Waterfox/razbot/Documentation/Pictures/2014-11-12 20.54.26.jpg

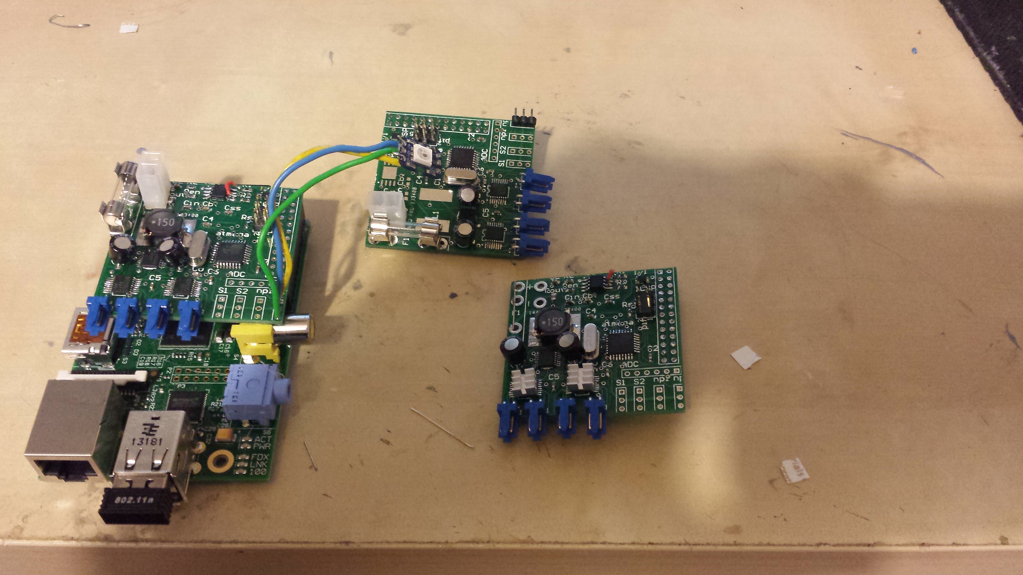
Documentation/Pictures/2014-11-12 20.54.26.jpg
