Waterfox/razbot/Documentation/Pictures/IMG_1995.JPG

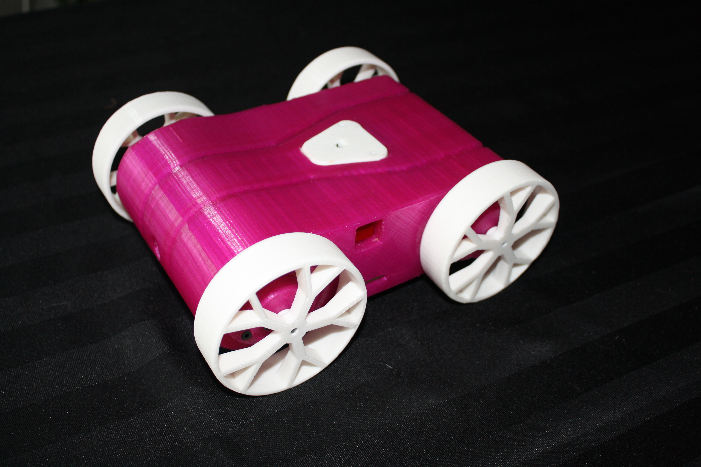
Documentation/Pictures/IMG_1995.JPG
