Waterfox/razbot/Documentation/Pictures/IMG_1996.JPG

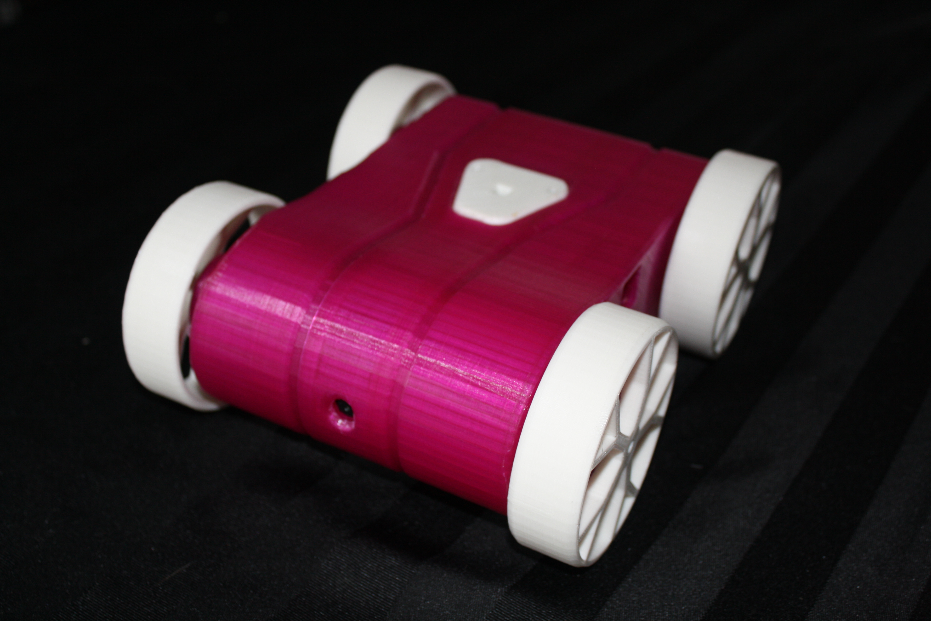
Documentation/Pictures/IMG_1996.JPG
