Waterfox/razbot/Documentation/Pictures/IMG_1997.JPG

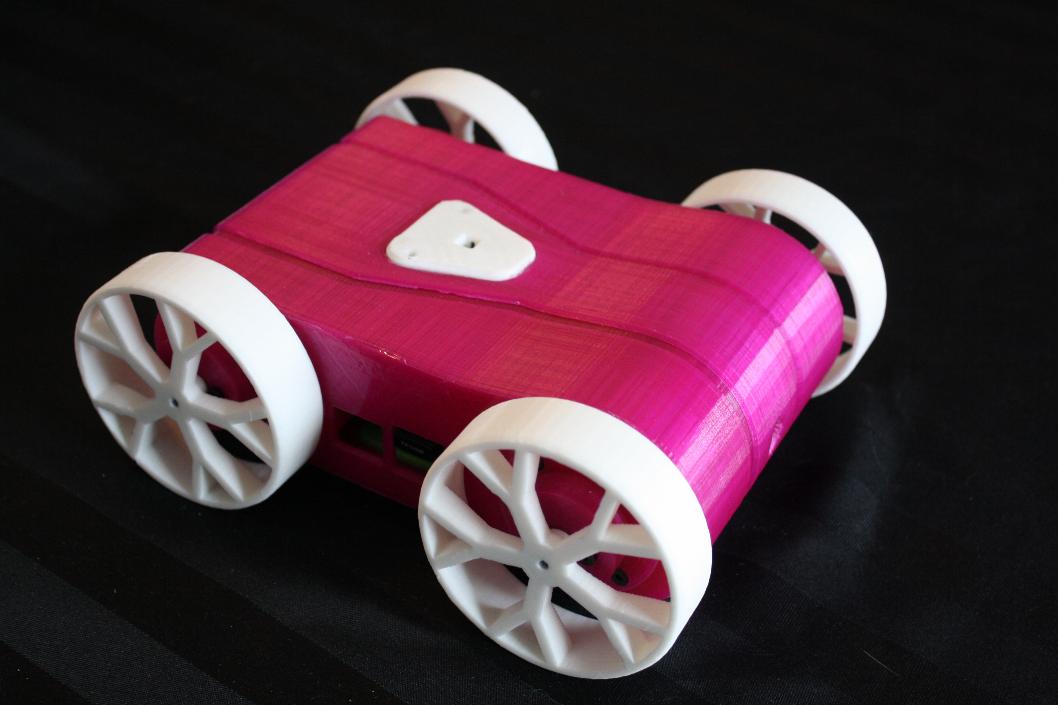
Documentation/Pictures/IMG_1997.JPG
