Waterfox/razbot/Documentation/Pictures/IMG_1998.JPG

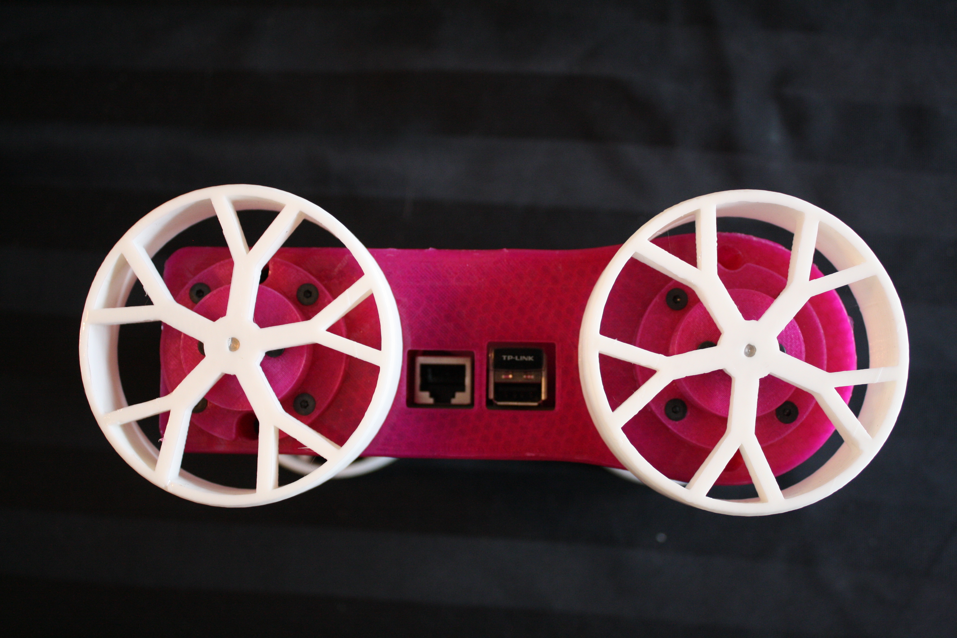
Documentation/Pictures/IMG_1998.JPG
