Waterfox/razbot/Documentation/Pictures/IMG_1999.JPG

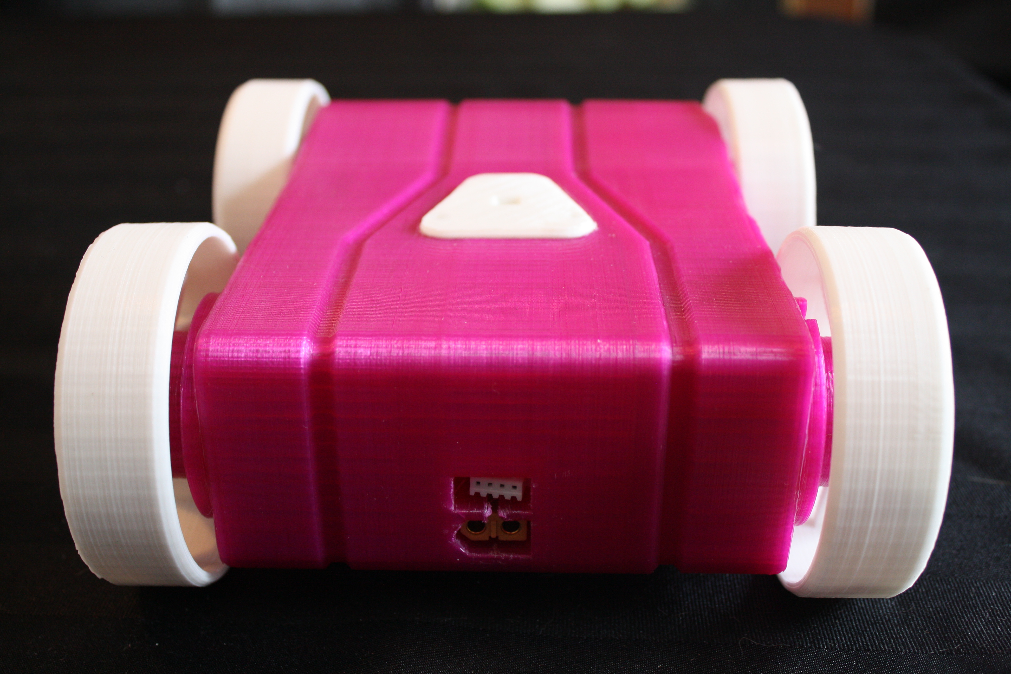
Documentation/Pictures/IMG_1999.JPG
