Waterfox/razbot/Documentation/Pictures/IMG_2000.JPG

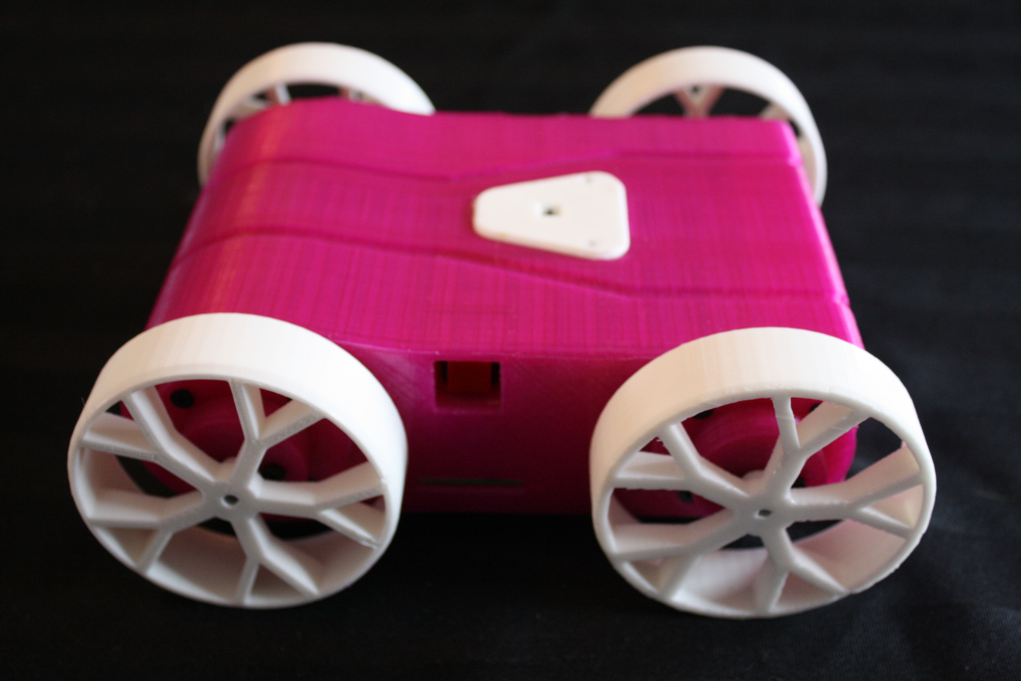
Documentation/Pictures/IMG_2000.JPG
