Waterfox/razbot/Documentation/Pictures/IMG_2001.JPG

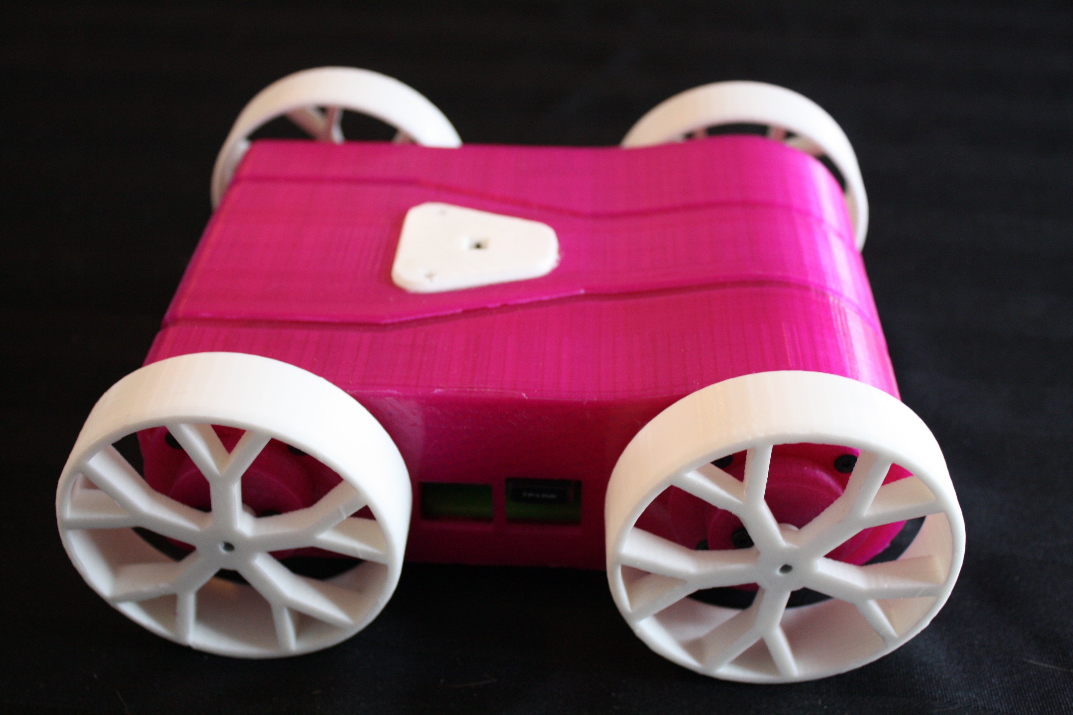
Documentation/Pictures/IMG_2001.JPG
