Waterfox/razbot/Documentation/Pictures/IMG_2002.JPG

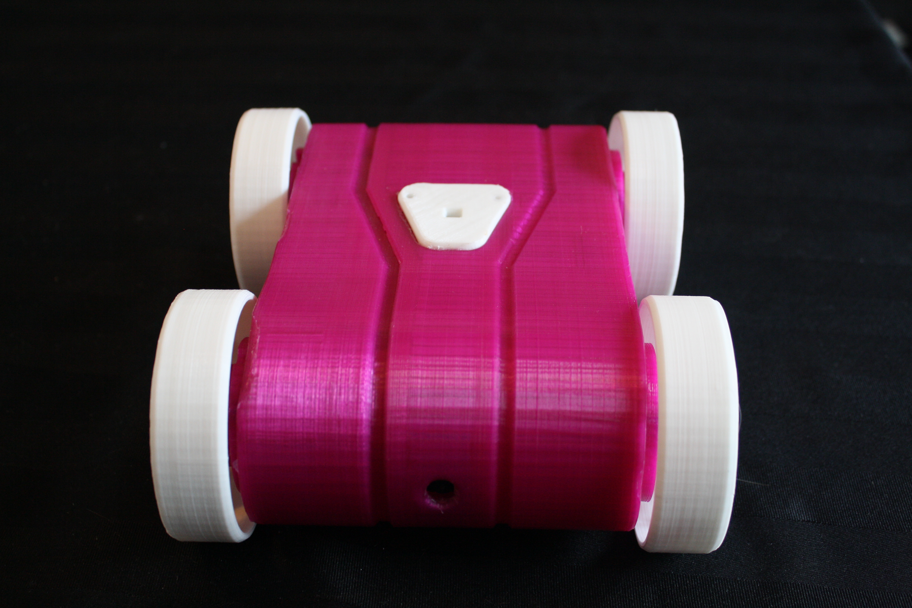
Documentation/Pictures/IMG_2002.JPG
