Waterfox/razbot/Documentation/Pictures/IMG_2003.JPG

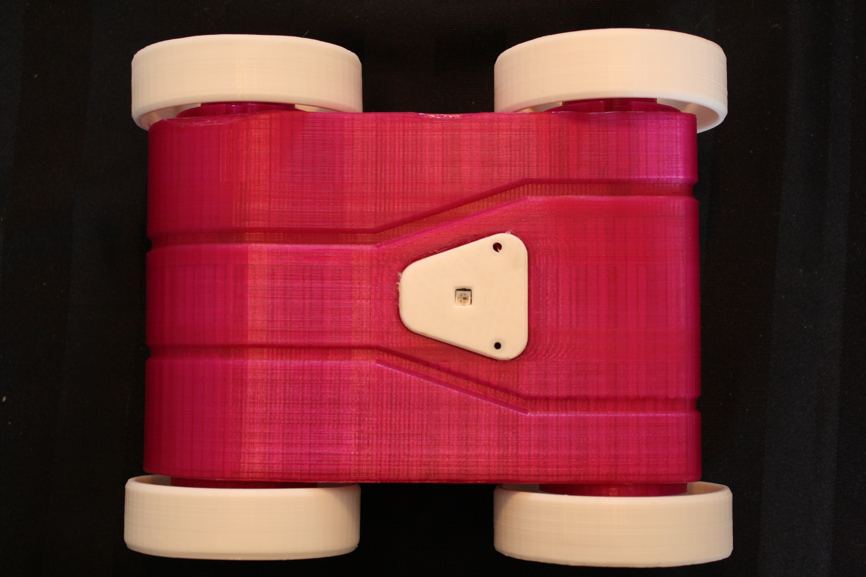
Documentation/Pictures/IMG_2003.JPG
