Waterfox/razbot/Documentation/Pictures/IMG_2514.JPG

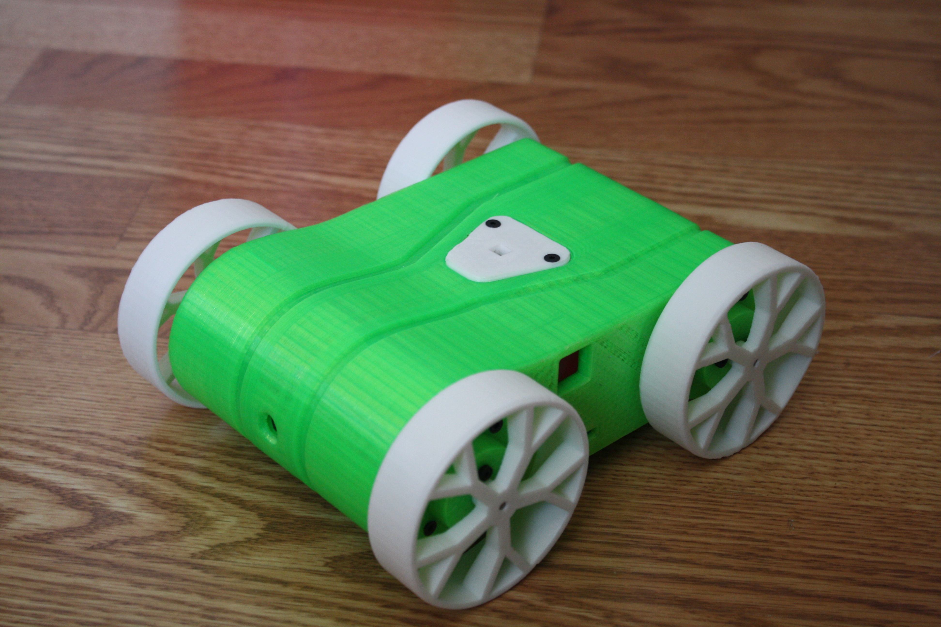
Documentation/Pictures/IMG_2514.JPG
