Waterfox/razbot/Documentation/Pictures/IMG_2515.JPG

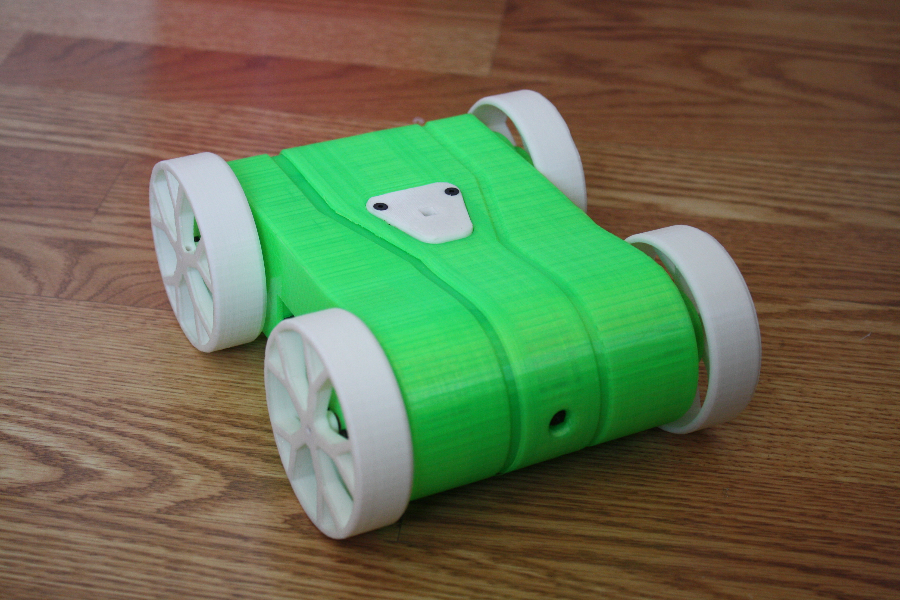
Documentation/Pictures/IMG_2515.JPG
