Waterfox/razbot/Documentation/Pictures/IMG_2516.JPG

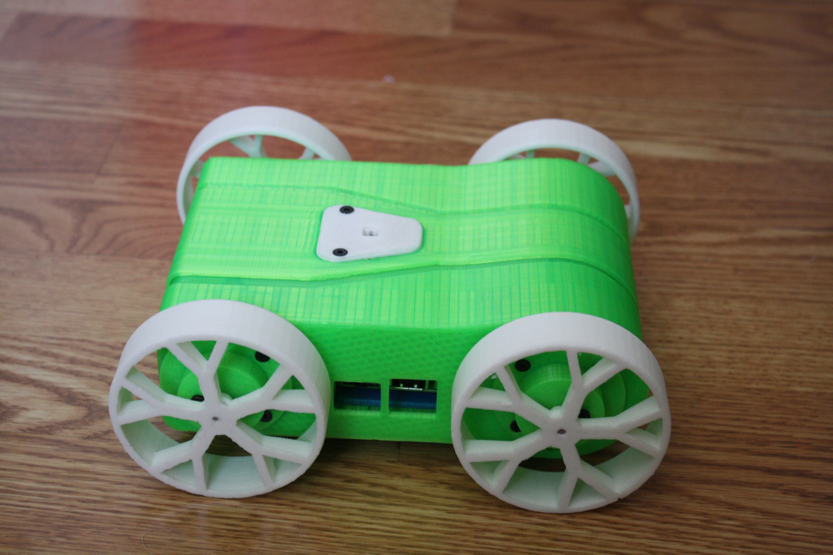
Documentation/Pictures/IMG_2516.JPG
