Waterfox/razbot/Documentation/Pictures/IMG_2517.JPG

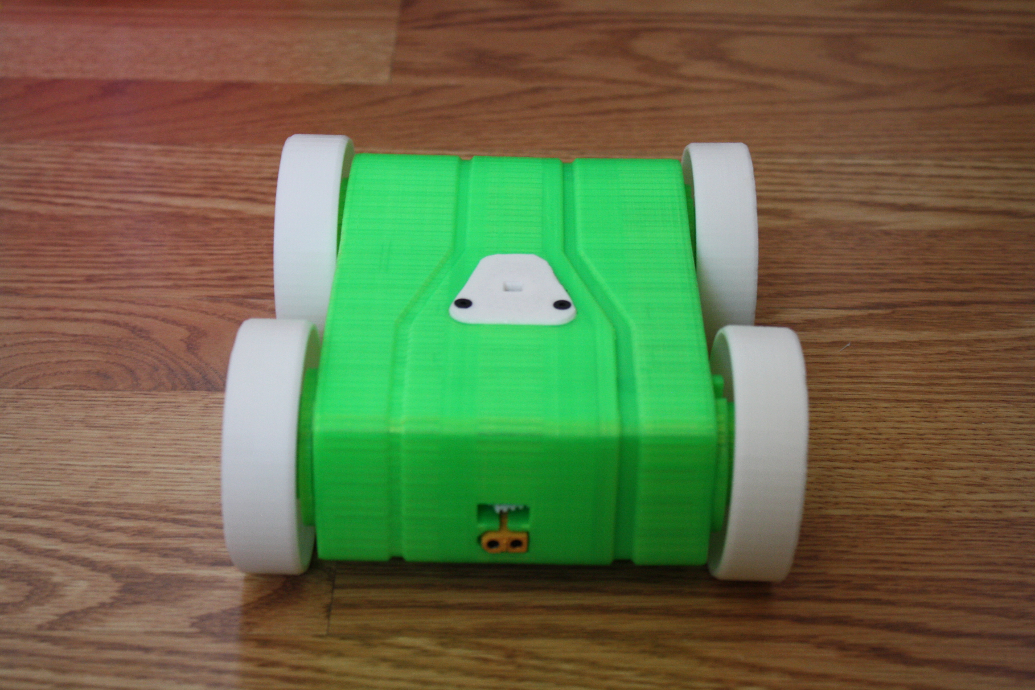
Documentation/Pictures/IMG_2517.JPG
