Waterfox/razbot/Documentation/Pictures/IMG_2874.JPG

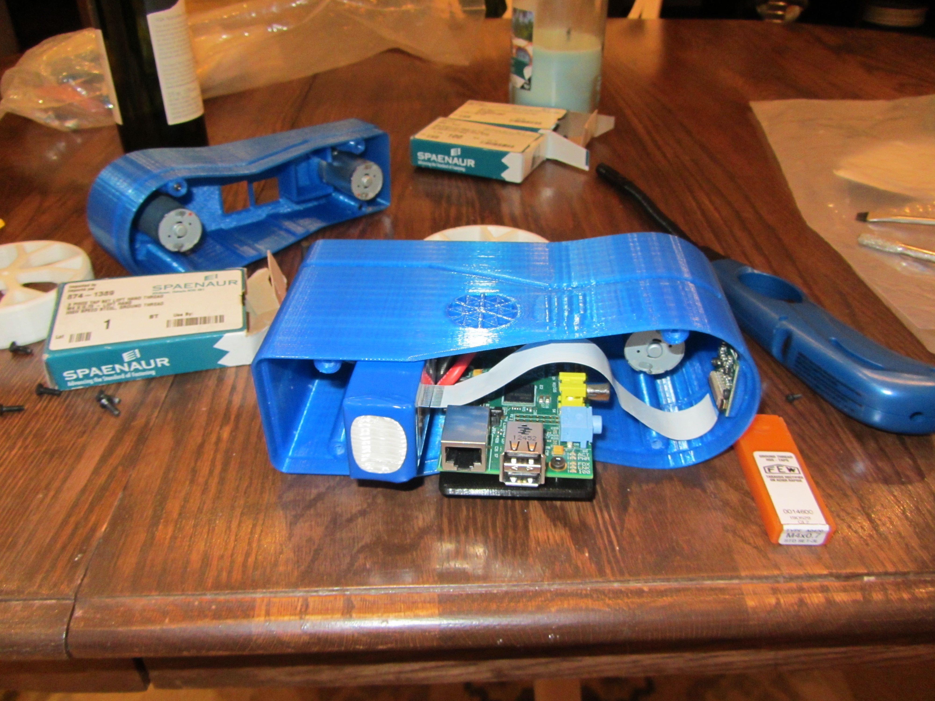
Documentation/Pictures/IMG_2874.JPG
