Waterfox/razbot/Documentation/Pictures/IMG_2875.JPG

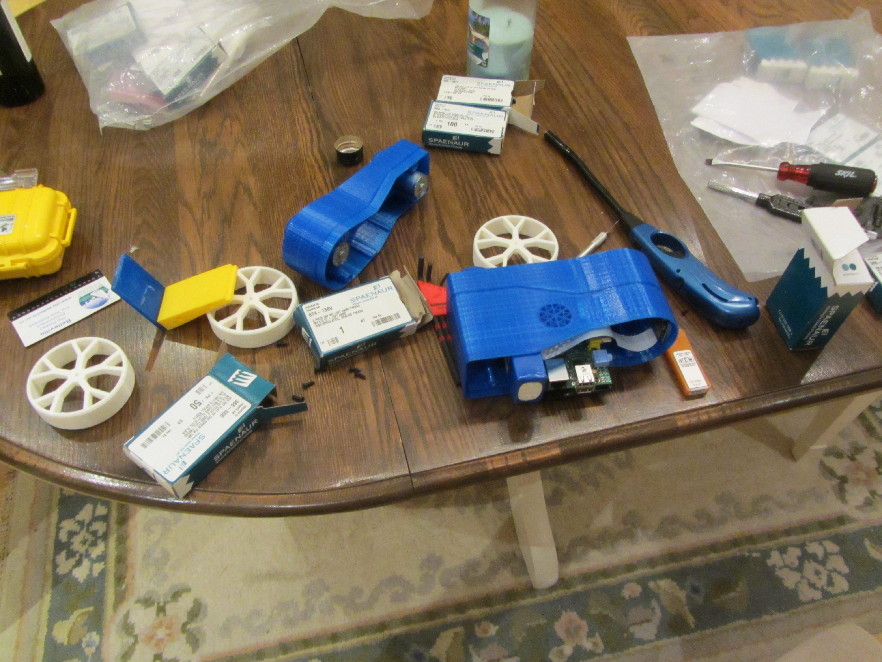
Documentation/Pictures/IMG_2875.JPG
