Waterfox/razbot/Documentation/Pictures/IMG_2878.JPG

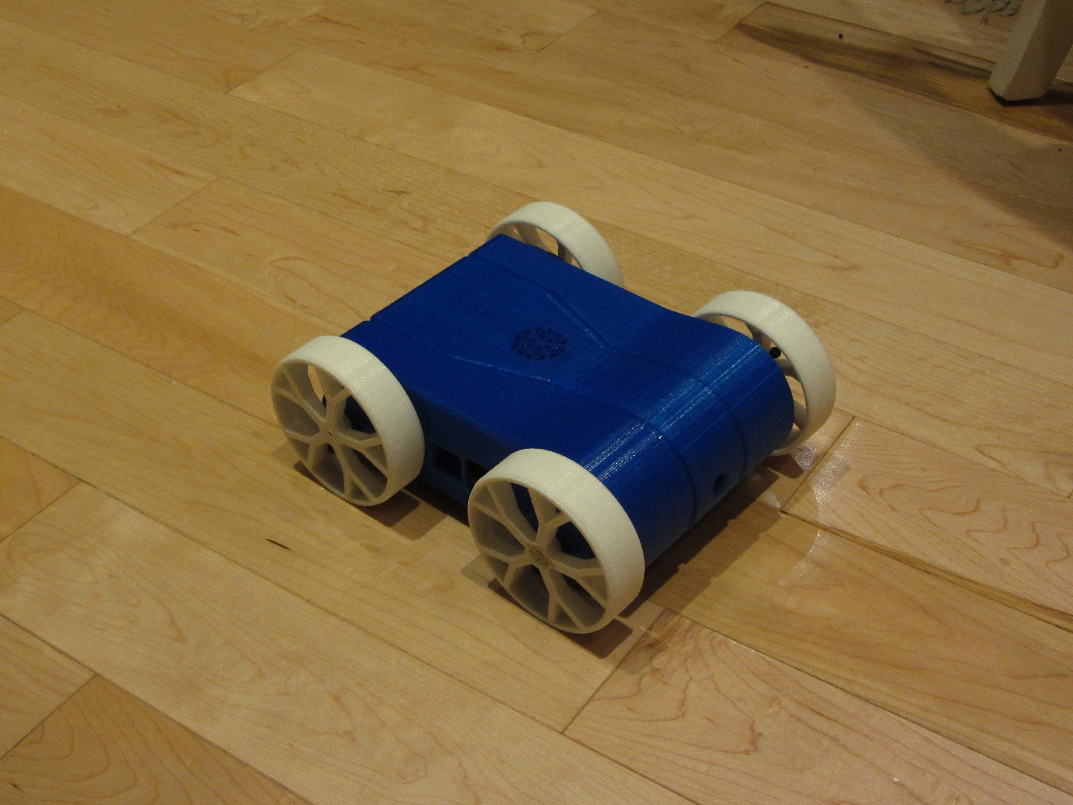
Documentation/Pictures/IMG_2878.JPG
