Waterfox/razbot/Documentation/Pictures/IMG_2879.JPG

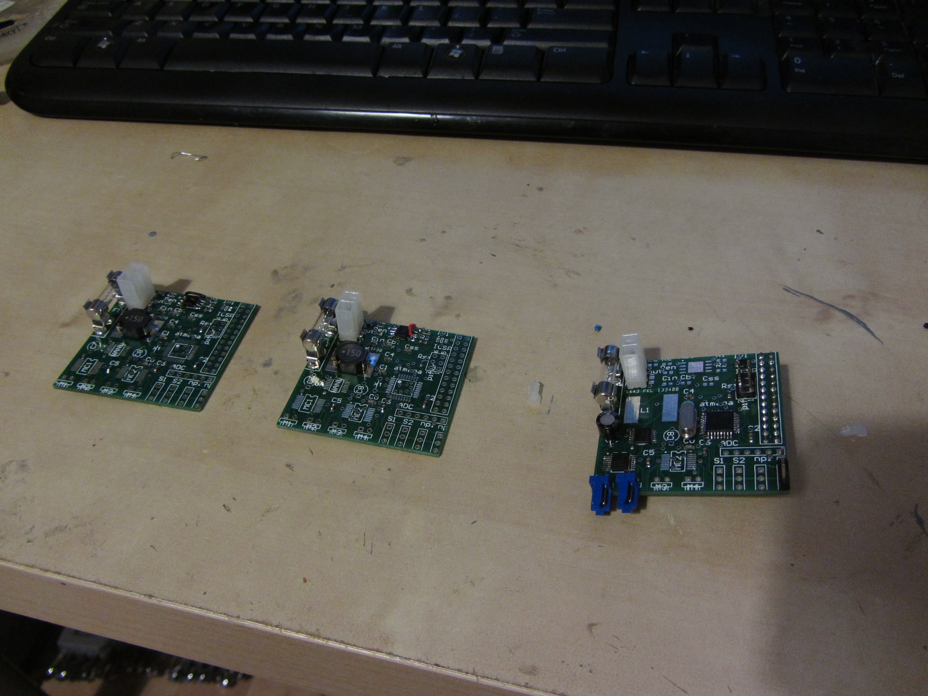
Documentation/Pictures/IMG_2879.JPG
