Waterfox/razbot/Documentation/Pictures/IMG_3035.JPG

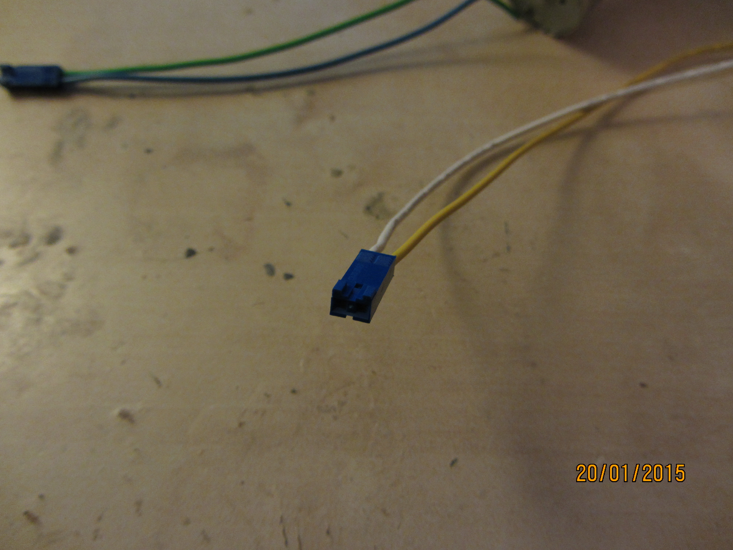
Documentation/Pictures/IMG_3035.JPG
