Waterfox/razbot/Documentation/Pictures/IMG_3036.JPG

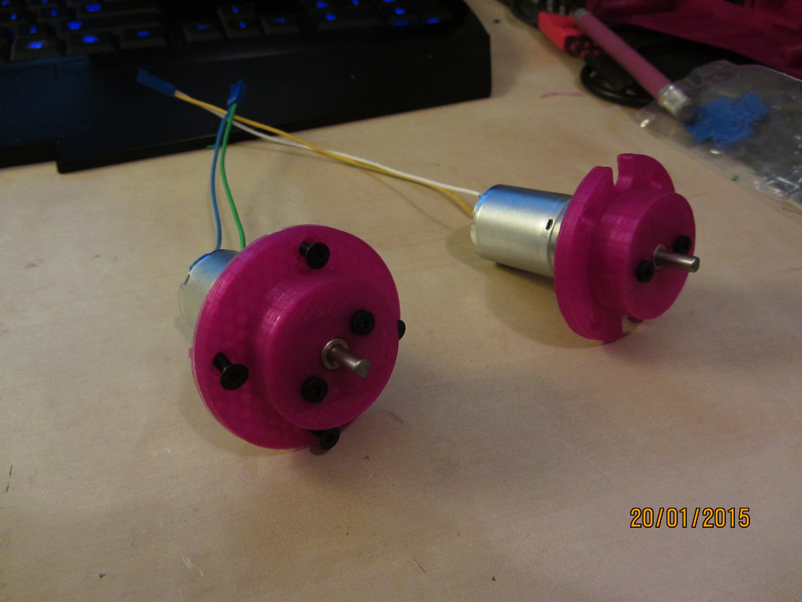
Documentation/Pictures/IMG_3036.JPG
