Waterfox/razbot/Documentation/Pictures/IMG_3037.JPG

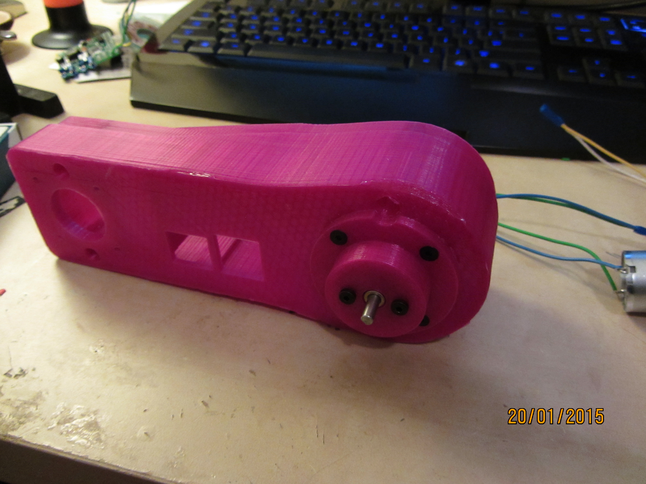
Documentation/Pictures/IMG_3037.JPG
