Waterfox/razbot/Documentation/Pictures/IMG_3039.JPG

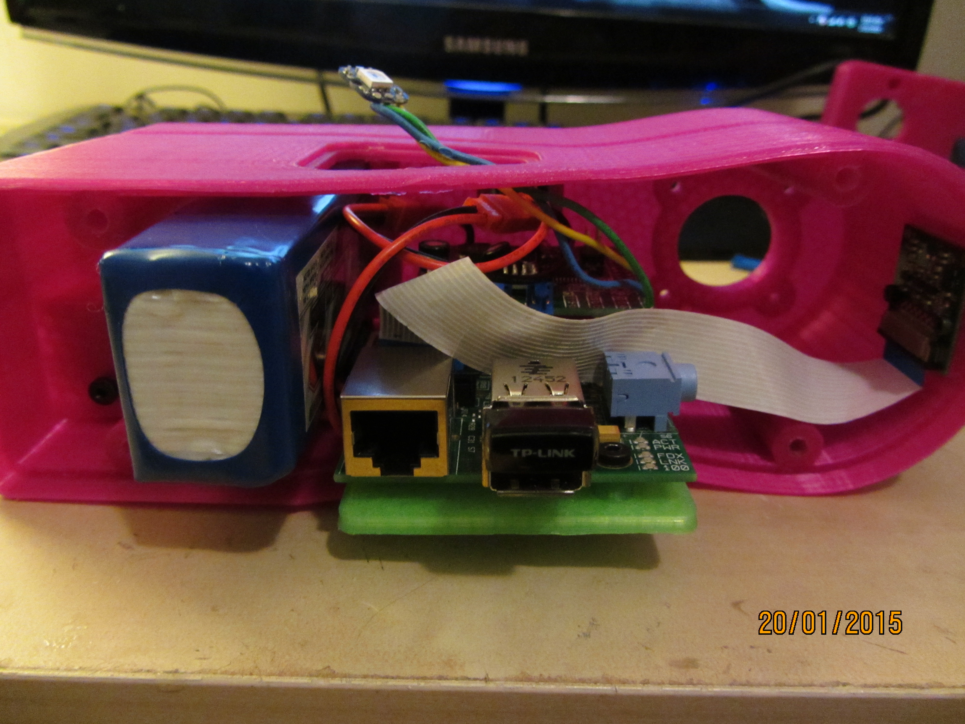
Documentation/Pictures/IMG_3039.JPG
