Waterfox/razbot/Documentation/Pictures/razbot3.jpg

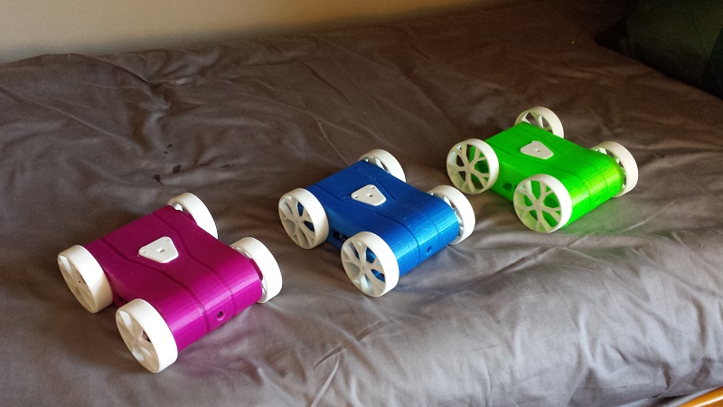
Documentation/Pictures/razbot3.jpg
