Waterfox/razbot/razbot_CAD/raspberry_pi_camera/RasPi_Camera.SLDASM

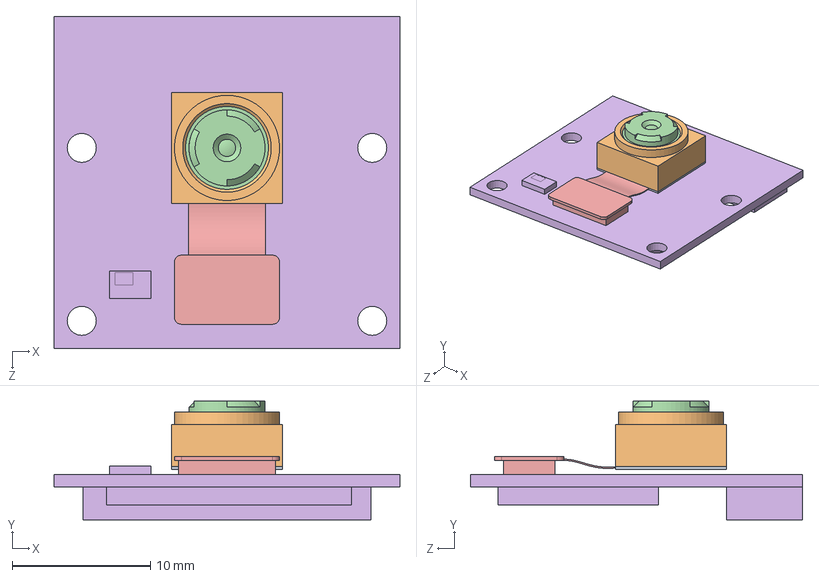
[picture p25: CAD file, 2015-07-30]
razbot_CAD/raspberry_pi_camera/RasPi_Camera.SLDASM
25.0 x 8.60 x 24.0 mm
OVA5647
OVA5647_Housing
OVA5647_IR-Glas
OVA5647_Lens
OVA5647_Pigtail
RasPi_Camera_Board
