Waterfox/razbot/razbot_CAD/Side_Assem_Right.SLDASM

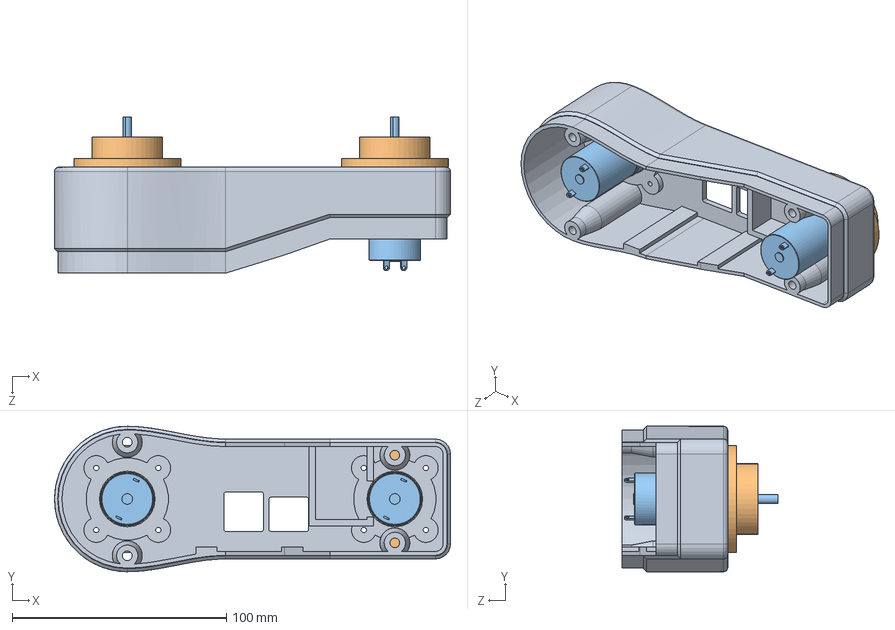
[picture p26: CAD file, 2015-07-30]
razbot_CAD/Side_Assem_Right.SLDASM
185.0 x 68.0 x 73.0 mm
Side_Right
motor_holder_r0.4 x 2
Motor_25x55_gear x 2
