Waterfox/razbot/razbot_CAD/Side_Assem_Left.SLDASM

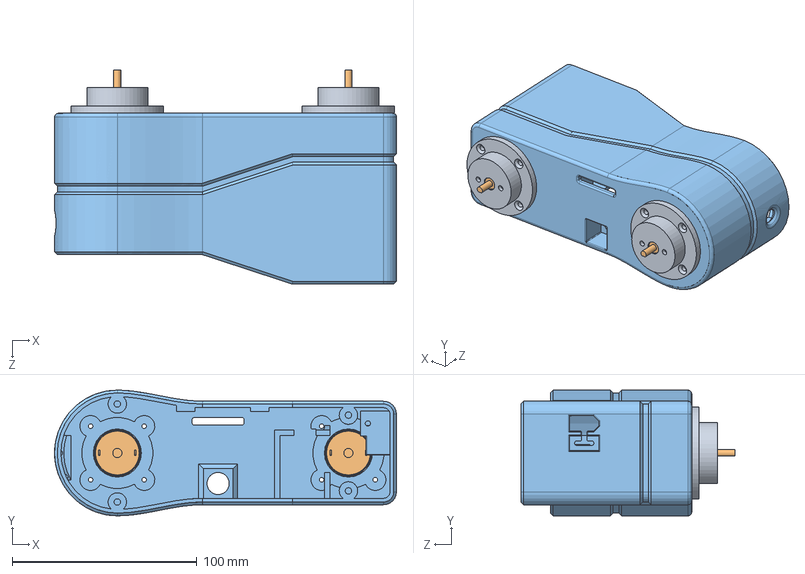
[picture p27: CAD file, 2015-07-30]
razbot_CAD/Side_Assem_Left.SLDASM
185.0 x 68.0 x 116.0 mm
motor_holder_r0.4 x 2
Motor_25x55_gear x 2
Side_Left
