Waterfox/razbot/razbot_CAD/razbot_simple.SLDASM

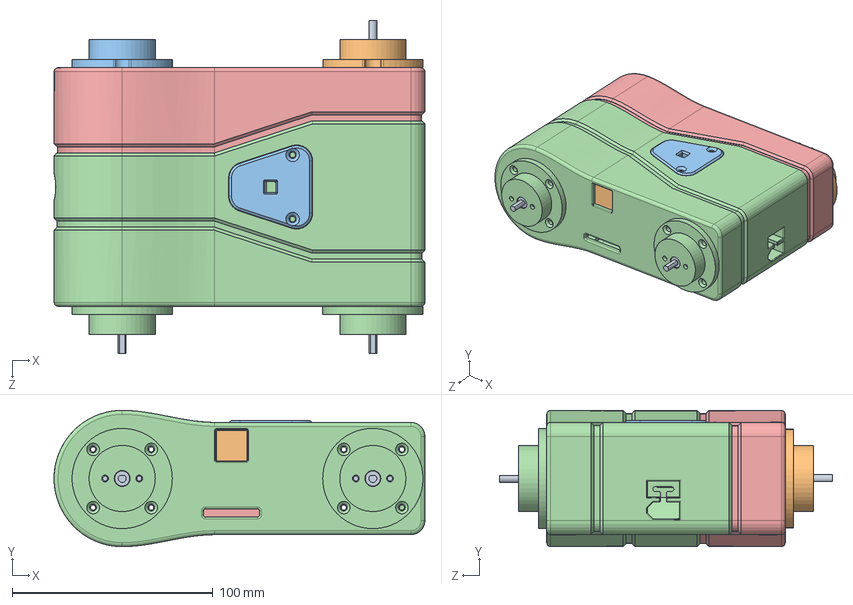
[picture p29: CAD file, 2015-03-07]
razbot_CAD/razbot_simple.SLDASM
185.0 x 68.0 x 166.0 mm
25x55_gear_motor x 3
motor_holder_r0.5
motor_holder_r0.4 x 2
OVA5647
OVA5647_Housing
OVA5647_IR-Glas
OVA5647_Lens
OVA5647_Pigtail
switch_pwr
Top_Plate2
Side_Left_2
Side_Right_2
