Waterfox/razbot/razbot_CAD/Motor_Assem.SLDASM

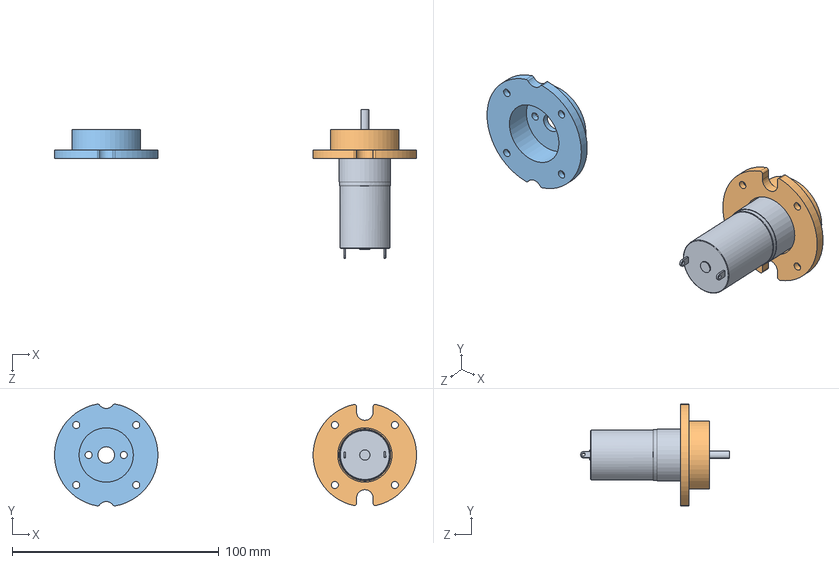
[picture p30: CAD file, 2015-03-07]
razbot_CAD/Motor_Assem.SLDASM
175.0 x 49.3 x 71.9 mm
25x55_gear_motor
motor_holder_r0.5
