Waterfox/razbot/razbot_CAD/raspberry_pi/raspberry_pi__USB_x2.SLDASM

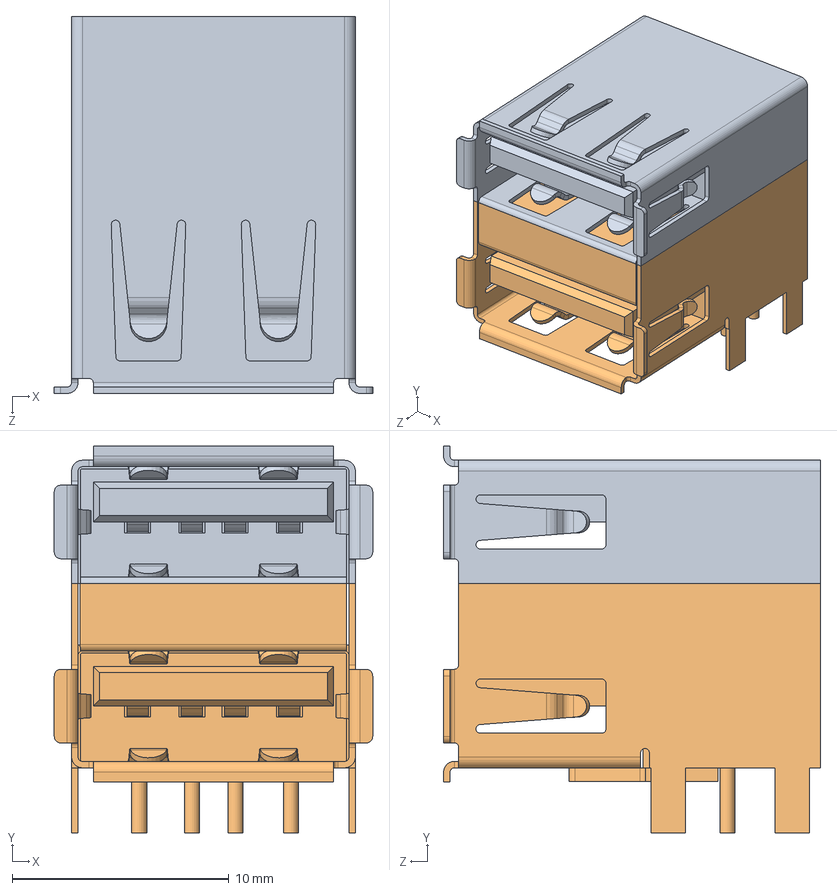
[picture p31: CAD file, 2015-07-30]
razbot_CAD/raspberry_pi/raspberry_pi__USB_x2.SLDASM
14.7 x 17.9 x 17.4 mm
raspberry_pi__USB_x2_part1
raspberry_pi__USB_x2_part2
