Waterfox/razbot/razbot_CAD/raspberry_pi/raspberry_pi__15_pin_FFC_Connector.SLDASM

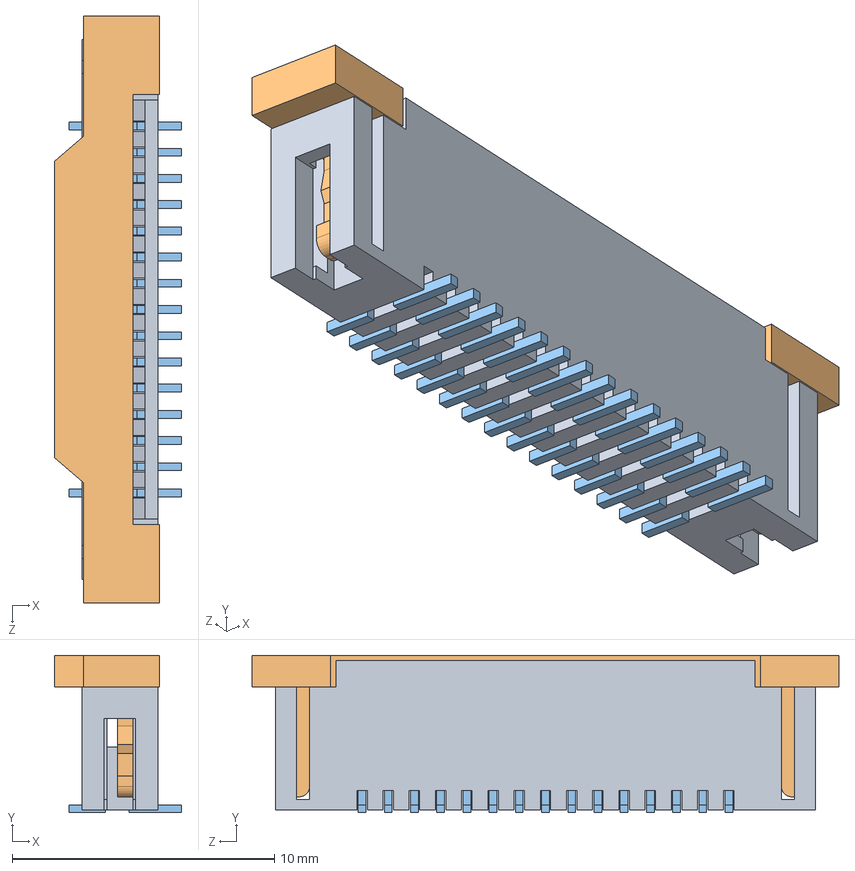
[picture p35: CAD file, 2015-07-30]
razbot_CAD/raspberry_pi/raspberry_pi__15_pin_FFC_Connector.SLDASM
4.85 x 6.00 x 22.4 mm
raspberry_pi__15_pin_FFC_Connector_body
raspberry_pi__15_pin_FFC_Connector_locker
raspberry_pi__15_pin_FFC_Connector_pins x 15
