Waterfox/razbot/razbot_CAD/raspberry_pi/raspberry_pi__micro_USB.SLDASM

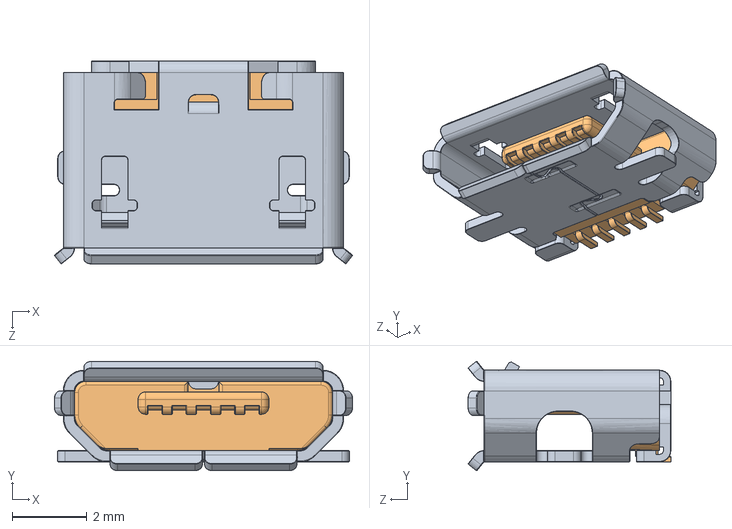
[picture p36: CAD file, 2015-07-30]
razbot_CAD/raspberry_pi/raspberry_pi__micro_USB.SLDASM
7.97 x 2.92 x 5.43 mm
raspberry_pi__micro_USB_cover
raspberry_pi__micro_USB_contacts
