Waterfox/razbot/razbot_CAD/gazeboSTL/wheel_3.STL

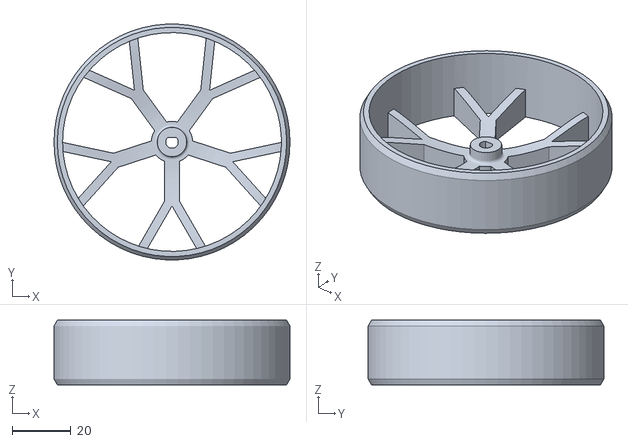
[picture p37: CAD file, 2015-03-07]
razbot_CAD/gazeboSTL/wheel_3.STL
80.0 x 79.9 x 22.0
