Waterfox/razbot/razbot_CAD/Motor_25x55_gear.SLDPRT

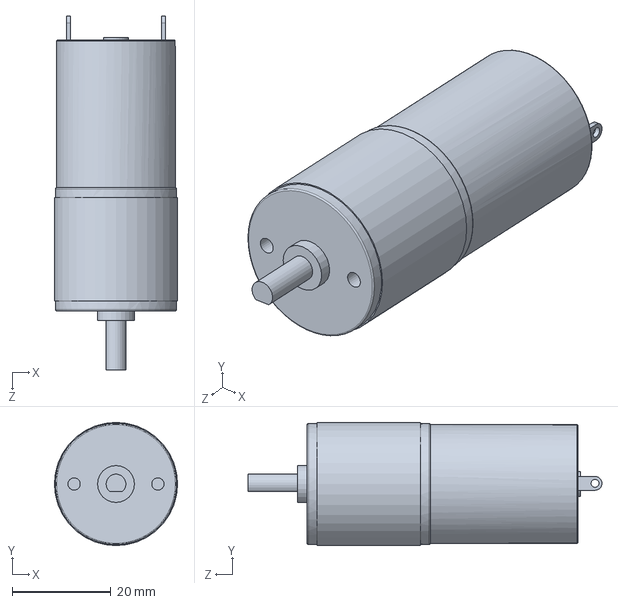
[picture p38: CAD file, 2015-07-30]
razbot_CAD/Motor_25x55_gear.SLDPRT
25.0 x 25.0 x 71.9 mm
