Waterfox/razbot/razbot_CAD/raspberry_pi/raspberry_pi__15_pin_FFC_Connector_locker.SLDPRT

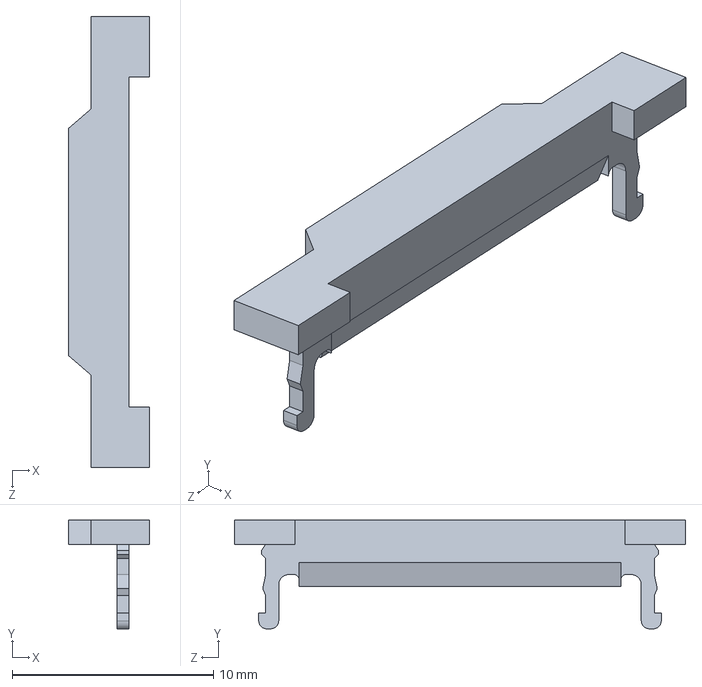
[picture p39: CAD file, 2015-07-30]
razbot_CAD/raspberry_pi/raspberry_pi__15_pin_FFC_Connector_locker.SLDPRT
4.00 x 5.40 x 22.4 mm
