Waterfox/razbot/razbot_CAD/raspberry_pi_acc/USBwifi.SLDPRT

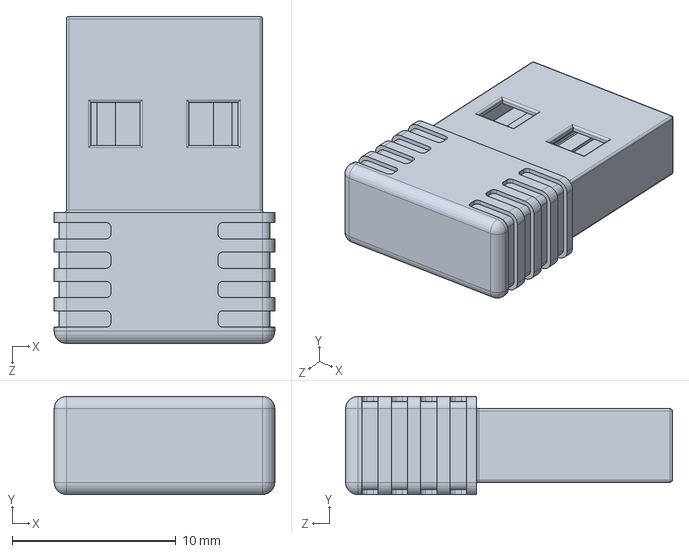
[picture p40: CAD file, 2015-07-30]
razbot_CAD/raspberry_pi_acc/USBwifi.SLDPRT
13.5 x 6.00 x 20.0 mm
