Waterfox/razbot/razbot_CAD/raspberry_pi_camera/OVA5647_IR-Glas.SLDPRT

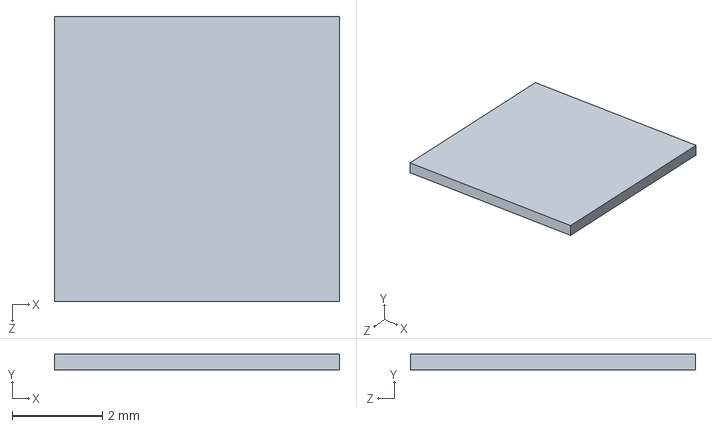
[picture p41: CAD file, 2015-07-30]
razbot_CAD/raspberry_pi_camera/OVA5647_IR-Glas.SLDPRT
6.30 x 0.35 x 6.30 mm
