Waterfox/razbot/razbot_CAD/razbot_STL/PiTrayB+.STL

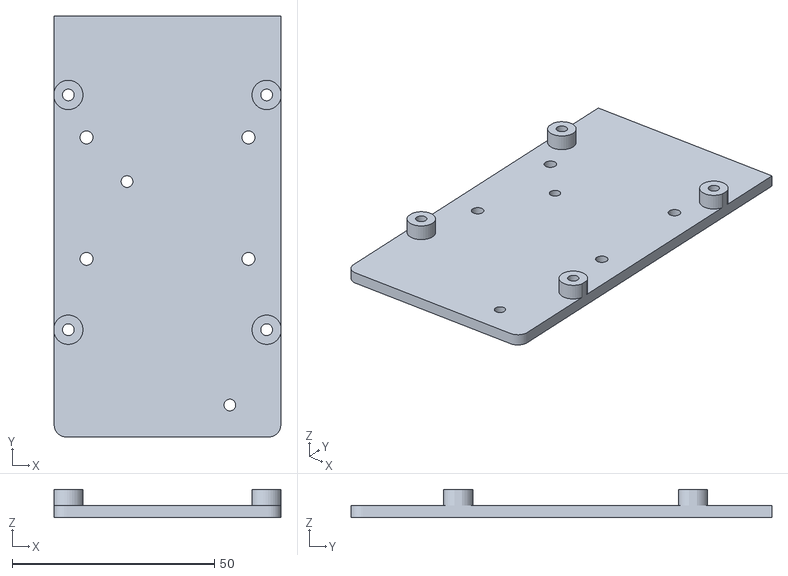
[picture p42: CAD file, 2015-03-08]
razbot_CAD/razbot_STL/PiTrayB+.STL
56.0 x 104.0 x 7.00
