Waterfox/razbot/razbot_Software_RPi/Razbot_URDF/razbotURDF/meshes/wheel_1_link.STL

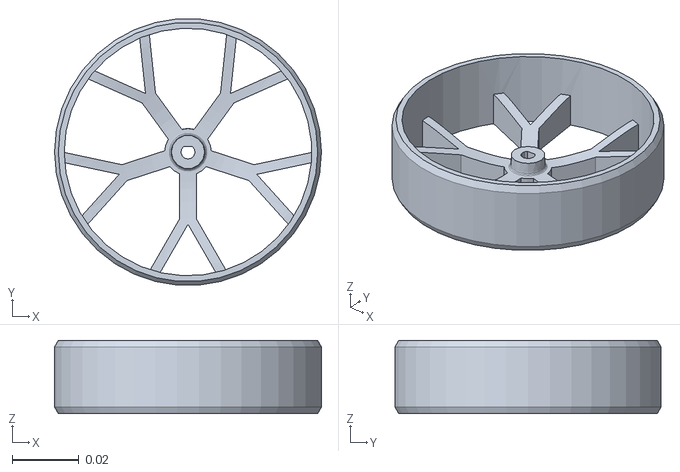
[picture p43: CAD file, 2015-07-30]
razbot_Software_RPi/Razbot_URDF/razbotURDF/meshes/wheel_1_link.STL
0.08 x 0.0797 x 0.022
