Waterfox/razbot/razbot_CAD/raspberry_pi/raspberry_pi__HDMI_socket_small_pin.SLDPRT

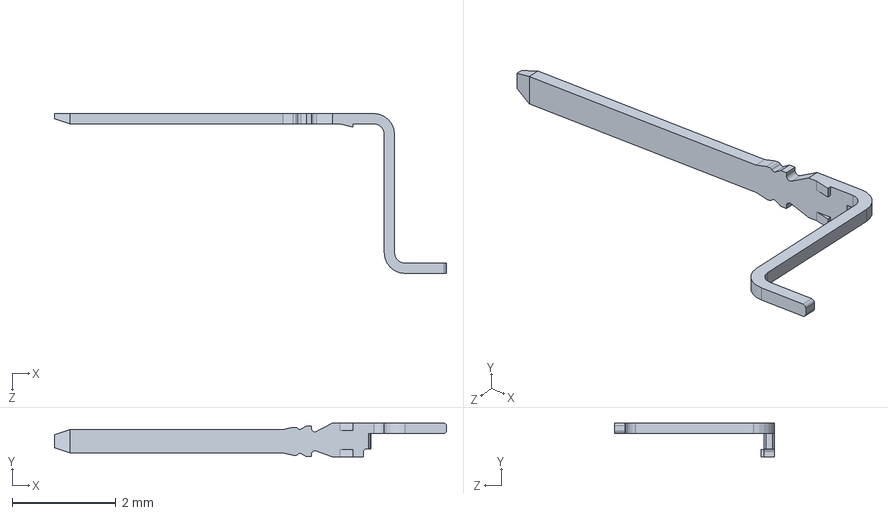
[picture p44: CAD file, 2015-07-30]
razbot_CAD/raspberry_pi/raspberry_pi__HDMI_socket_small_pin.SLDPRT
7.55 x 0.65 x 3.08 mm
