Waterfox/razbot/razbot_CAD/raspberry_pi_camera/RasPi_Camera_Board.SLDPRT

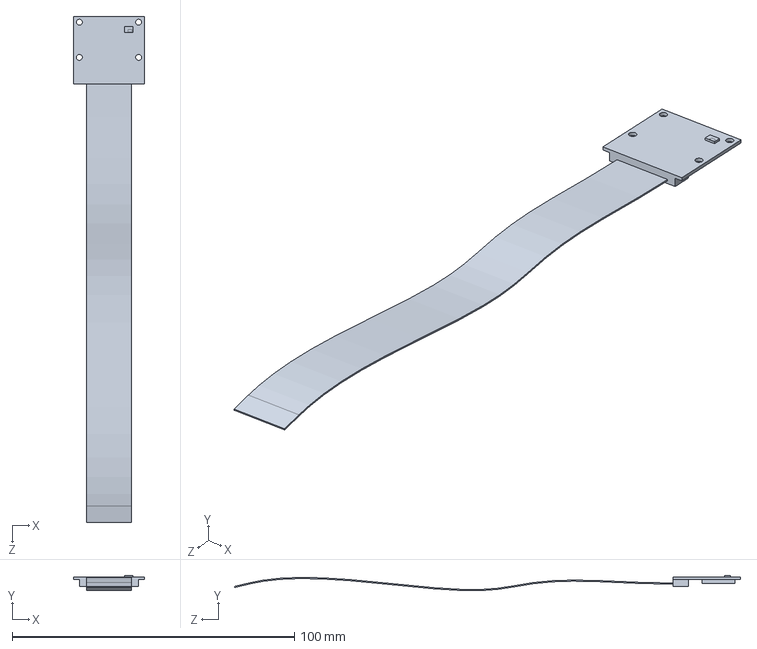
[picture p45: CAD file, 2015-07-30]
razbot_CAD/raspberry_pi_camera/RasPi_Camera_Board.SLDPRT
25.0 x 5.39 x 179.3 mm
