Waterfox/razbot/razbot_CAD/razbot_STL/L_motor_holder.STL

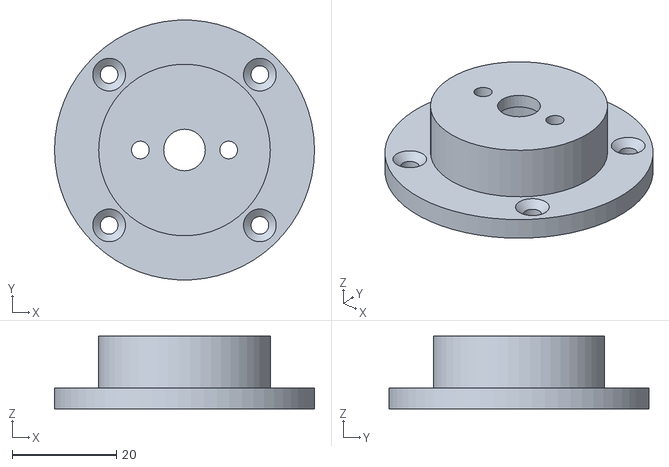
[picture p46: CAD file, 2015-03-07]
razbot_CAD/razbot_STL/L_motor_holder.STL
50.0 x 49.9 x 14.0
