Waterfox/razbot/razbot_CAD/Top_Plate.SLDPRT

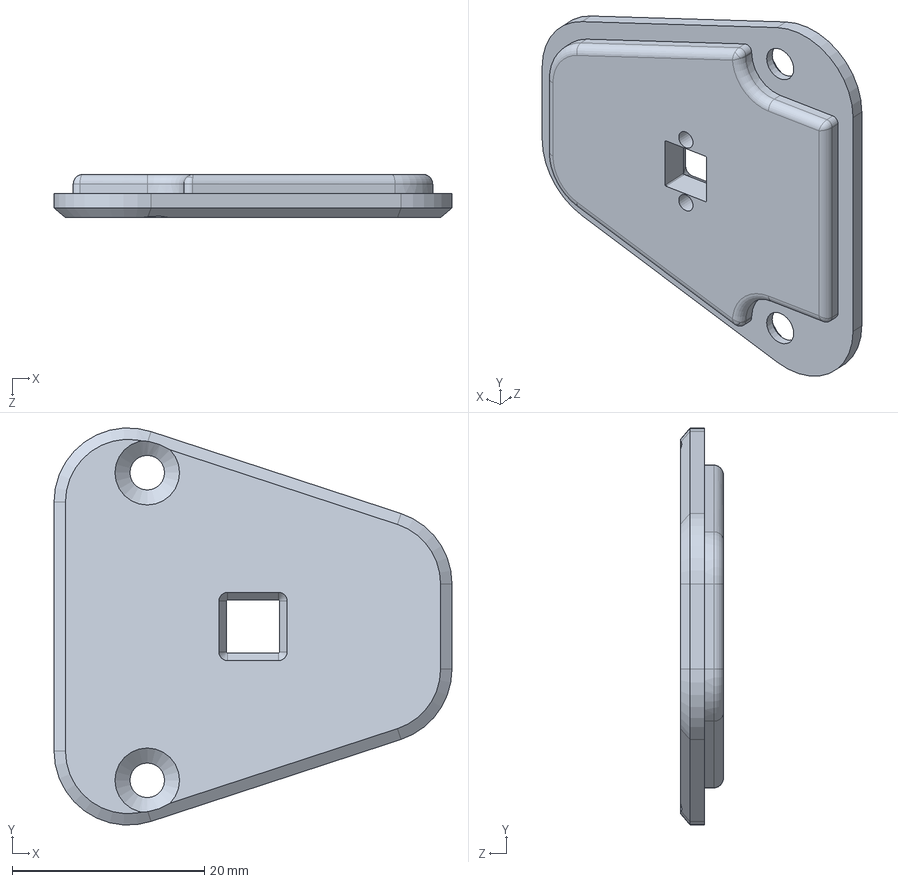
[picture p47: CAD file, 2015-07-30]
razbot_CAD/Top_Plate.SLDPRT
41.4 x 41.3 x 4.50 mm
