Waterfox/razbot/razbot_CAD/raspberry_pi/raspberry_pi__0603.SLDPRT

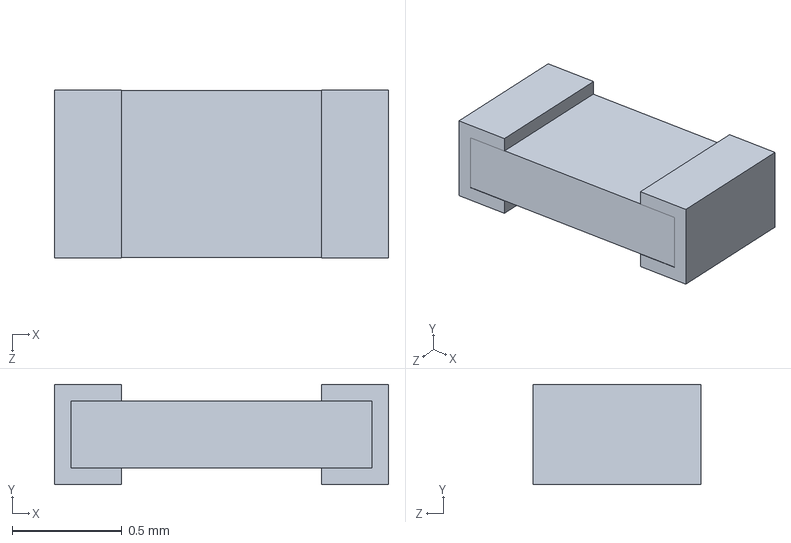
[picture p48: CAD file, 2015-07-30]
razbot_CAD/raspberry_pi/raspberry_pi__0603.SLDPRT
1.52 x 0.457 x 0.767 mm
