Waterfox/razbot/razbot_CAD/fake_pi_shield.SLDPRT

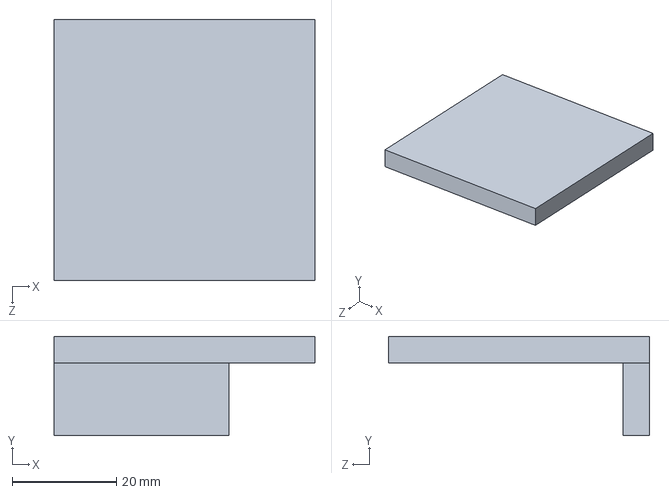
[picture p49: CAD file, 2015-07-30]
razbot_CAD/fake_pi_shield.SLDPRT
50.0 x 19.1 x 50.0 mm
