Waterfox/razbot/razbot_CAD/raspberry_pi/raspberry_pi__micro_USB_contacts.SLDPRT

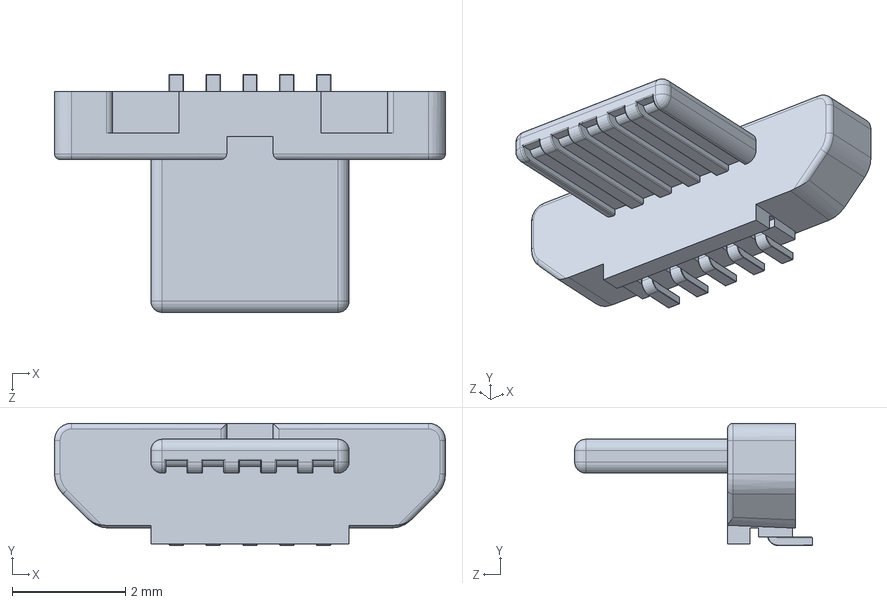
[picture p50: CAD file, 2015-07-30]
razbot_CAD/raspberry_pi/raspberry_pi__micro_USB_contacts.SLDPRT
6.90 x 2.16 x 4.20 mm
