Waterfox/razbot/razbot_CAD/raspberry_pi_camera/OVA5647_Lens.SLDPRT

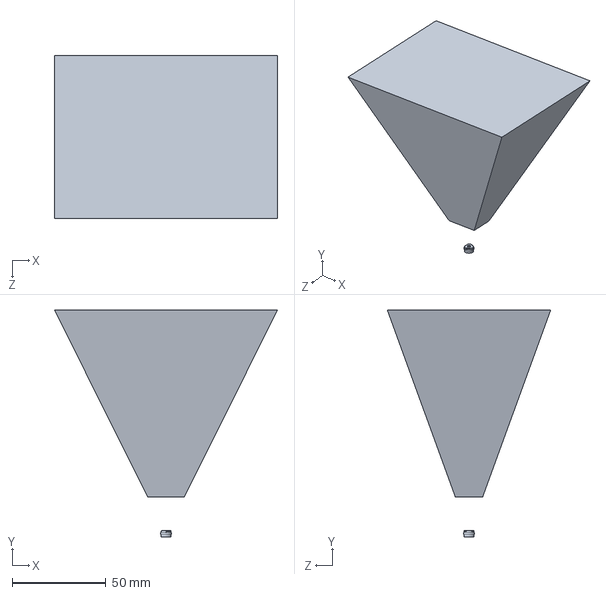
[picture p51: CAD file, 2015-07-30]
razbot_CAD/raspberry_pi_camera/OVA5647_Lens.SLDPRT
119.2 x 121.3 x 87.4 mm
