Waterfox/razbot/razbot_CAD/raspberry_pi/raspberry_pi__capacitor_smd.SLDPRT

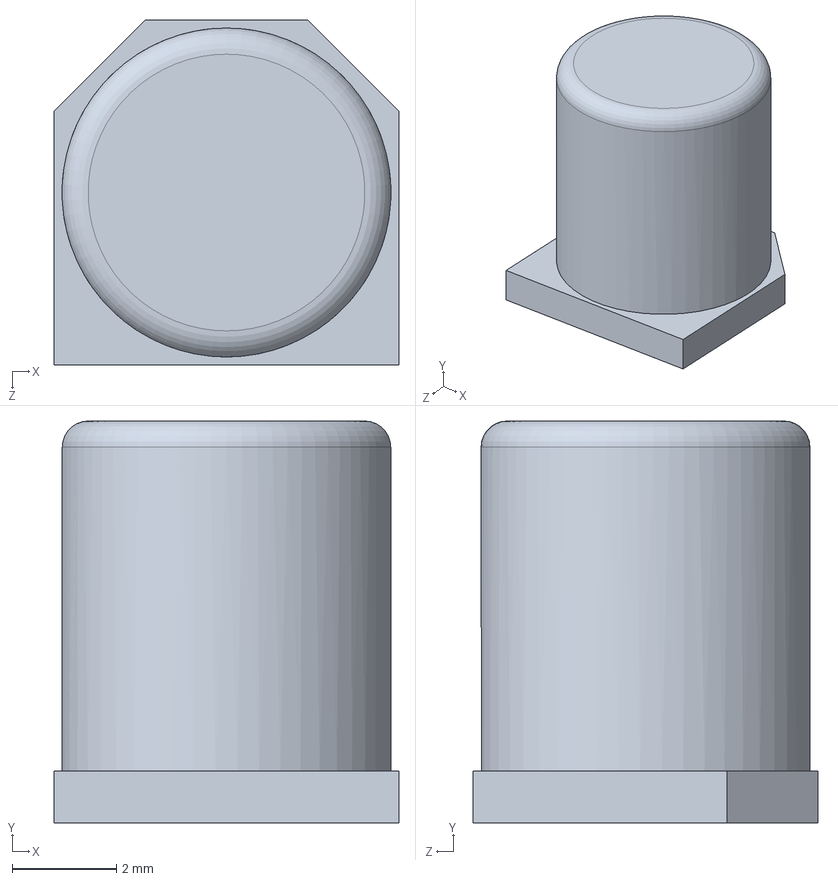
[picture p53: CAD file, 2015-07-30]
razbot_CAD/raspberry_pi/raspberry_pi__capacitor_smd.SLDPRT
6.60 x 7.70 x 6.60 mm
