Waterfox/razbot/razbot_CAD/razbot_STL/FR_motor_holder.STL

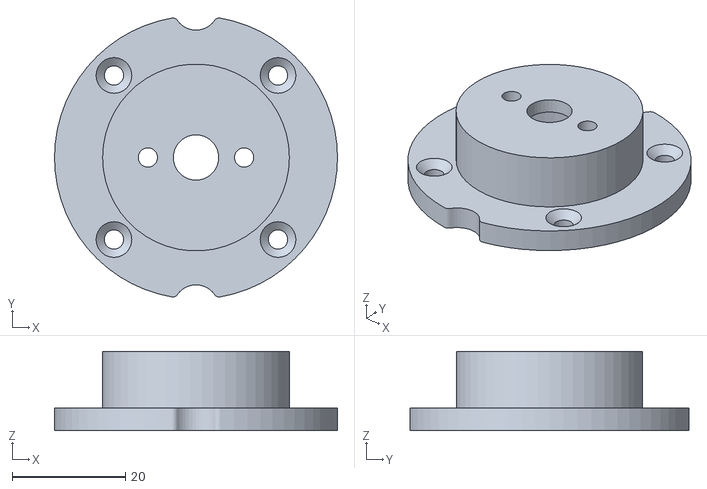
[picture p54: CAD file, 2015-03-07]
razbot_CAD/razbot_STL/FR_motor_holder.STL
50.0 x 49.3 x 14.0
