Waterfox/razbot/razbot_CAD/switch_pwr.SLDPRT

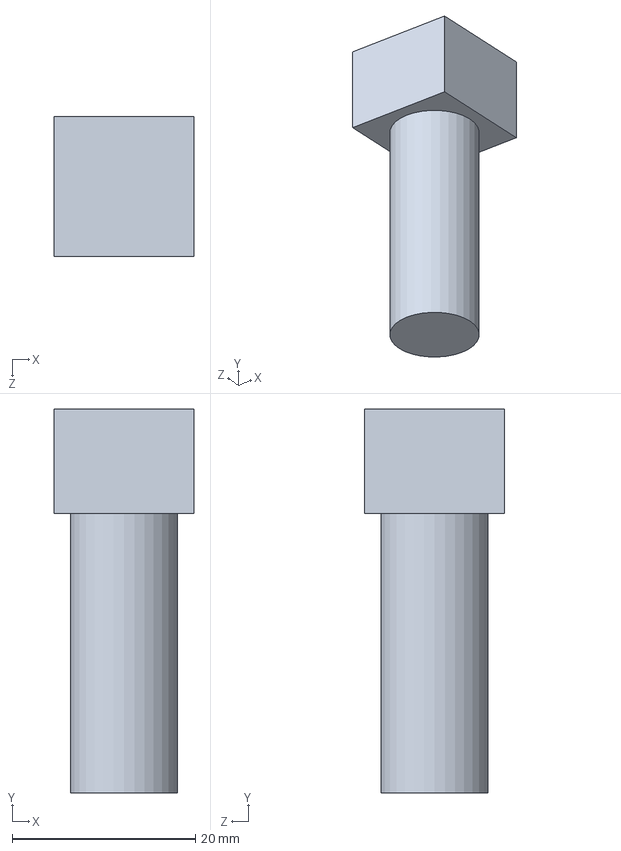
[picture p55: CAD file, 2015-07-30]
razbot_CAD/switch_pwr.SLDPRT
15.2 x 41.9 x 15.2 mm
