Waterfox/razbot/razbot_Software_RPi/Razbot_URDF/razbotURDF/meshes/chassis_link.STL

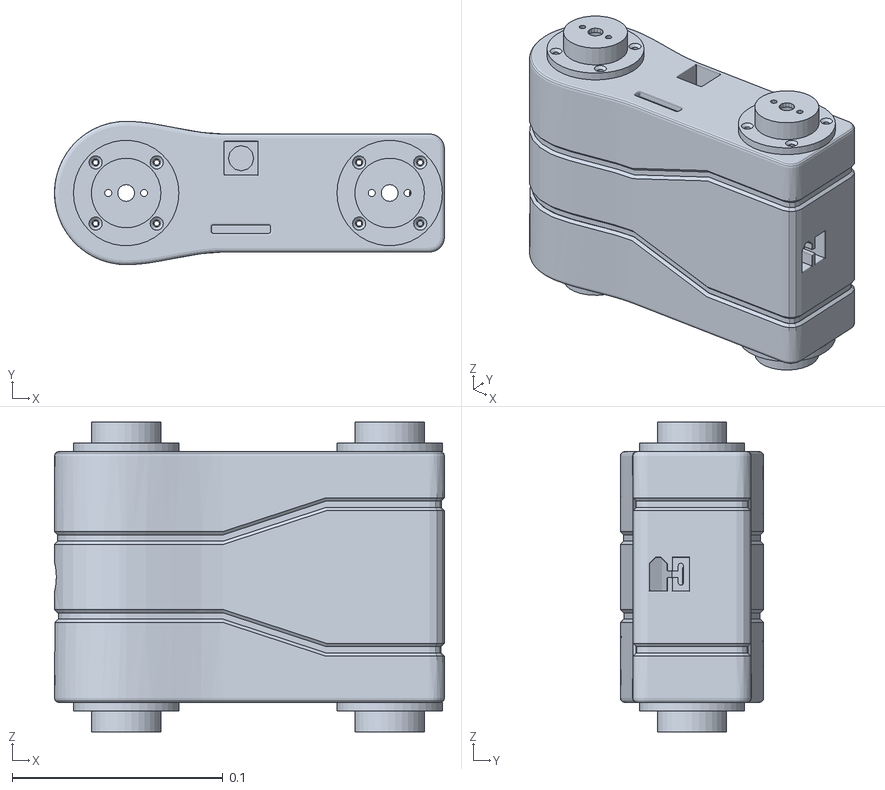
[picture p56: CAD file, 2015-07-30]
razbot_Software_RPi/Razbot_URDF/razbotURDF/meshes/chassis_link.STL
0.185 x 0.068 x 0.147
