Waterfox/razbot/razbot_CAD/raspberry_pi/raspberry_pi__composite_video_out.SLDPRT

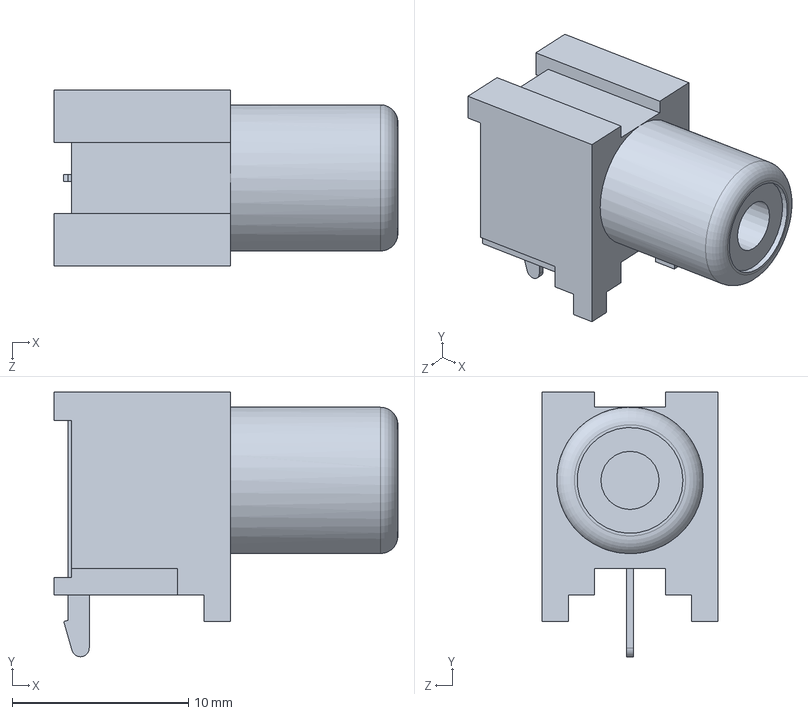
[picture p57: CAD file, 2015-07-30]
razbot_CAD/raspberry_pi/raspberry_pi__composite_video_out.SLDPRT
19.5 x 15.0 x 10.0 mm
