Waterfox/razbot/razbot_CAD/razbot_STL/Side_Left_V01.stl

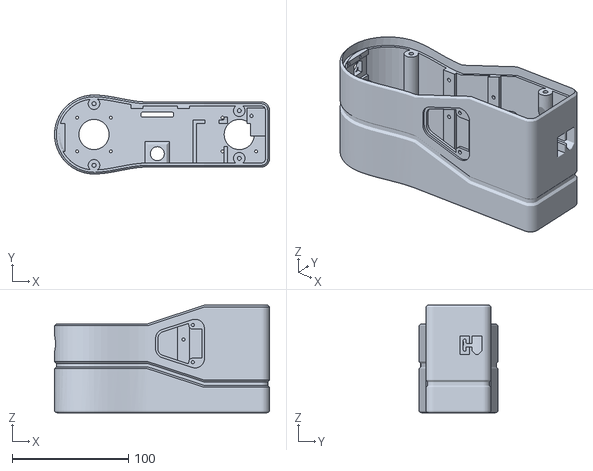
[picture p58: CAD file, 2015-03-07]
razbot_CAD/razbot_STL/Side_Left_V01.stl
185.0 x 68.0 x 92.5
