Waterfox/razbot/razbot_Software_RPi/Razbot_URDF/razbotURDF/meshes/base_link.STL

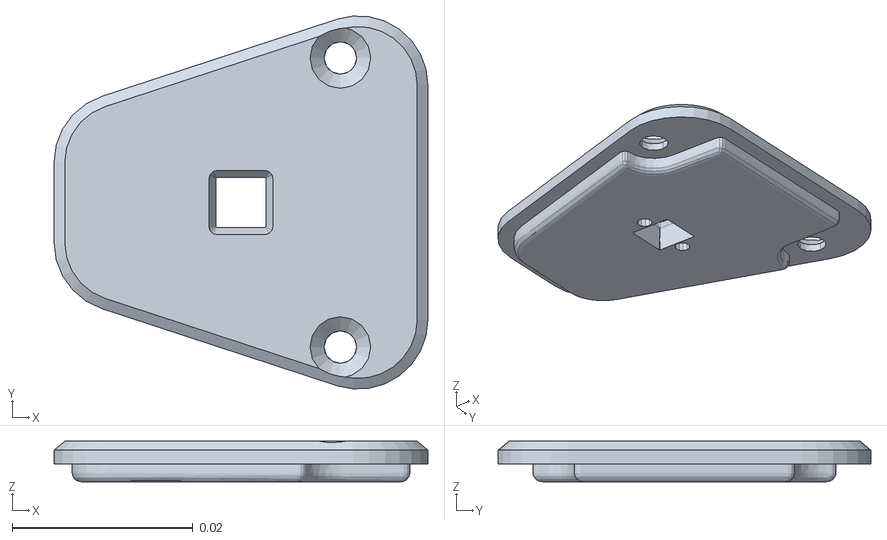
[picture p59: CAD file, 2015-07-30]
razbot_Software_RPi/Razbot_URDF/razbotURDF/meshes/base_link.STL
0.0414 x 0.0413 x 0.0045
