Waterfox/razbot/razbot_CAD/raspberry_pi/raspberry_pi__diode_10_pins.SLDPRT

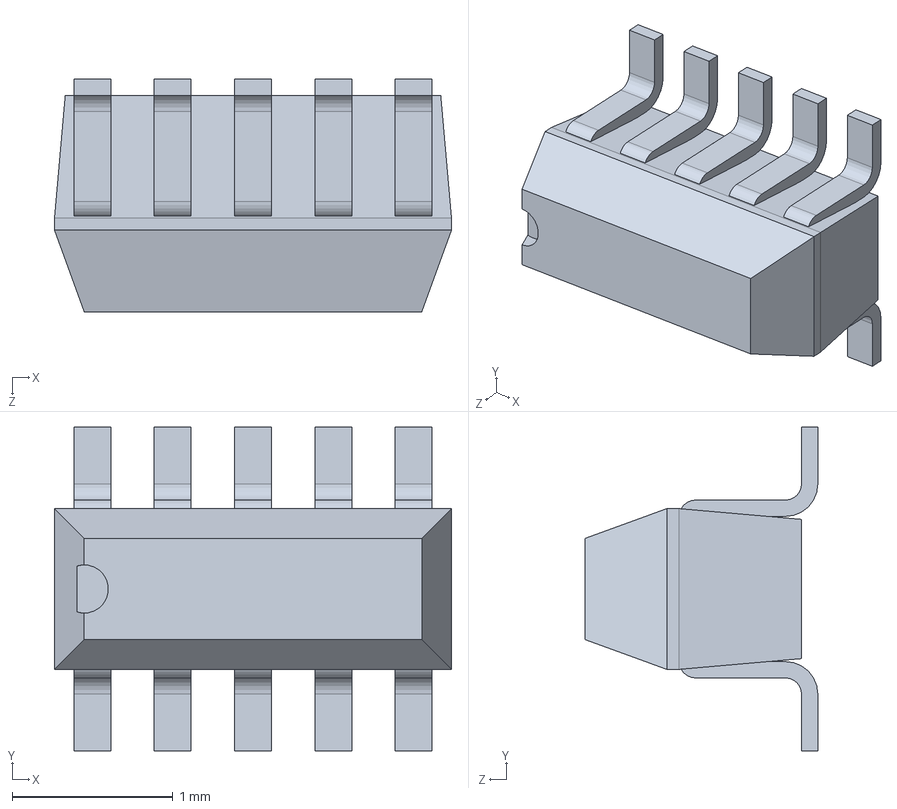
[picture p60: CAD file, 2015-07-30]
razbot_CAD/raspberry_pi/raspberry_pi__diode_10_pins.SLDPRT
2.47 x 2.02 x 1.45 mm
