Waterfox/razbot/razbot_CAD/raspberry_pi/raspberry_pi__sot-223_large.SLDPRT

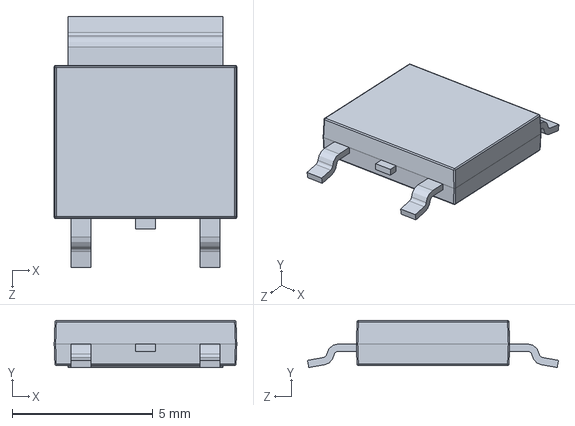
[picture p61: CAD file, 2015-07-30]
razbot_CAD/raspberry_pi/raspberry_pi__sot-223_large.SLDPRT
6.50 x 1.67 x 8.93 mm
