Waterfox/razbot/razbot_CAD/razbot_STL/RR_motor_holder.STL

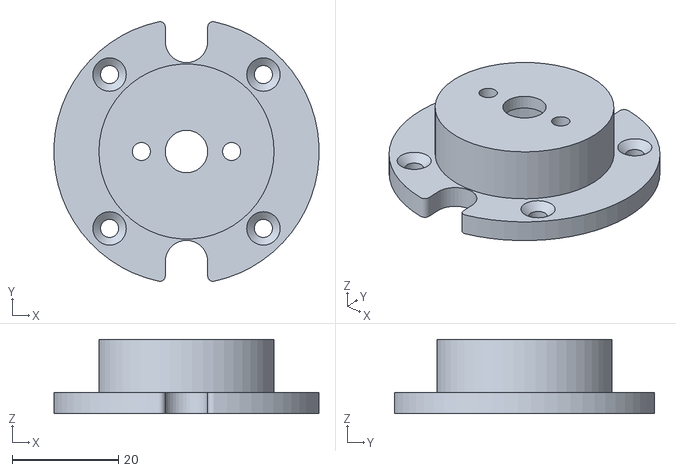
[picture p62: CAD file, 2015-03-07]
razbot_CAD/razbot_STL/RR_motor_holder.STL
49.9 x 48.9 x 14.0
