Waterfox/razbot/razbot_CAD/raspberry_pi/raspberry_pi__HDMI_socket_inside.SLDPRT

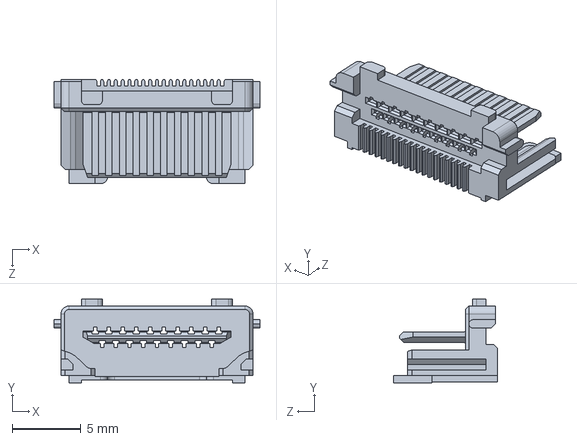
[picture p63: CAD file, 2015-07-30]
razbot_CAD/raspberry_pi/raspberry_pi__HDMI_socket_inside.SLDPRT
15.0 x 6.10 x 7.60 mm
