Waterfox/razbot/razbot_CAD/Side_Right.SLDPRT

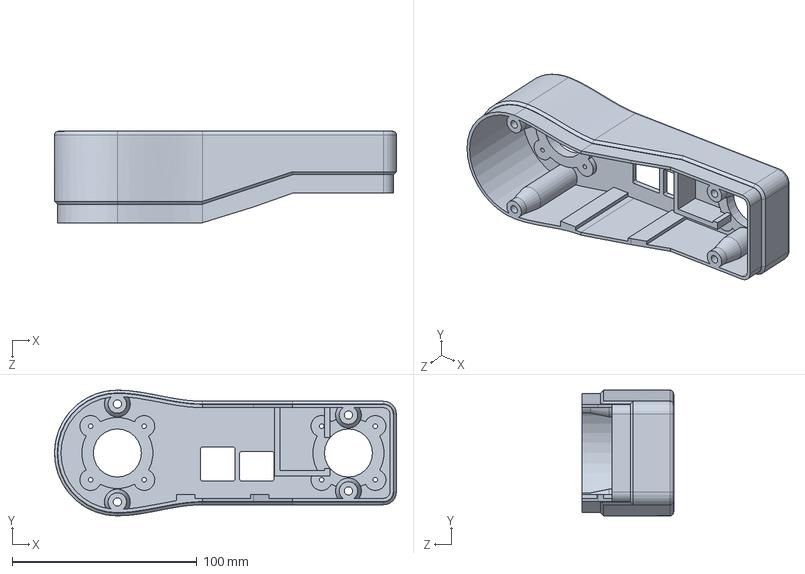
[picture p64: CAD file, 2015-07-30]
razbot_CAD/Side_Right.SLDPRT
185.0 x 68.0 x 49.5 mm
