Waterfox/razbot/razbot_CAD/raspberry_pi/raspberry_pi__RJ45.SLDPRT

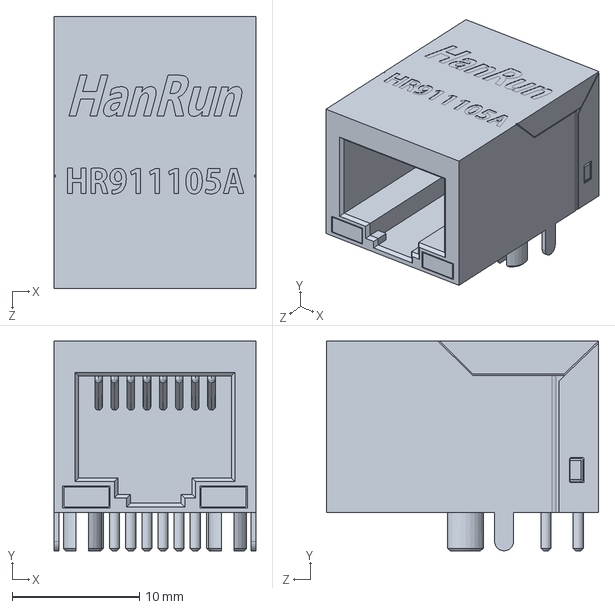
[picture p65: CAD file, 2015-07-30]
razbot_CAD/raspberry_pi/raspberry_pi__RJ45.SLDPRT
15.9 x 16.5 x 21.4 mm
