Waterfox/razbot/razbot_CAD/raspberry_pi/raspberry_pi__SD Card.SLDPRT

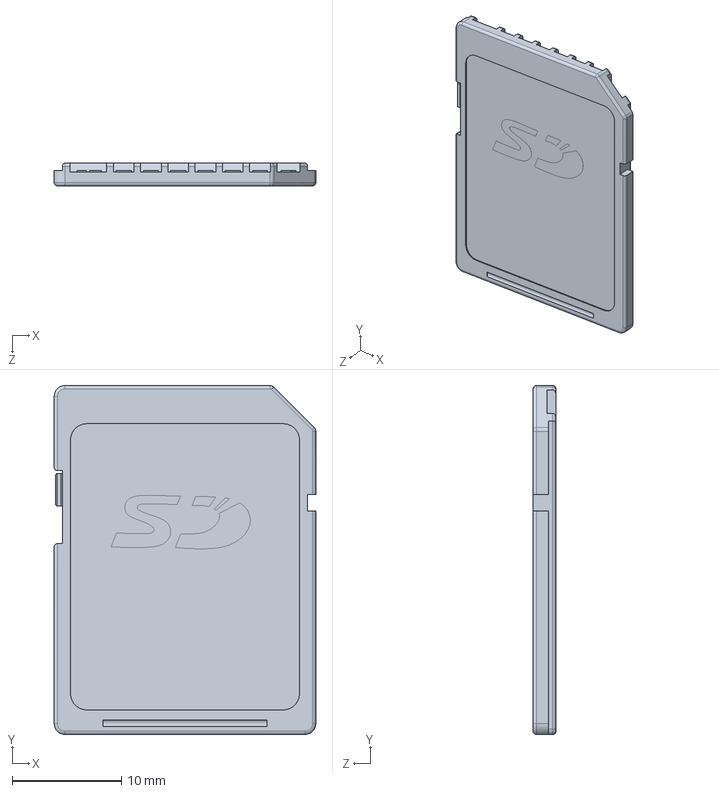
[picture p66: CAD file, 2015-07-30]
razbot_CAD/raspberry_pi/raspberry_pi__SD Card.SLDPRT
24.0 x 32.0 x 2.10 mm
