Waterfox/razbot/razbot_CAD/Side_Left.SLDPRT

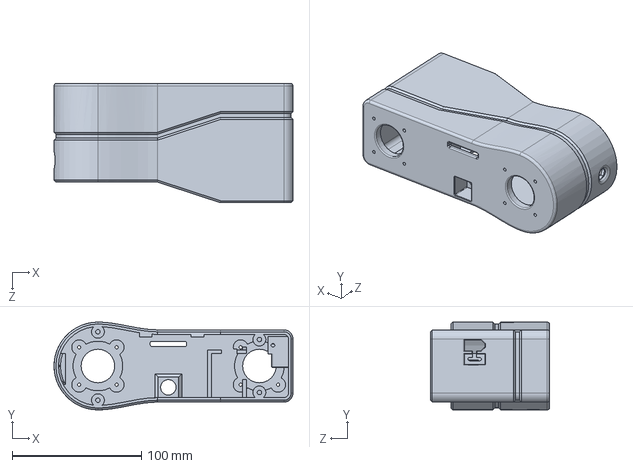
[picture p67: CAD file, 2015-07-30]
razbot_CAD/Side_Left.SLDPRT
185.0 x 68.0 x 92.5 mm
