Waterfox/razbot/razbot_CAD/3S2200mAhLIPO.SLDPRT

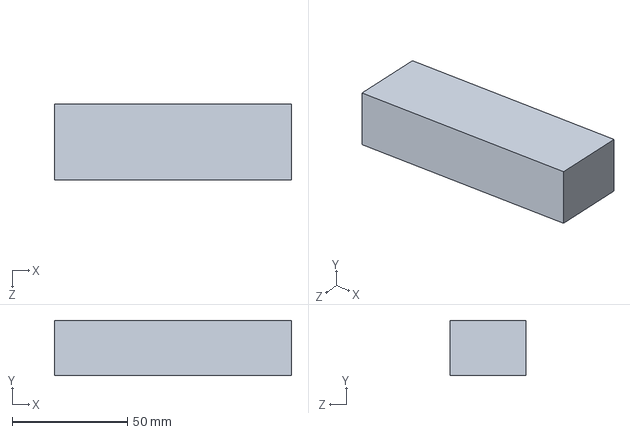
[picture p68: CAD file, 2015-07-30]
razbot_CAD/3S2200mAhLIPO.SLDPRT
103.0 x 24.0 x 33.0 mm
