Waterfox/razbot/razbot_CAD/raspberry_pi/raspberry_pi__bar_180_1x8.SLDPRT

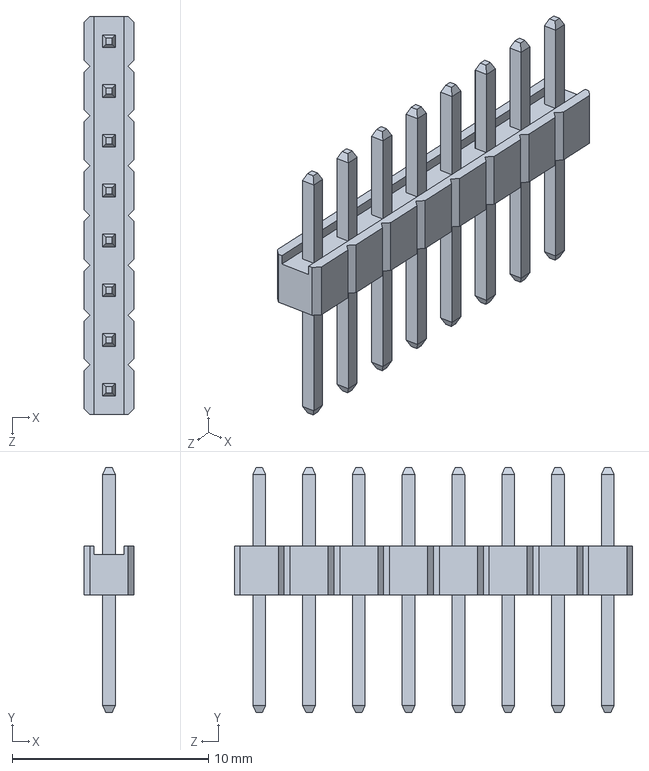
[picture p69: CAD file, 2015-07-30]
razbot_CAD/raspberry_pi/raspberry_pi__bar_180_1x8.SLDPRT
2.54 x 12.5 x 20.3 mm
