Waterfox/razbot/razbot_CAD/raspberry_pi/raspberry_pi__audio_out.SLDPRT

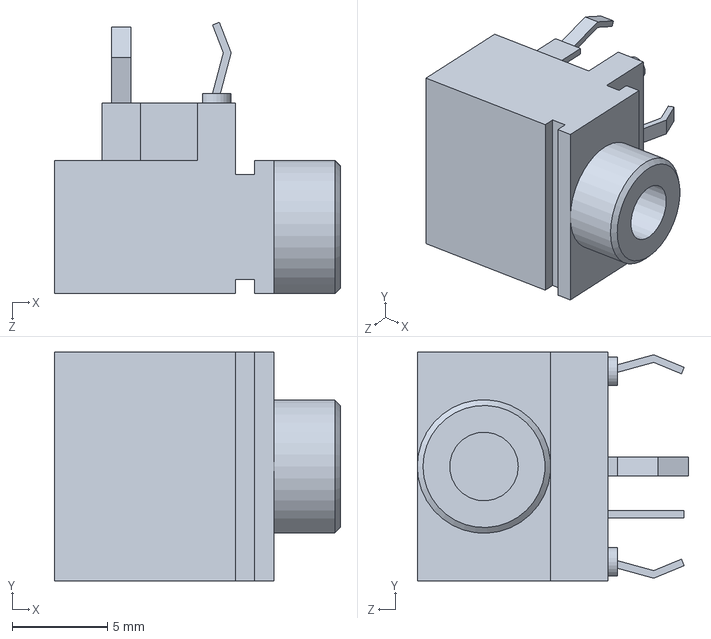
[picture p70: CAD file, 2015-07-30]
razbot_CAD/raspberry_pi/raspberry_pi__audio_out.SLDPRT
15.0 x 12.0 x 14.2 mm
