Waterfox/razbot/razbot_CAD/raspberry_pi/raspberry_pi__15_pin_FFC_Connector_body.SLDPRT

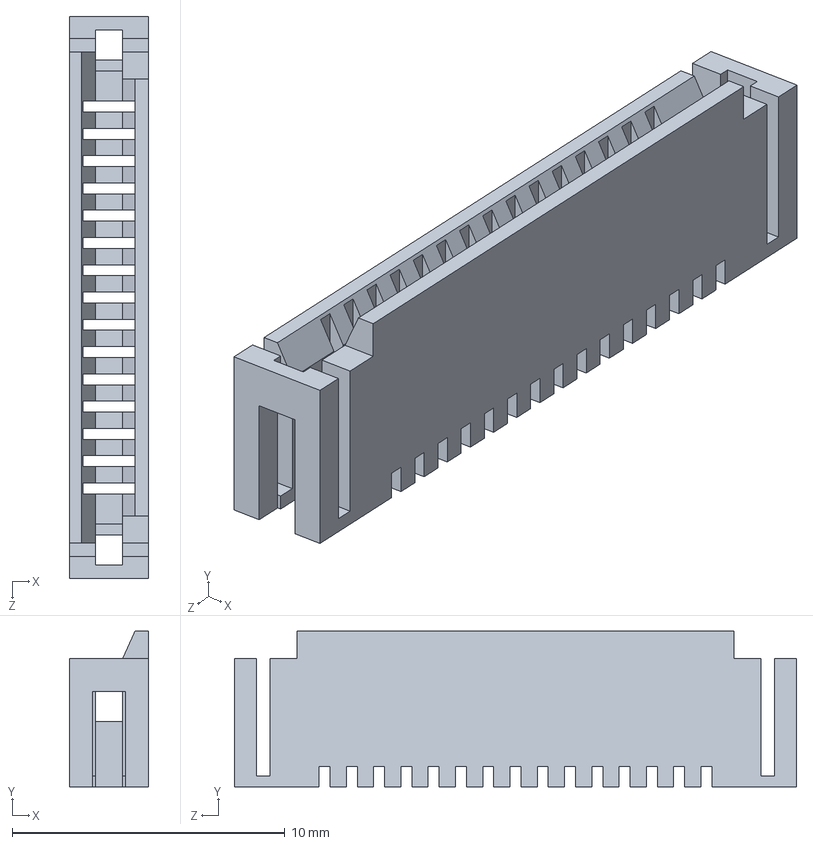
[picture p71: CAD file, 2015-07-30]
razbot_CAD/raspberry_pi/raspberry_pi__15_pin_FFC_Connector_body.SLDPRT
2.90 x 5.70 x 20.6 mm
