Waterfox/razbot/razbot_CAD/raspberry_pi/raspberry_pi__HDMI_socket_large_pin.SLDPRT

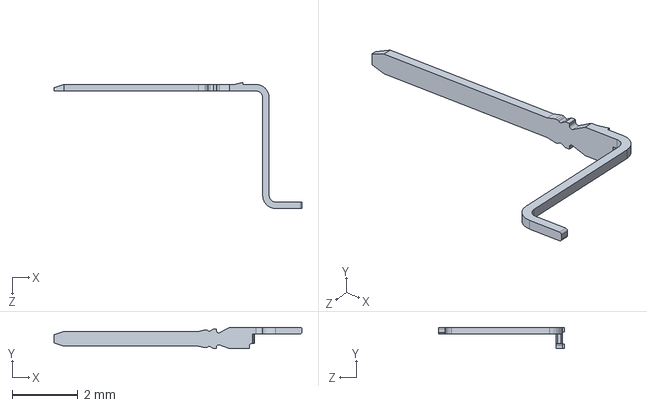
[picture p72: CAD file, 2015-07-30]
razbot_CAD/raspberry_pi/raspberry_pi__HDMI_socket_large_pin.SLDPRT
7.55 x 0.65 x 3.84 mm
