Waterfox/razbot/razbot_CAD/raspberry_pi/raspberry_pi__micro_USB_cover.SLDPRT

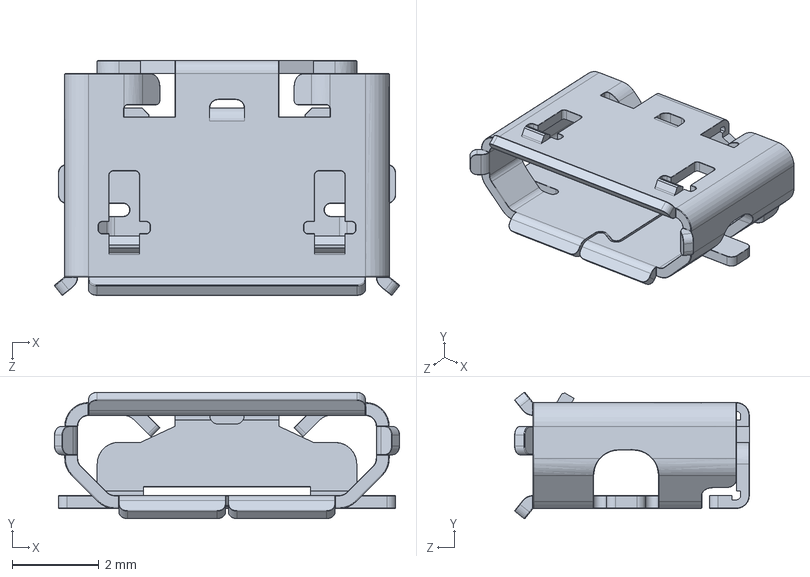
[picture p73: CAD file, 2015-07-30]
razbot_CAD/raspberry_pi/raspberry_pi__micro_USB_cover.SLDPRT
7.97 x 2.92 x 5.43 mm
