Waterfox/razbot/razbot_CAD/raspberry_pi/raspberry_pi__1210.SLDPRT

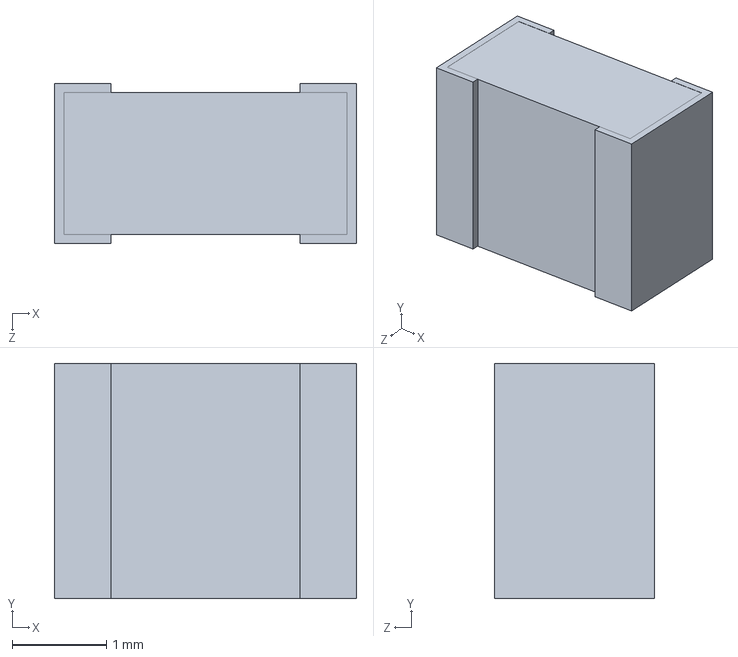
[picture p74: CAD file, 2015-07-30]
razbot_CAD/raspberry_pi/raspberry_pi__1210.SLDPRT
3.20 x 2.49 x 1.70 mm
