Waterfox/razbot/razbot_CAD/raspberry_pi/raspberry_pi__SD_reader_pin1.SLDPRT

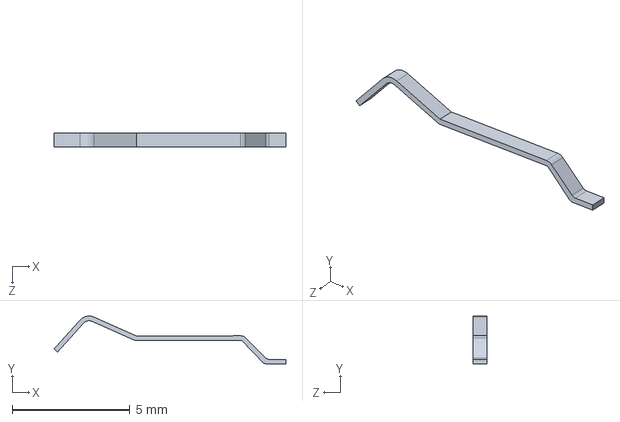
[picture p75: CAD file, 2015-07-30]
razbot_CAD/raspberry_pi/raspberry_pi__SD_reader_pin1.SLDPRT
9.85 x 2.04 x 0.6 mm
