Waterfox/razbot/razbot_CAD/raspberry_pi/raspberry_pi__SD_reader_pin3.SLDPRT

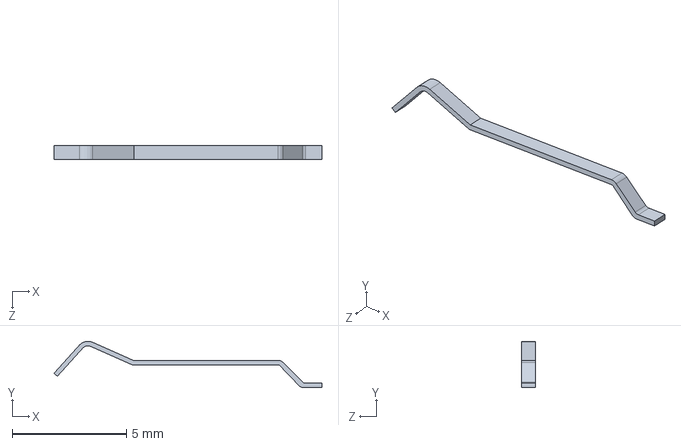
[picture p76: CAD file, 2015-07-30]
razbot_CAD/raspberry_pi/raspberry_pi__SD_reader_pin3.SLDPRT
11.7 x 2.03 x 0.6 mm
