Waterfox/razbot/razbot_CAD/raspberry_pi/raspberry_pi__Sot23.SLDPRT

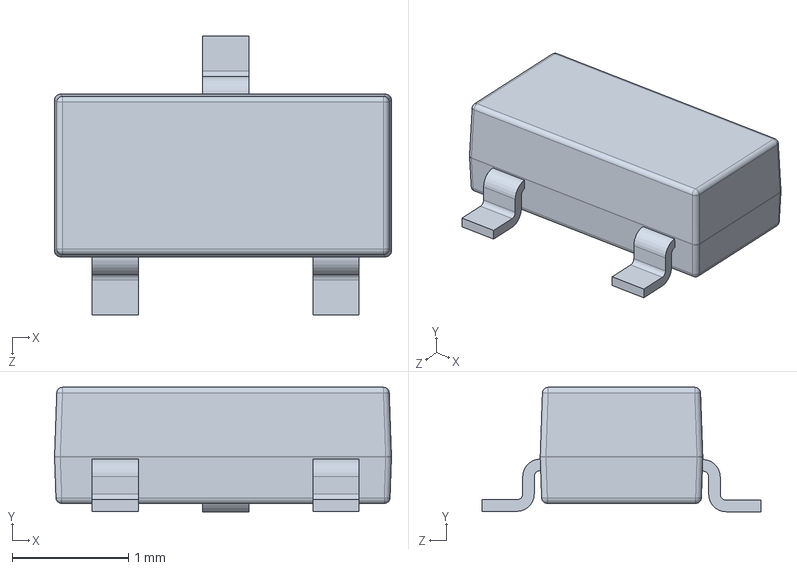
[picture p77: CAD file, 2015-07-30]
razbot_CAD/raspberry_pi/raspberry_pi__Sot23.SLDPRT
2.90 x 1.07 x 2.40 mm
