Waterfox/razbot/razbot_CAD/raspberry_pi/raspberry_pi__HDMI_socket_cover.SLDPRT

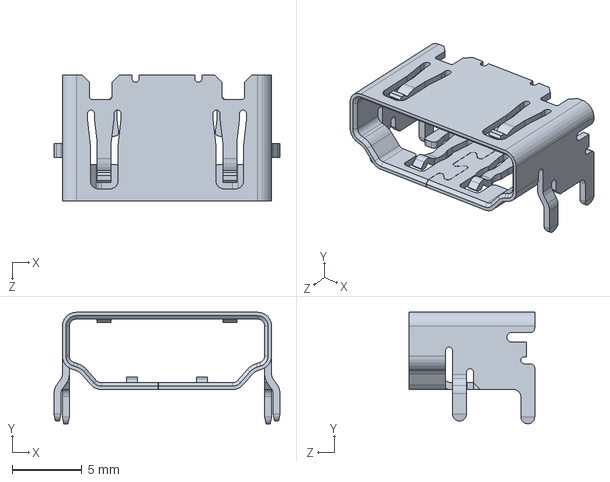
[picture p78: CAD file, 2015-07-30]
razbot_CAD/raspberry_pi/raspberry_pi__HDMI_socket_cover.SLDPRT
16.2 x 8.00 x 9.00 mm
