Waterfox/razbot/razbot_CAD/raspberry_pi/raspberry_pi__Sot23-3_5pins.SLDPRT

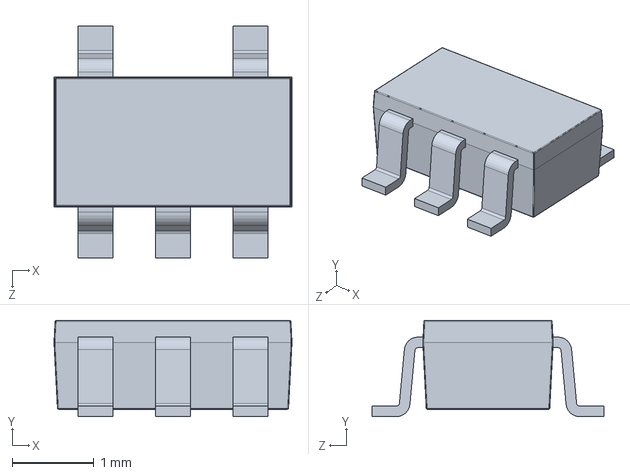
[picture p79: CAD file, 2015-07-30]
razbot_CAD/raspberry_pi/raspberry_pi__Sot23-3_5pins.SLDPRT
2.92 x 1.18 x 2.85 mm
