Waterfox/razbot/razbot_CAD/raspberry_pi/raspberry_pi__Xtal_Smd_25.SLDPRT

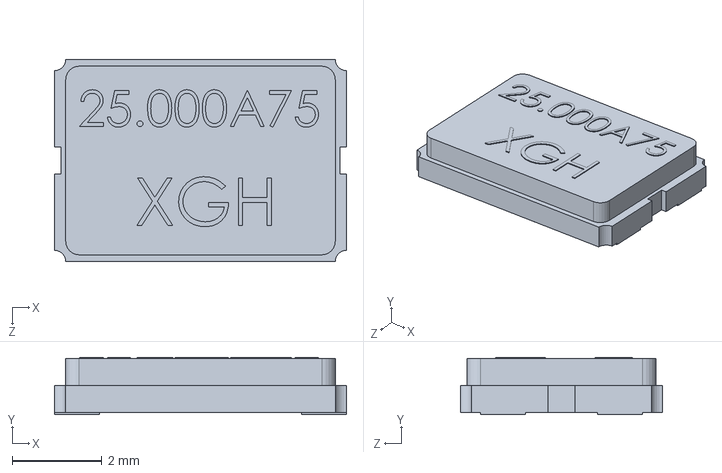
[picture p80: CAD file, 2015-07-30]
razbot_CAD/raspberry_pi/raspberry_pi__Xtal_Smd_25.SLDPRT
6.50 x 1.27 x 4.50 mm
