Waterfox/razbot/razbot_CAD/raspberry_pi/raspberry_pi__168_FBGA_12x12.SLDPRT

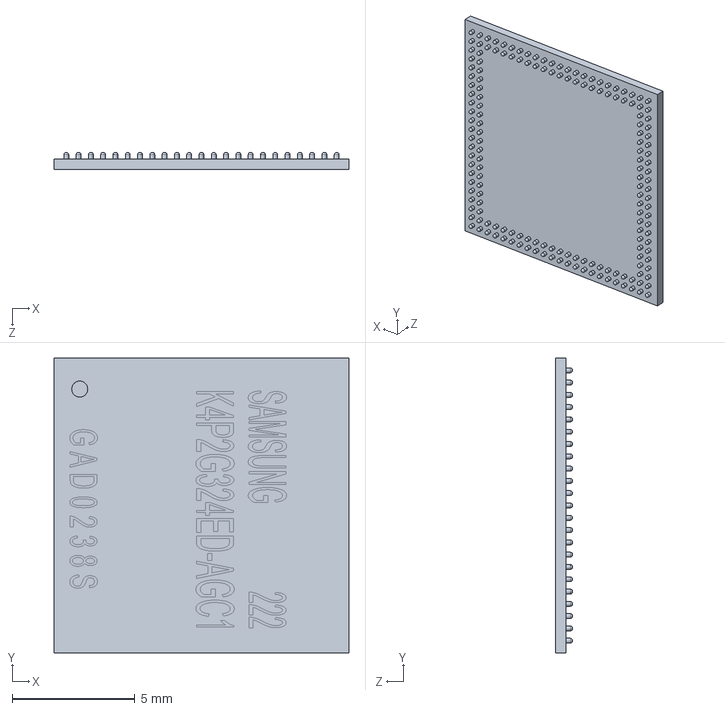
[picture p81: CAD file, 2015-07-30]
razbot_CAD/raspberry_pi/raspberry_pi__168_FBGA_12x12.SLDPRT
12.0 x 12.0 x 0.71 mm
