Waterfox/razbot/razbot_CAD/raspberry_pi/raspberry_pi__15_pin_FFC_Connector_pins.SLDPRT

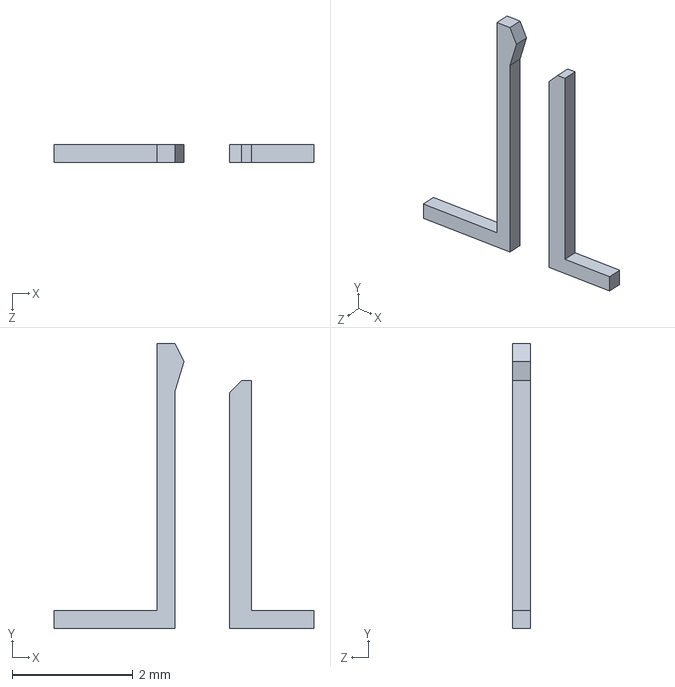
[picture p82: CAD file, 2015-07-30]
razbot_CAD/raspberry_pi/raspberry_pi__15_pin_FFC_Connector_pins.SLDPRT
4.30 x 4.71 x 0.3 mm
