Waterfox/razbot/razbot_CAD/raspberry_pi/raspberry_pi__SD_reader_pin2.SLDPRT

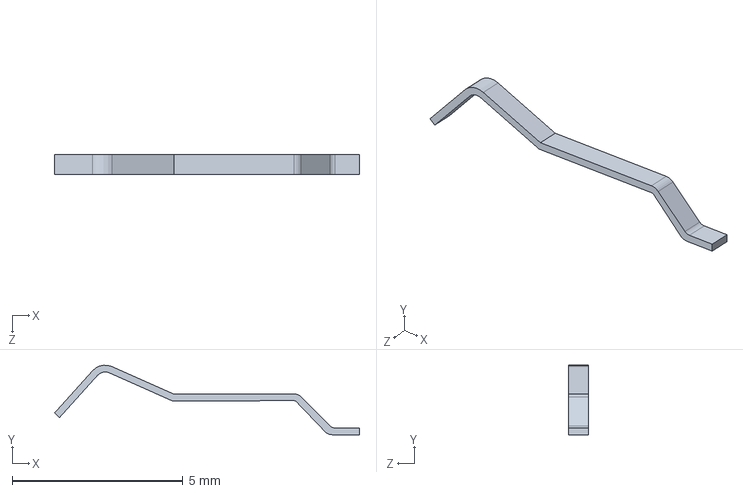
[picture p83: CAD file, 2015-07-30]
razbot_CAD/raspberry_pi/raspberry_pi__SD_reader_pin2.SLDPRT
8.94 x 2.04 x 0.6 mm
