Waterfox/razbot/razbot_CAD/raspberry_pi/raspberry_pi__LED_SMD_0603.SLDPRT

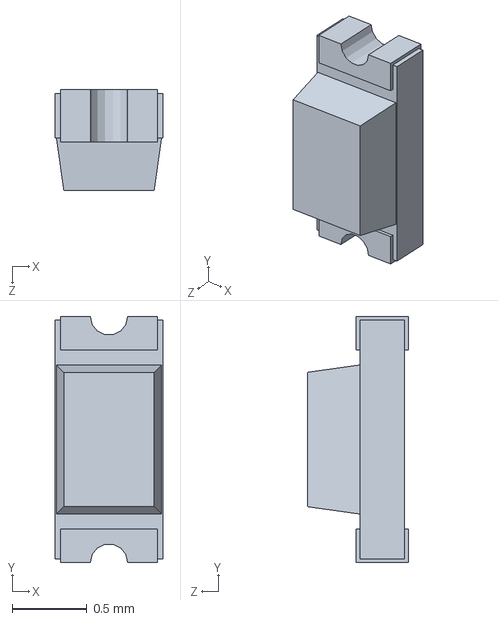
[picture p84: CAD file, 2015-07-30]
razbot_CAD/raspberry_pi/raspberry_pi__LED_SMD_0603.SLDPRT
0.725 x 1.65 x 0.675 mm
