Waterfox/razbot/razbot_CAD/raspberry_pi/raspberry_pi__SD_reader_body.SLDPRT

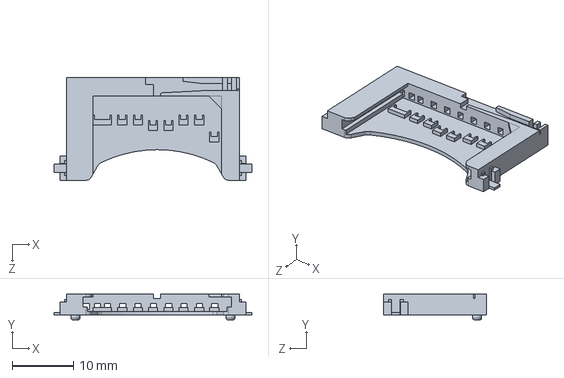
[picture p85: CAD file, 2015-07-30]
razbot_CAD/raspberry_pi/raspberry_pi__SD_reader_body.SLDPRT
32.3 x 4.20 x 16.8 mm
