Waterfox/razbot/razbot_CAD/raspberry_pi/raspberry_pi__QFN64-2.SLDPRT

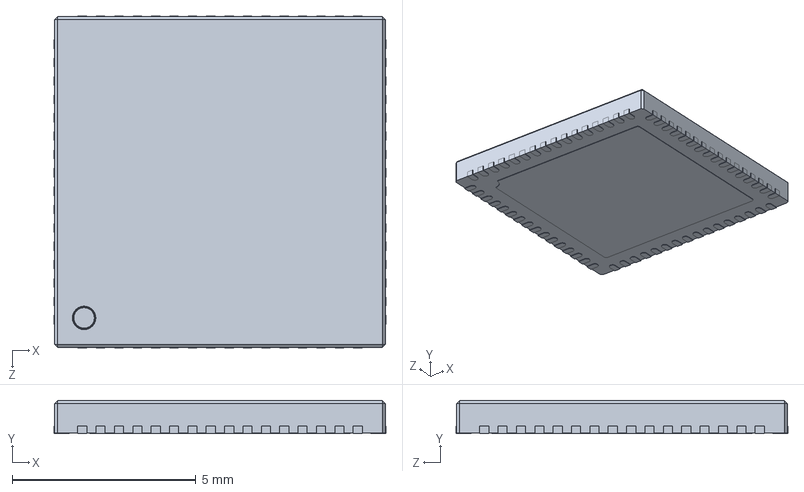
[picture p86: CAD file, 2015-07-30]
razbot_CAD/raspberry_pi/raspberry_pi__QFN64-2.SLDPRT
9.04 x 0.9 x 9.04 mm
