Waterfox/razbot/razbot_CAD/raspberry_pi/raspberry_pi__SD_reader_pin4.SLDPRT

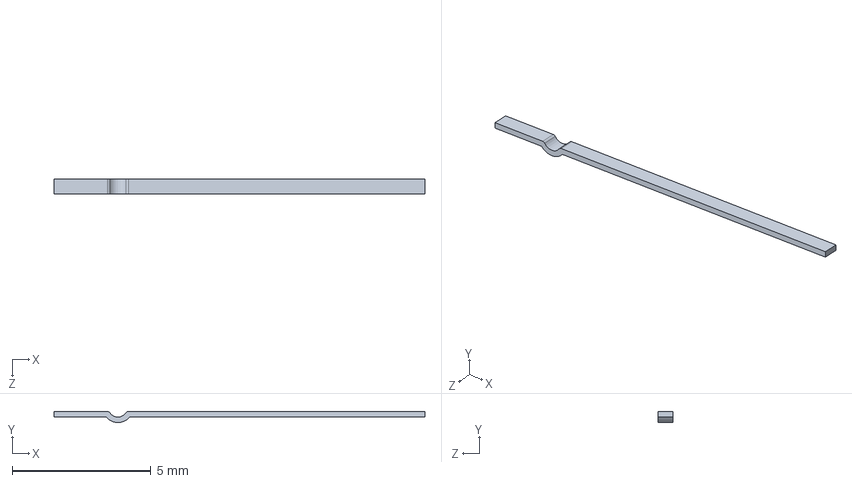
[picture p87: CAD file, 2015-07-30]
razbot_CAD/raspberry_pi/raspberry_pi__SD_reader_pin4.SLDPRT
13.3 x 0.396 x 0.55 mm
