Waterfox/razbot/razbot_CAD/raspberry_pi/raspberry_pi__1206.SLDPRT

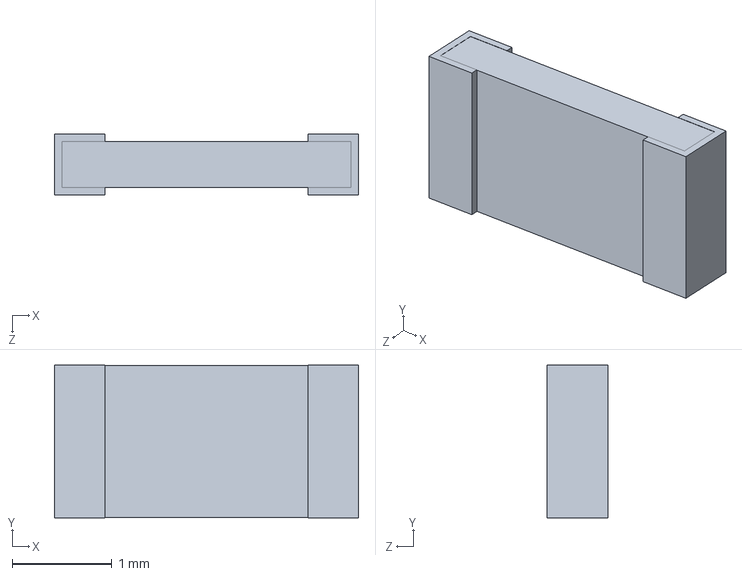
[picture p88: CAD file, 2015-07-30]
razbot_CAD/raspberry_pi/raspberry_pi__1206.SLDPRT
3.05 x 1.53 x 0.61 mm
