Waterfox/razbot/razbot_CAD/raspberry_pi/raspberry_pi__SD_reader_pin5.SLDPRT

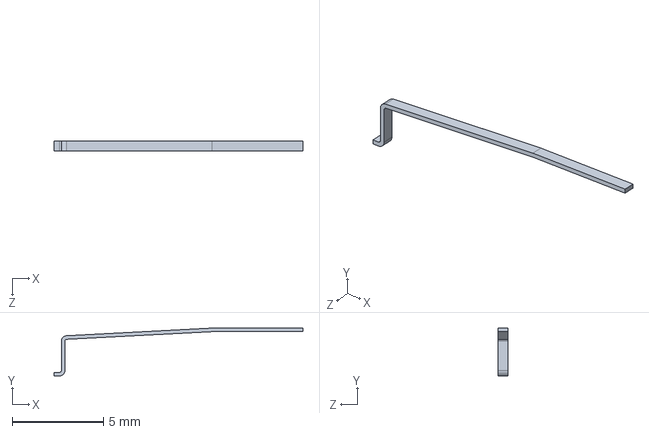
[picture p89: CAD file, 2015-07-30]
razbot_CAD/raspberry_pi/raspberry_pi__SD_reader_pin5.SLDPRT
13.7 x 2.63 x 0.55 mm
