Waterfox/razbot/razbot_CAD/raspberry_pi/raspberry_pi__CI_Board_mounting_holes.SLDPRT

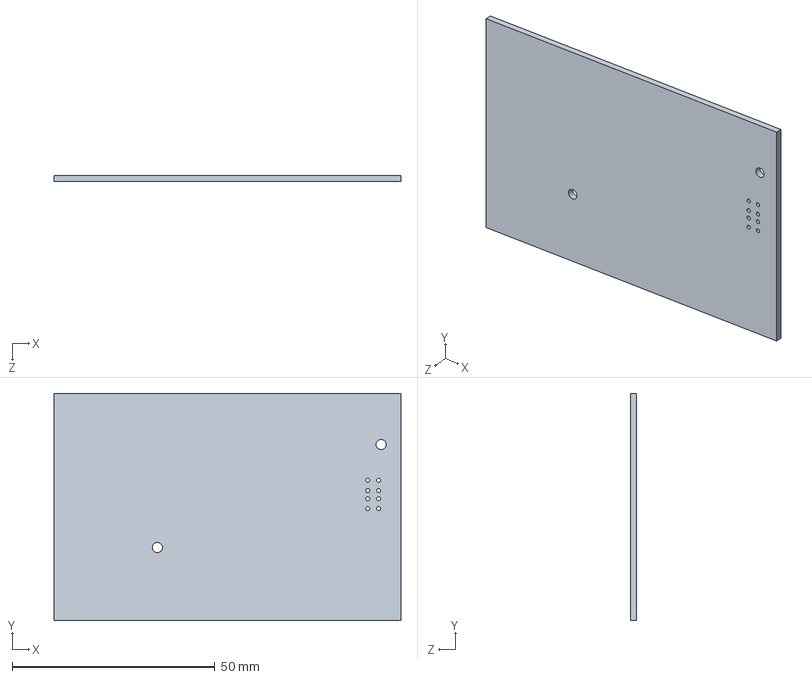
[picture p90: CAD file, 2015-07-30]
razbot_CAD/raspberry_pi/raspberry_pi__CI_Board_mounting_holes.SLDPRT
85.6 x 56.0 x 1.60 mm
