Waterfox/razbot/razbot_CAD/raspberry_pi/raspberry_pi__USB_x2_part1.SLDPRT

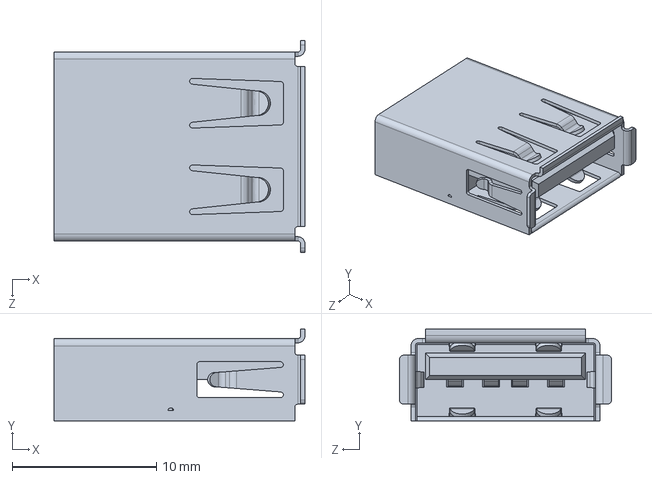
[picture p91: CAD file, 2015-07-30]
razbot_CAD/raspberry_pi/raspberry_pi__USB_x2_part1.SLDPRT
17.4 x 6.35 x 14.7 mm
