Waterfox/razbot/razbot_CAD/raspberry_pi/raspberry_pi__1812.SLDPRT

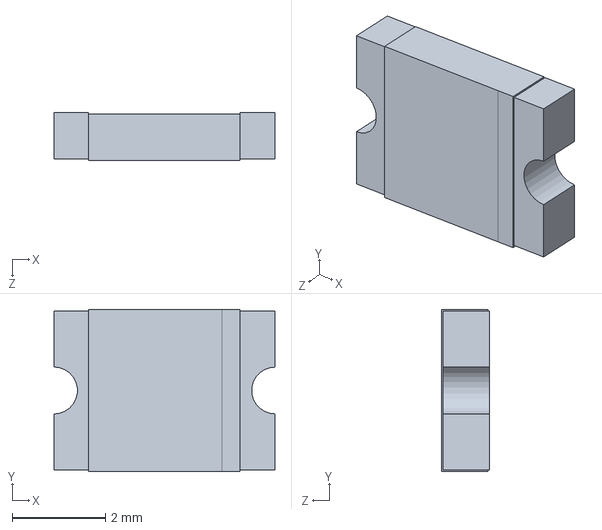
[picture p92: CAD file, 2015-07-30]
razbot_CAD/raspberry_pi/raspberry_pi__1812.SLDPRT
4.74 x 3.48 x 1.03 mm
