Waterfox/razbot/razbot_CAD/raspberry_pi/raspberry_pi__0402.SLDPRT

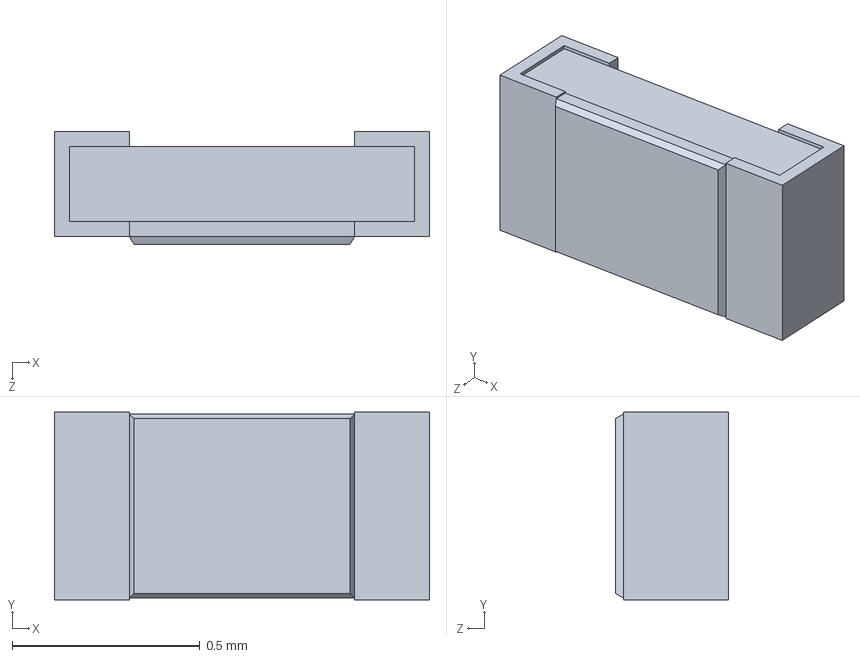
[picture p93: CAD file, 2015-07-30]
razbot_CAD/raspberry_pi/raspberry_pi__0402.SLDPRT
1.00 x 0.5 x 0.3 mm
