Waterfox/razbot/razbot_CAD/raspberry_pi/raspberry_pi__Smd6.SLDPRT

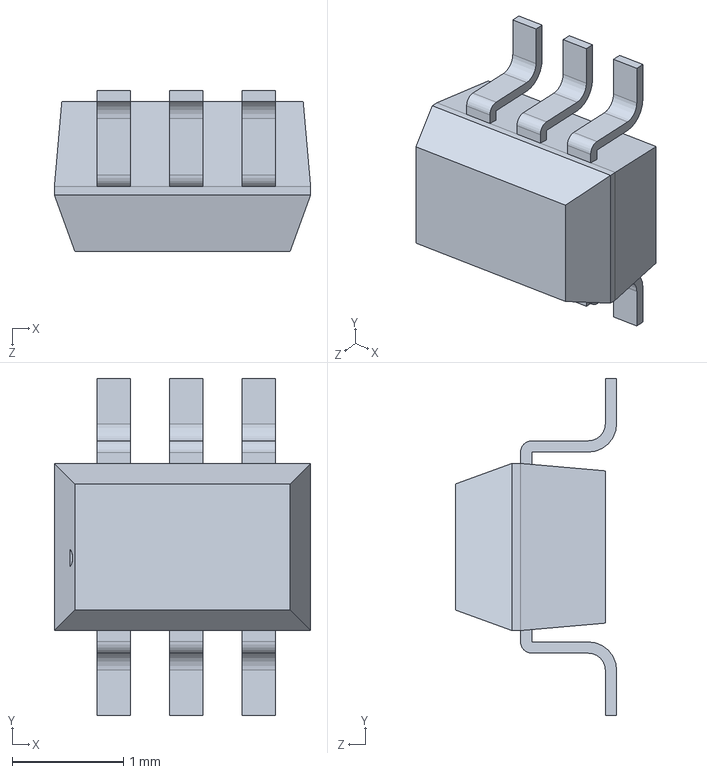
[picture p94: CAD file, 2015-07-30]
razbot_CAD/raspberry_pi/raspberry_pi__Smd6.SLDPRT
2.30 x 3.02 x 1.45 mm
