Waterfox/razbot/razbot_CAD/raspberry_pi/raspberry_pi__Sot223.SLDPRT

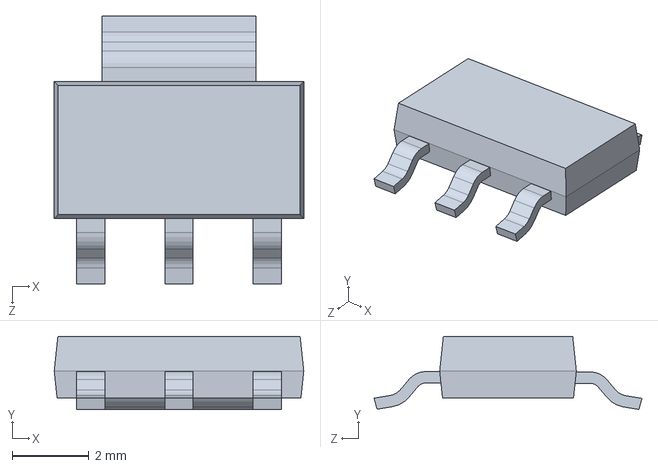
[picture p95: CAD file, 2015-07-30]
razbot_CAD/raspberry_pi/raspberry_pi__Sot223.SLDPRT
6.50 x 1.90 x 6.98 mm
