Waterfox/razbot/razbot_CAD/raspberry_pi/raspberry_pi__bar_180_2x13.SLDPRT

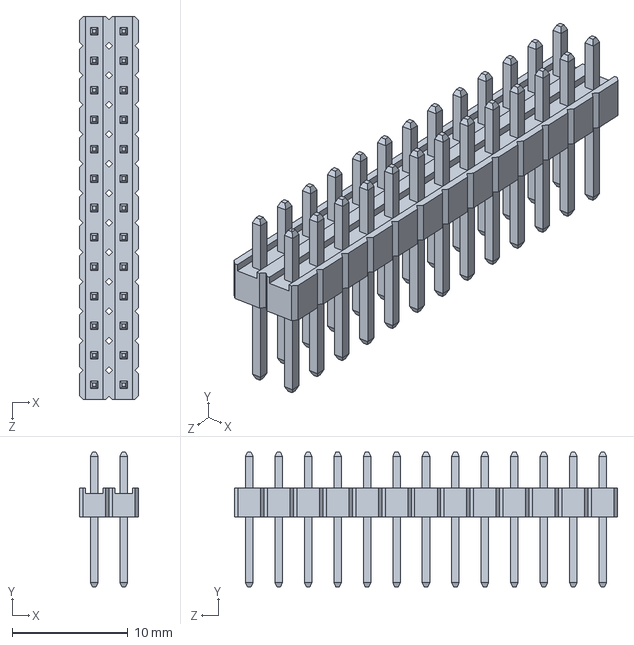
[picture p96: CAD file, 2015-07-30]
razbot_CAD/raspberry_pi/raspberry_pi__bar_180_2x13.SLDPRT
5.08 x 11.6 x 33.0 mm
