Waterfox/razbot/razbot_CAD/raspberry_pi/raspberry_pi__SOD-123_DiodesInc.SLDPRT

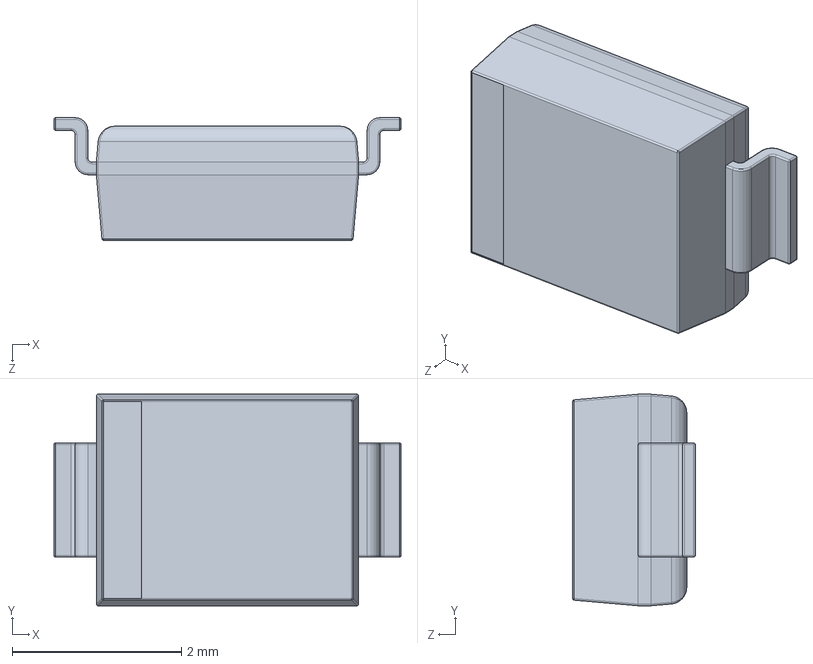
[picture p97: CAD file, 2015-07-30]
razbot_CAD/raspberry_pi/raspberry_pi__SOD-123_DiodesInc.SLDPRT
4.10 x 2.50 x 1.45 mm
