Waterfox/razbot/razbot_CAD/raspberry_pi/raspberry_pi__1206xl.SLDPRT

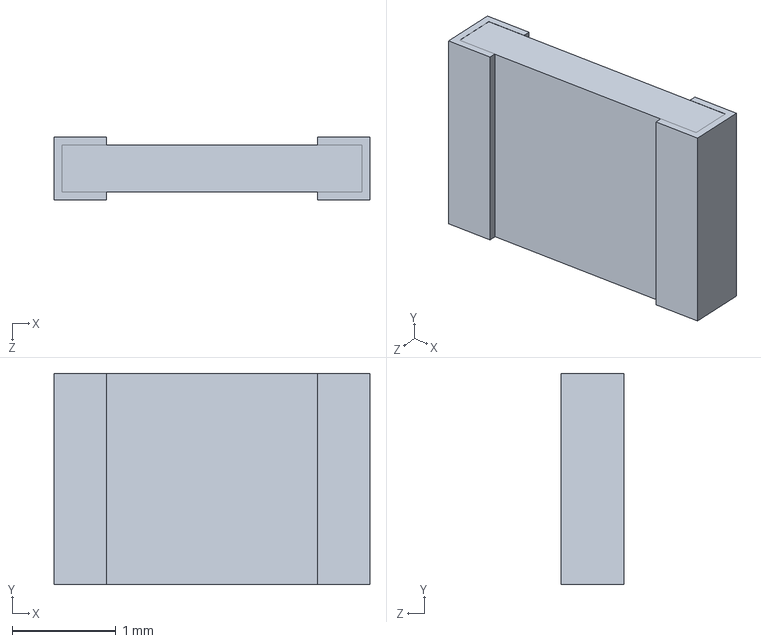
[picture p98: CAD file, 2015-07-30]
razbot_CAD/raspberry_pi/raspberry_pi__1206xl.SLDPRT
3.05 x 2.04 x 0.61 mm
