Waterfox/razbot/razbot_CAD/raspberry_pi/raspberry_pi__USB_x2_part2.SLDPRT

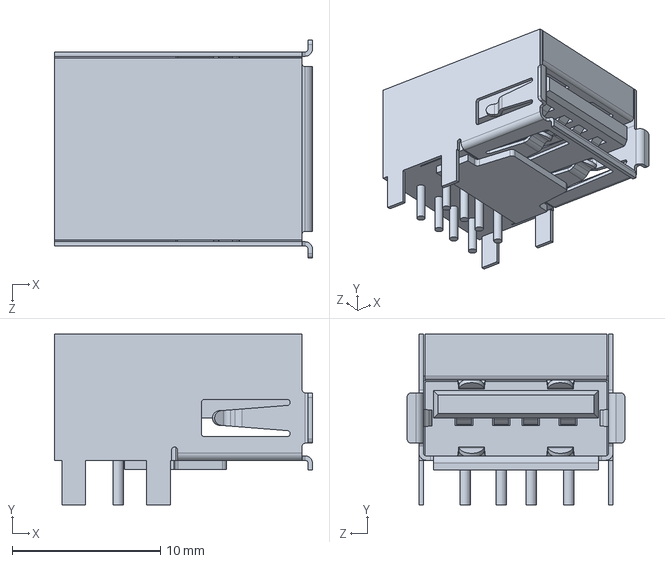
[picture p99: CAD file, 2015-07-30]
razbot_CAD/raspberry_pi/raspberry_pi__USB_x2_part2.SLDPRT
17.4 x 11.5 x 14.7 mm
