Waterfox/razbot/(list of files, cad)

Other CAD files:
razbot_Software_RPi/Razbot_URDF/razbotURDF/meshes/wheel_4_link.STL
razbot_CAD/PiTrayB.SLDPRT
razbot_CAD/razbot_STL/wheel.STL
razbot_Software_RPi/Razbot_URDF/razbotURDF/meshes/wheel_2_link.STL
razbot_Software_RPi/Razbot_URDF/razbotURDF/meshes/wheel_3_link.STL
razbot_CAD/razbot_STL/Top_Plate.stl
razbot_CAD/motor_holder_r0.4.SLDPRT
razbot_CAD/wheel_3.SLDPRT
razbot_CAD/motor_holder_r0.5.SLDPRT
razbot_CAD/motor_holder_fr0.6.SLDPRT
razbot_CAD/raspberry_pi/raspberry_pi__Xtal_Smd_19200.SLDPRT
razbot_CAD/PiTrayB+.SLDPRT
razbot_CAD/raspberry_pi_camera/OVA5647.SLDPRT
razbot_CAD/razbot_STL/PiTrayB.STL
