Waterfox/razbot/Documentation/Assembly Pictures/IMG_3675.JPG

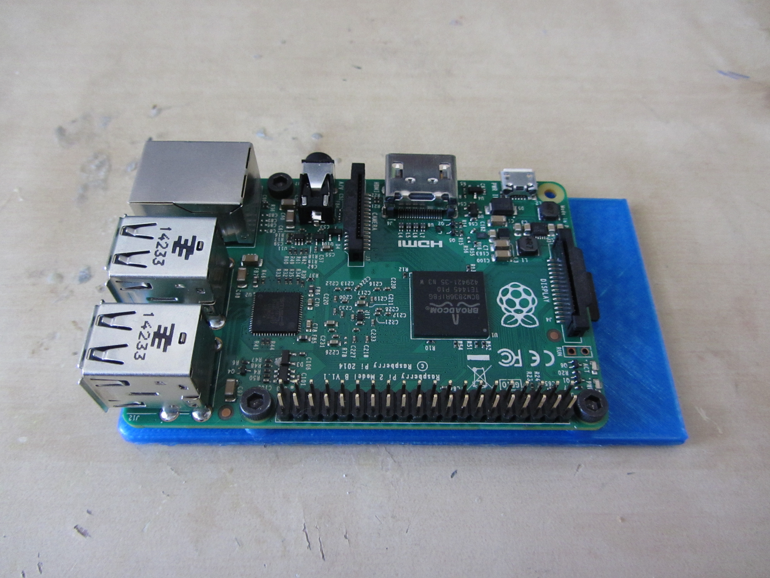
Documentation/Assembly Pictures/IMG_3675.JPG
