Waterfox/razbot/Documentation/Assembly Pictures/IMG_3677.JPG

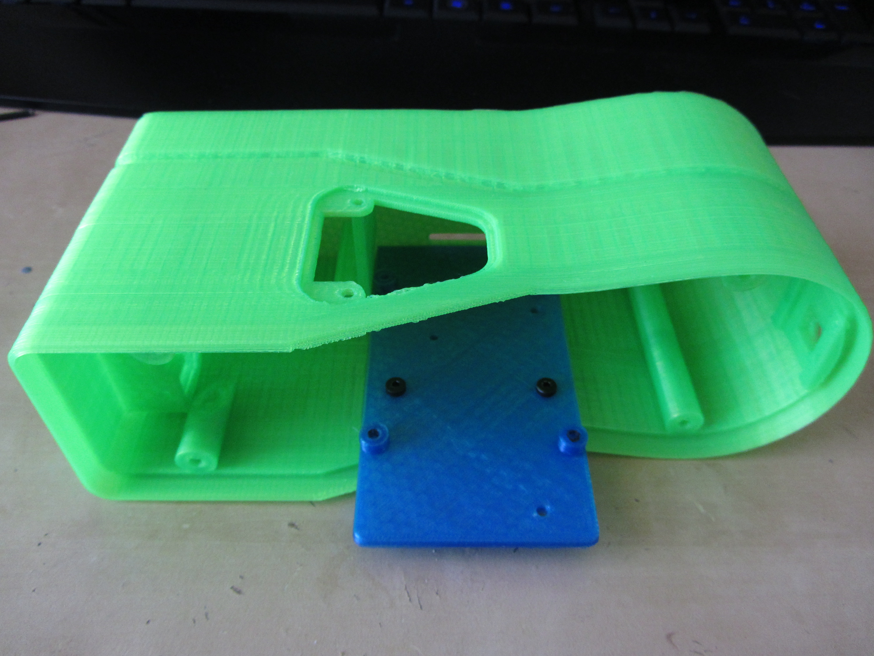
Documentation/Assembly Pictures/IMG_3677.JPG
