Waterfox/razbot/Documentation/Assembly Pictures/IMG_3678.JPG

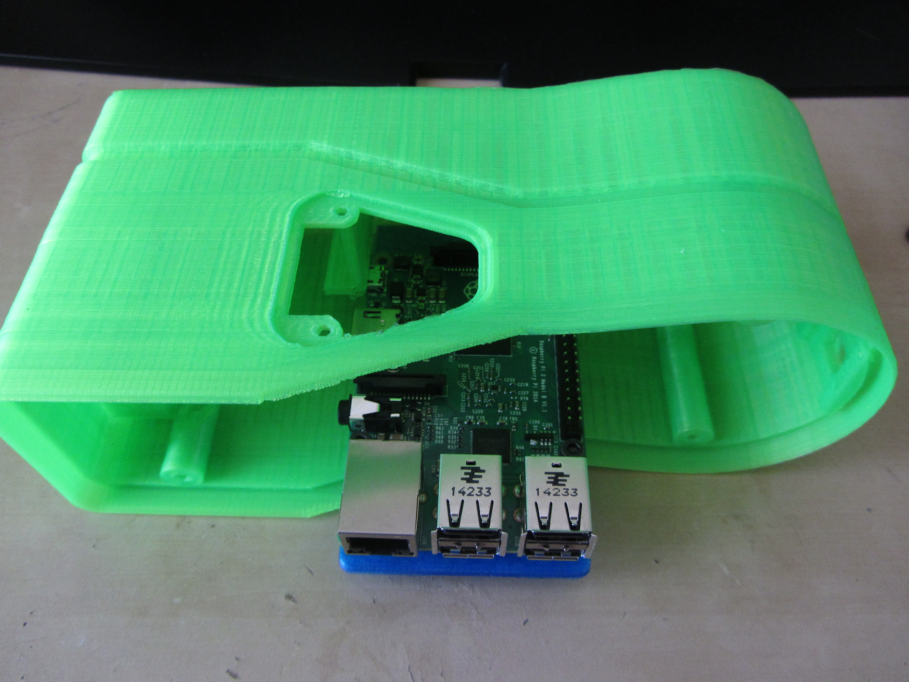
Documentation/Assembly Pictures/IMG_3678.JPG
