Waterfox/razbot/Documentation/Assembly Pictures/IMG_3680.JPG

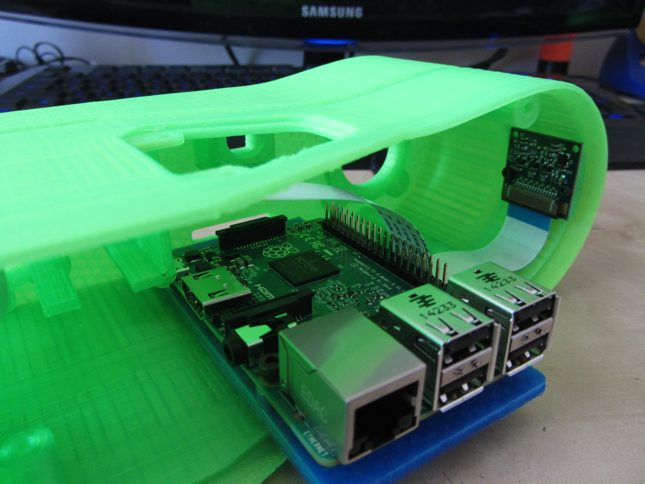
Documentation/Assembly Pictures/IMG_3680.JPG
