Waterfox/razbot/Documentation/Assembly Pictures/IMG_3683.JPG

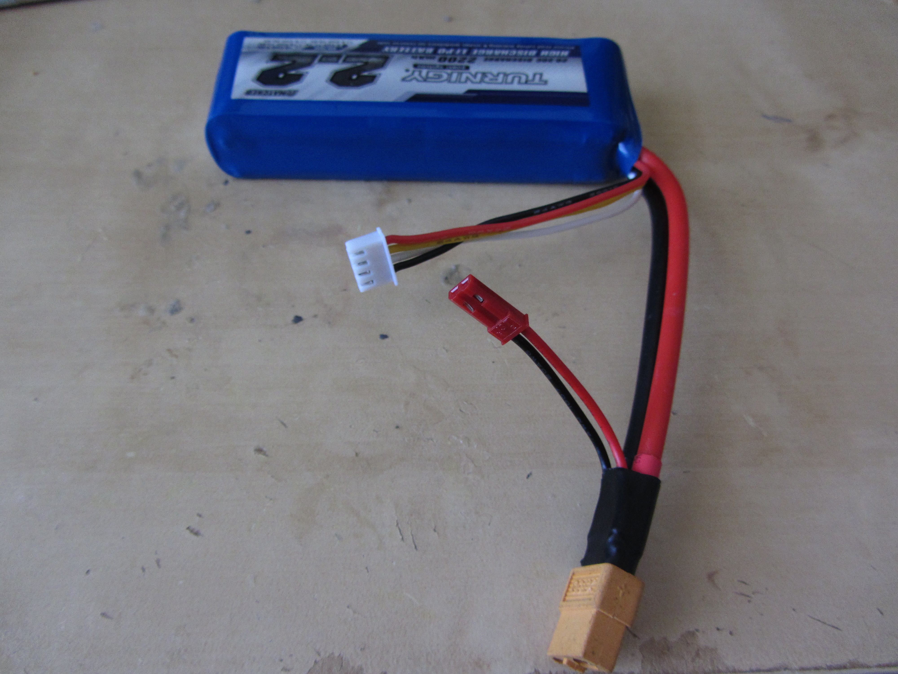
Documentation/Assembly Pictures/IMG_3683.JPG
