Waterfox/razbot/Documentation/Assembly Pictures/IMG_3684.JPG

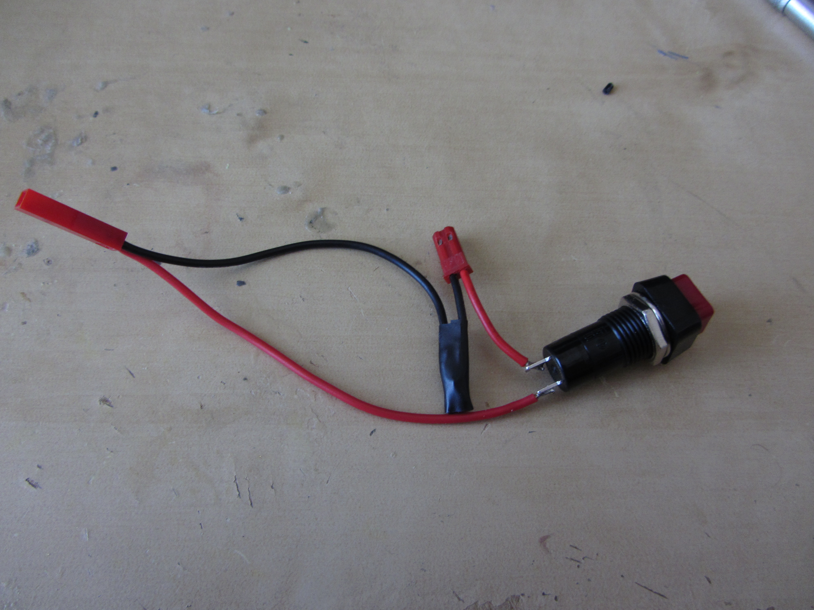
Documentation/Assembly Pictures/IMG_3684.JPG
