Waterfox/razbot/Documentation/Assembly Pictures/IMG_3686.JPG

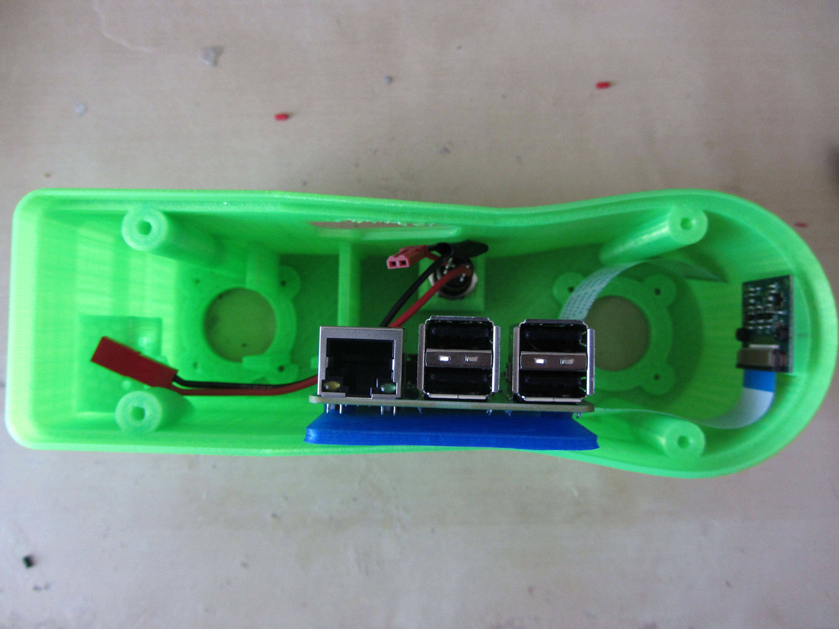
Documentation/Assembly Pictures/IMG_3686.JPG
