Waterfox/razbot/Documentation/Assembly Pictures/IMG_3687.JPG

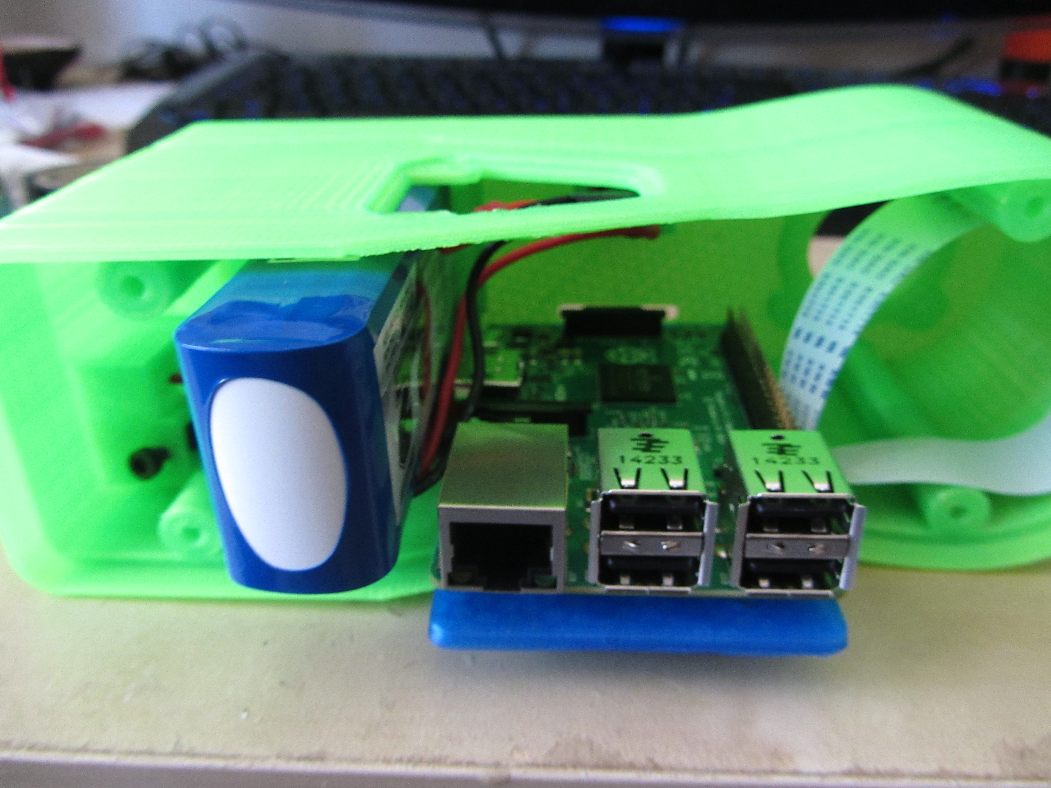
Documentation/Assembly Pictures/IMG_3687.JPG
