Waterfox/razbot/Documentation/Assembly Pictures/IMG_3688.JPG

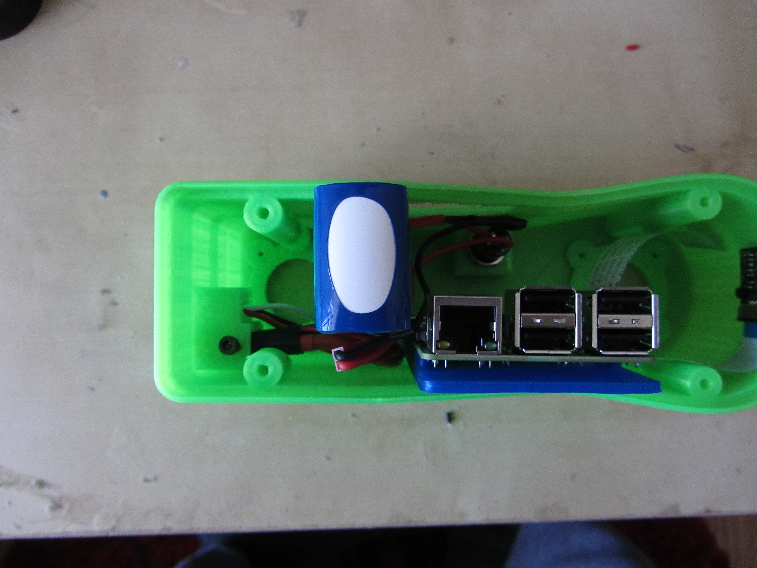
Documentation/Assembly Pictures/IMG_3688.JPG
