Waterfox/razbot/Documentation/Assembly Pictures/IMG_3690.JPG

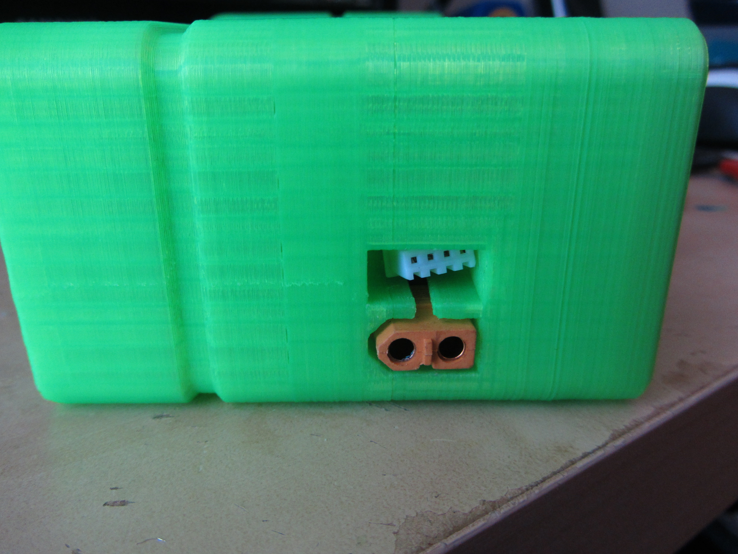
Documentation/Assembly Pictures/IMG_3690.JPG
