Waterfox/razbot/Documentation/Build a Raspberry Robot/diagram/pcbv2.png

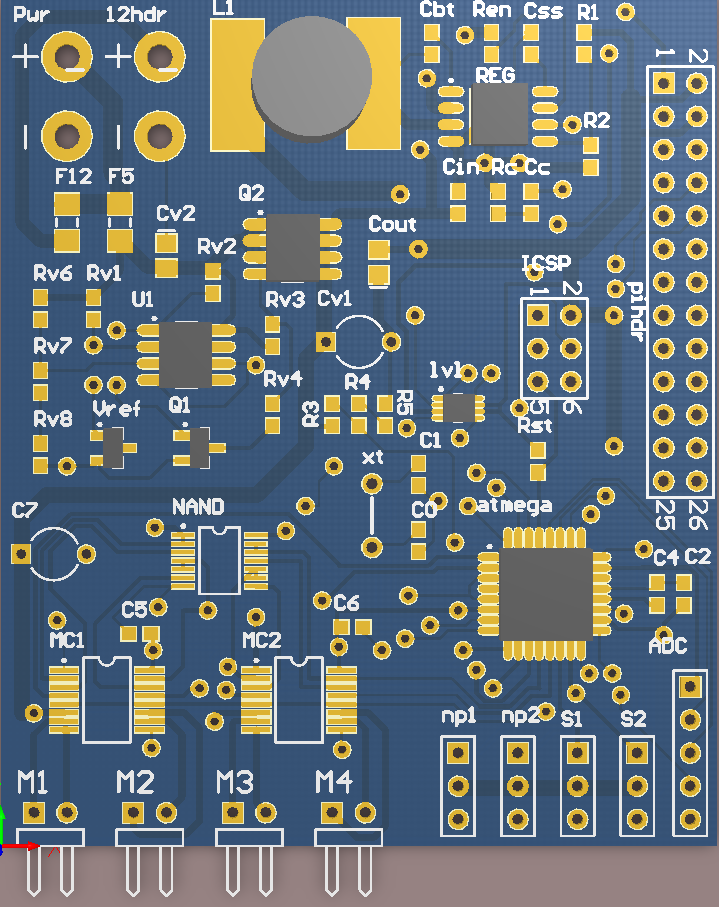
Documentation/Build a Raspberry Robot/diagram/pcbv2.png
