Waterfox/razbot/Documentation/Build a Raspberry Robot/diagram/razbotsize.jpg

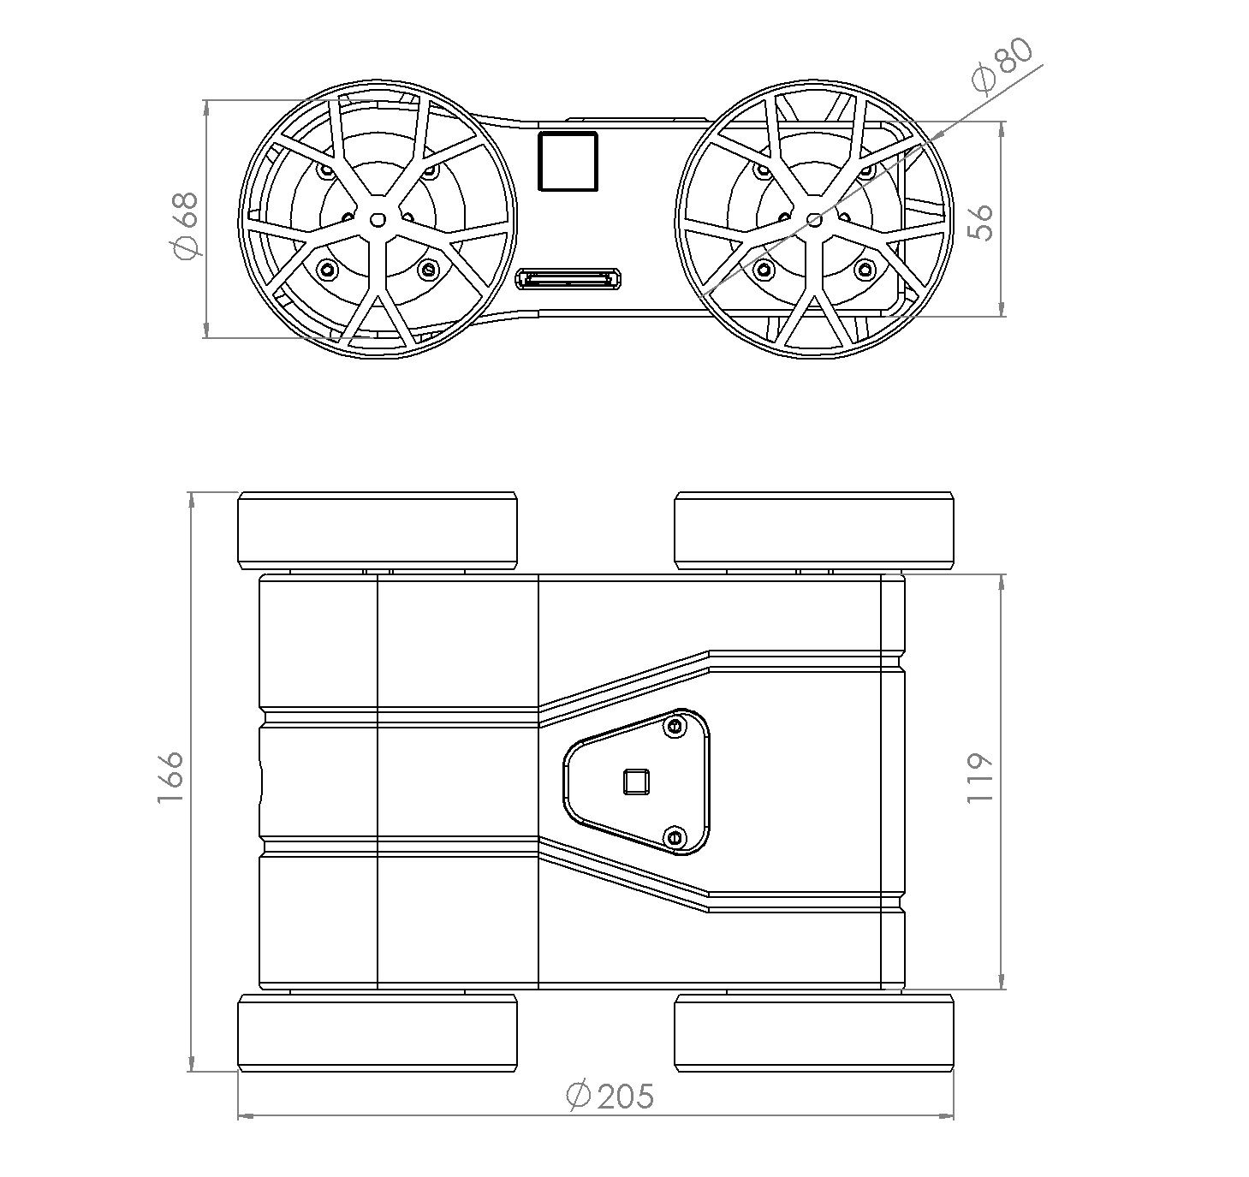
Documentation/Build a Raspberry Robot/diagram/razbotsize.jpg
