Waterfox/razbot/Documentation/Build a Raspberry Robot/render/pbb.jpg

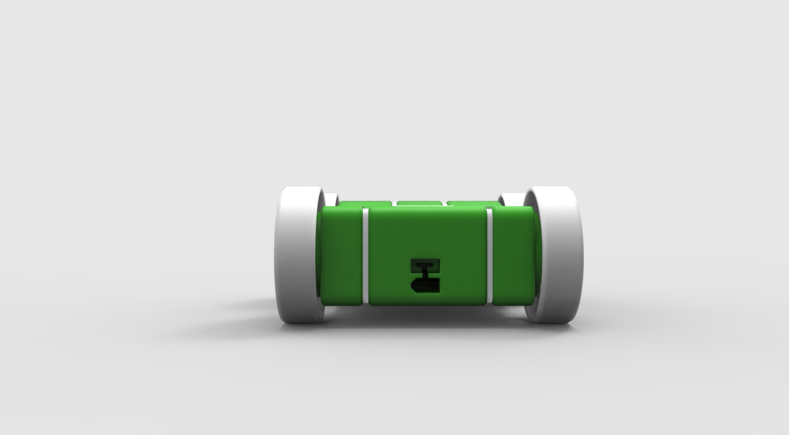
Documentation/Build a Raspberry Robot/render/pbb.jpg
