Waterfox/razbot/Documentation/Build a Raspberry Robot/render/pbf.jpg

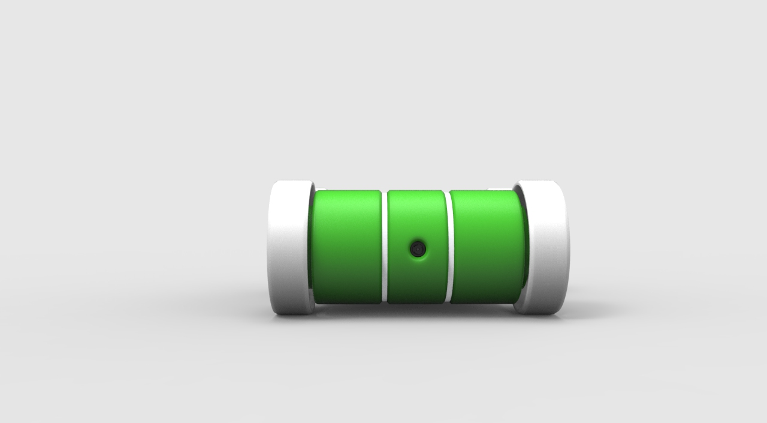
Documentation/Build a Raspberry Robot/render/pbf.jpg
