Waterfox/razbot/Documentation/Build a Raspberry Robot/render/pbs1.jpg

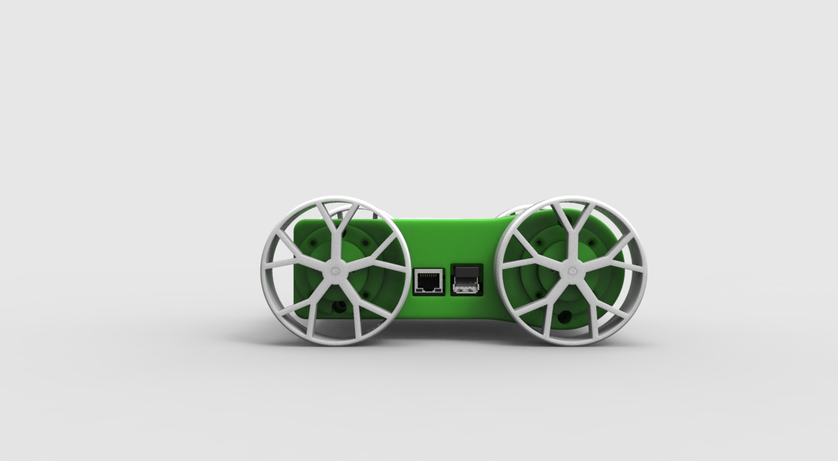
Documentation/Build a Raspberry Robot/render/pbs1.jpg
