Waterfox/razbot/Documentation/Build a Raspberry Robot/render/pbs2.jpg

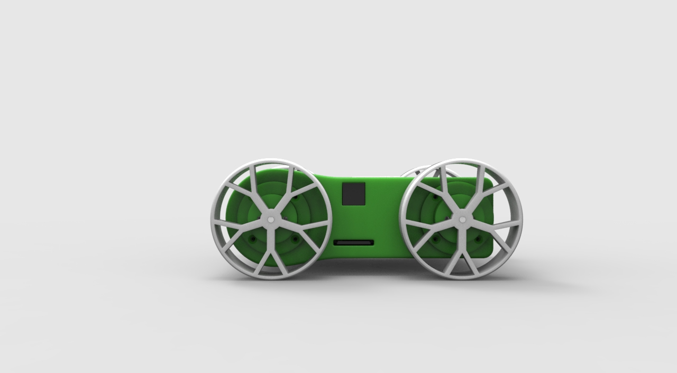
Documentation/Build a Raspberry Robot/render/pbs2.jpg
