Waterfox/razbot/Documentation/Build a Raspberry Robot/render/pibot.jpg

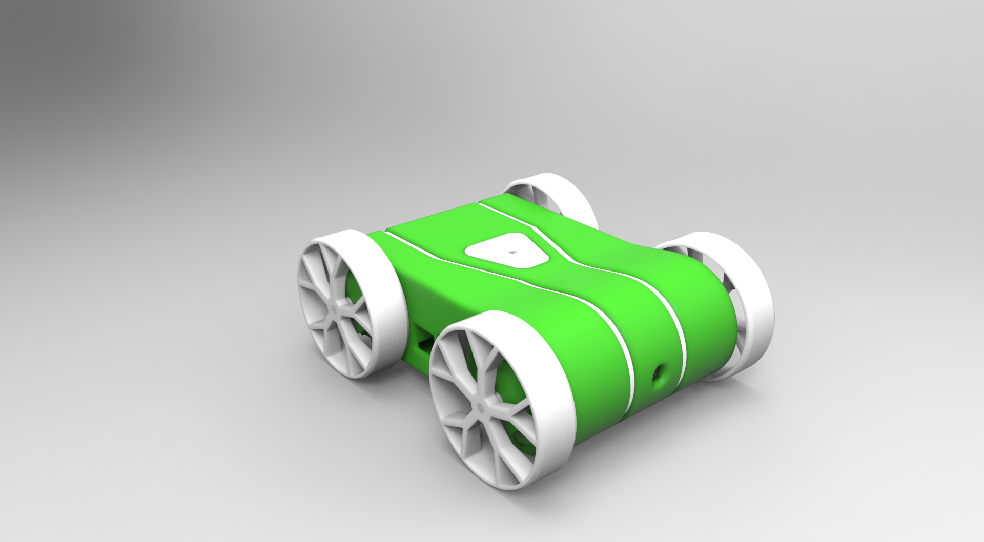
Documentation/Build a Raspberry Robot/render/pibot.jpg
