Waterfox/razbot/Documentation/Build a Raspberry Robot/render/PibotKeyshot.10.jpg

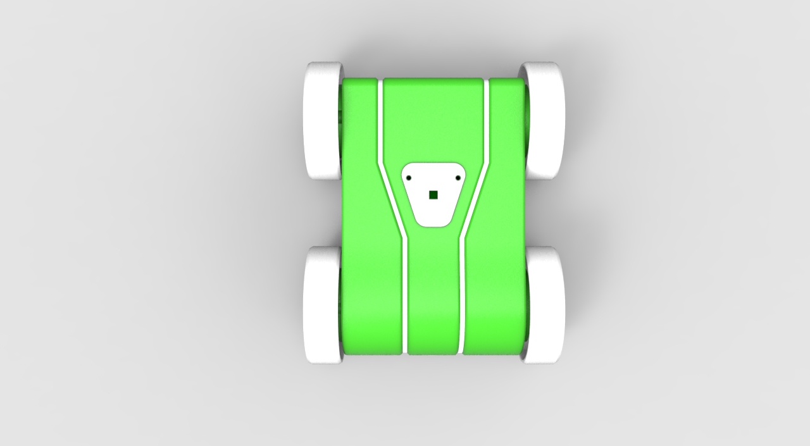
Documentation/Build a Raspberry Robot/render/PibotKeyshot.10.jpg
