Waterfox/razbot/razbot_Electronics/altium razbot/razbot.pdf

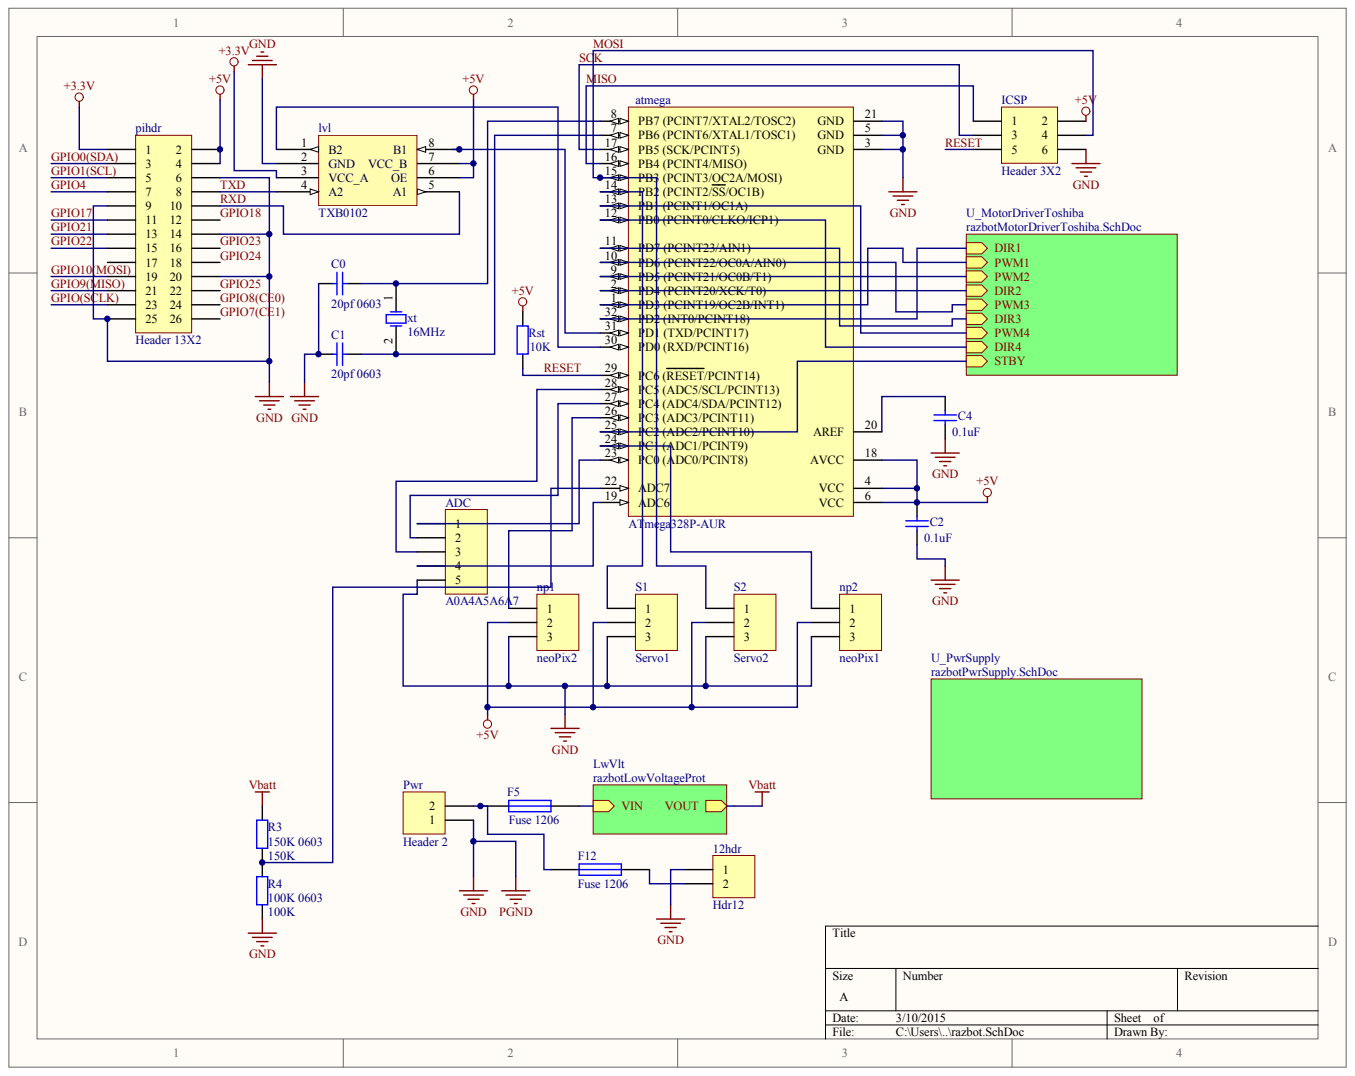
[picture p151: page 1]

MISO

atmega

PD3 (PCINT19/OC2B/INT1) 1
PD0 (RXD/PCINT16) 30 PD1 (TXD/PCINT17) 31 PD2 (INT0/PCINT18) 32

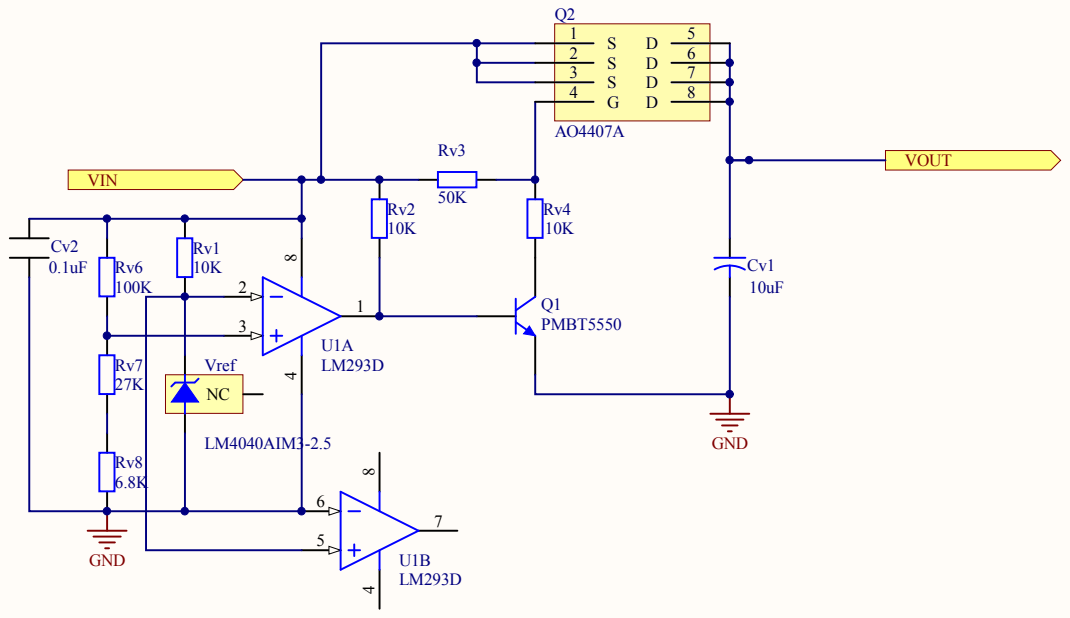
[picture p152: page 2]

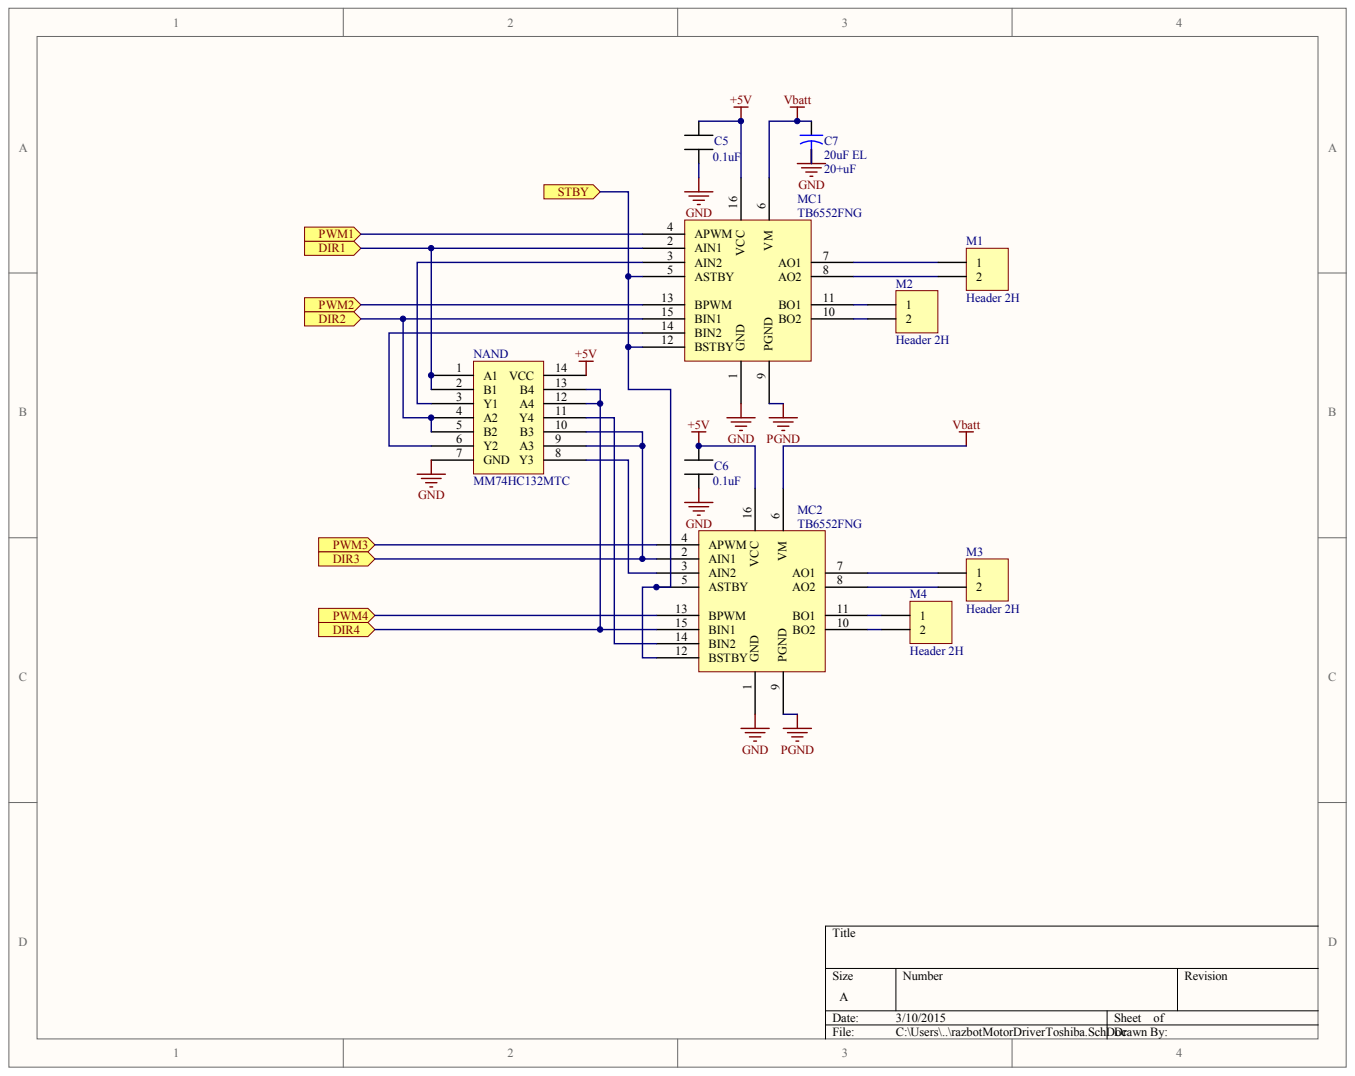
[picture p153: page 3]

AIN1 2

ASTBY 5

BIN2 14 BIN1 15

NAND +5V | | BSTBY 12

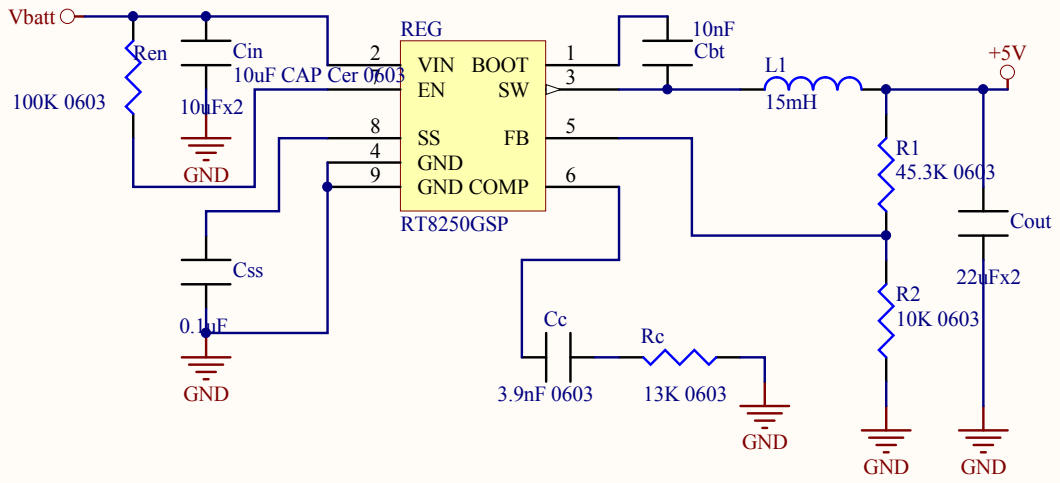
[picture p154: page 4]

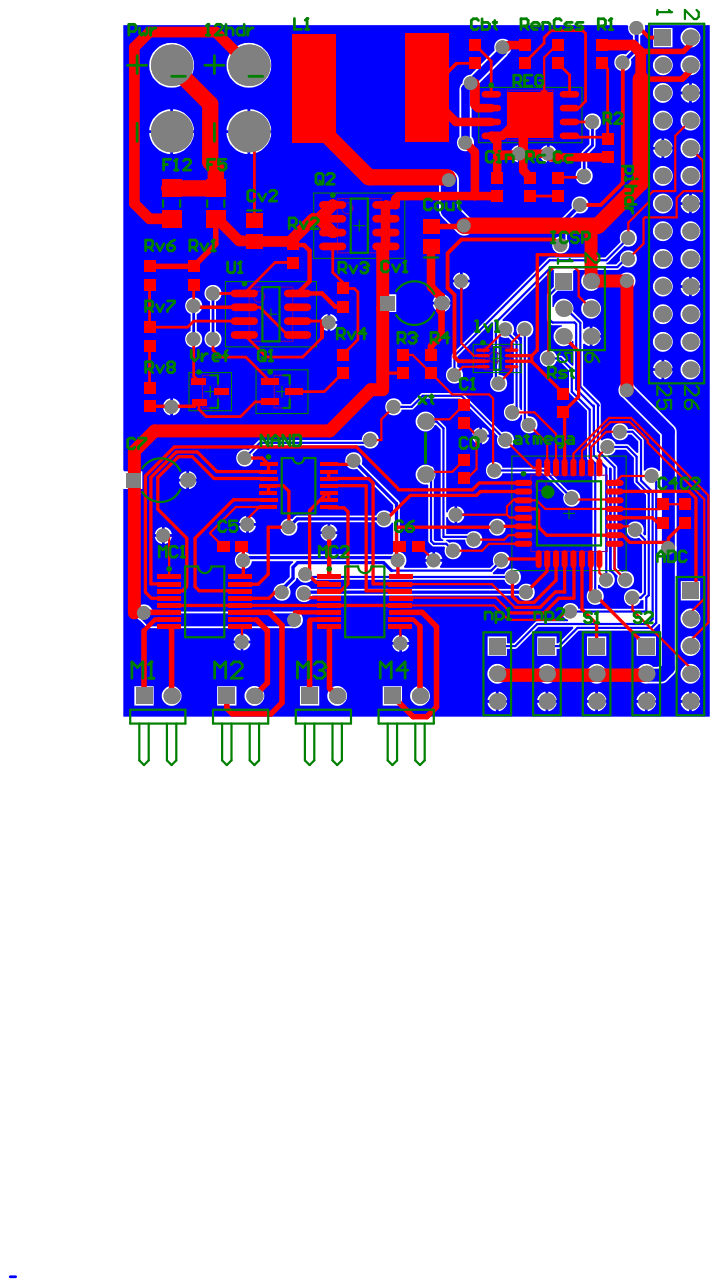
[picture p155: page 5]
