Waterfox/razbot/razbot_Electronics/altium razbot/razbot_V02_drw.pdf

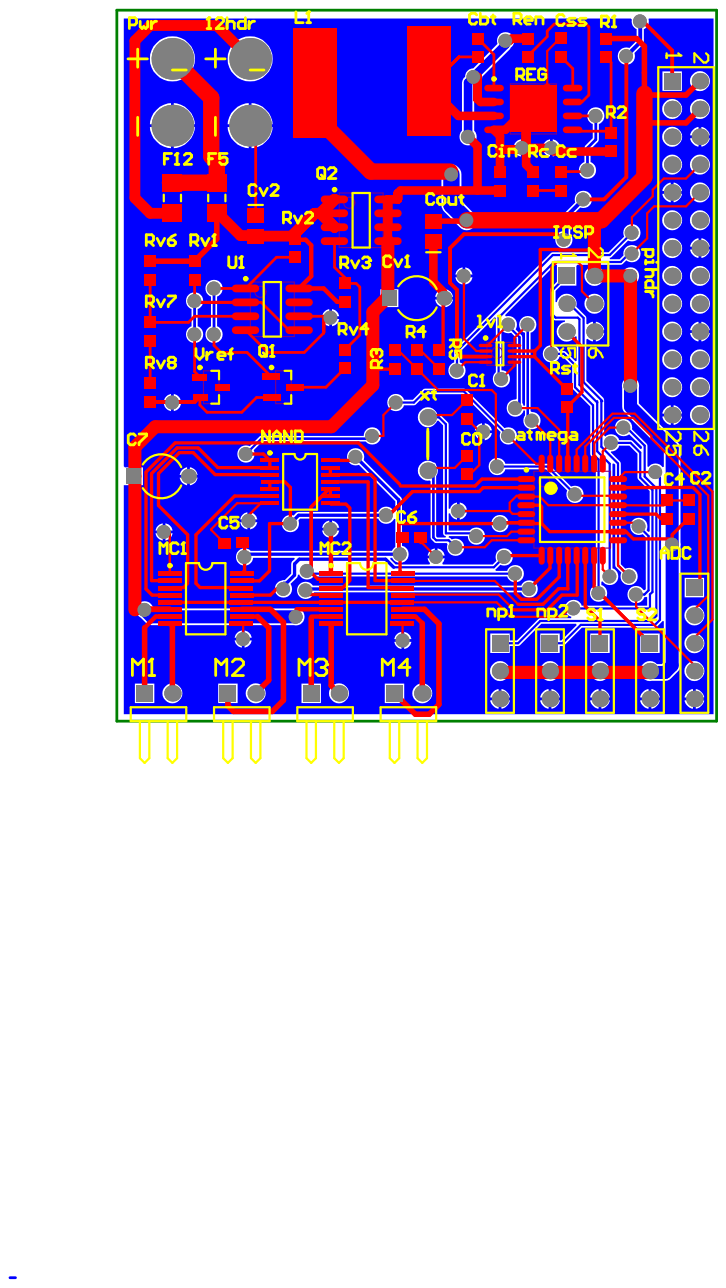
[picture p156: page 1]
