Waterfox/razbot/razbot_Electronics/altium razbot/razbot_V02.pdf

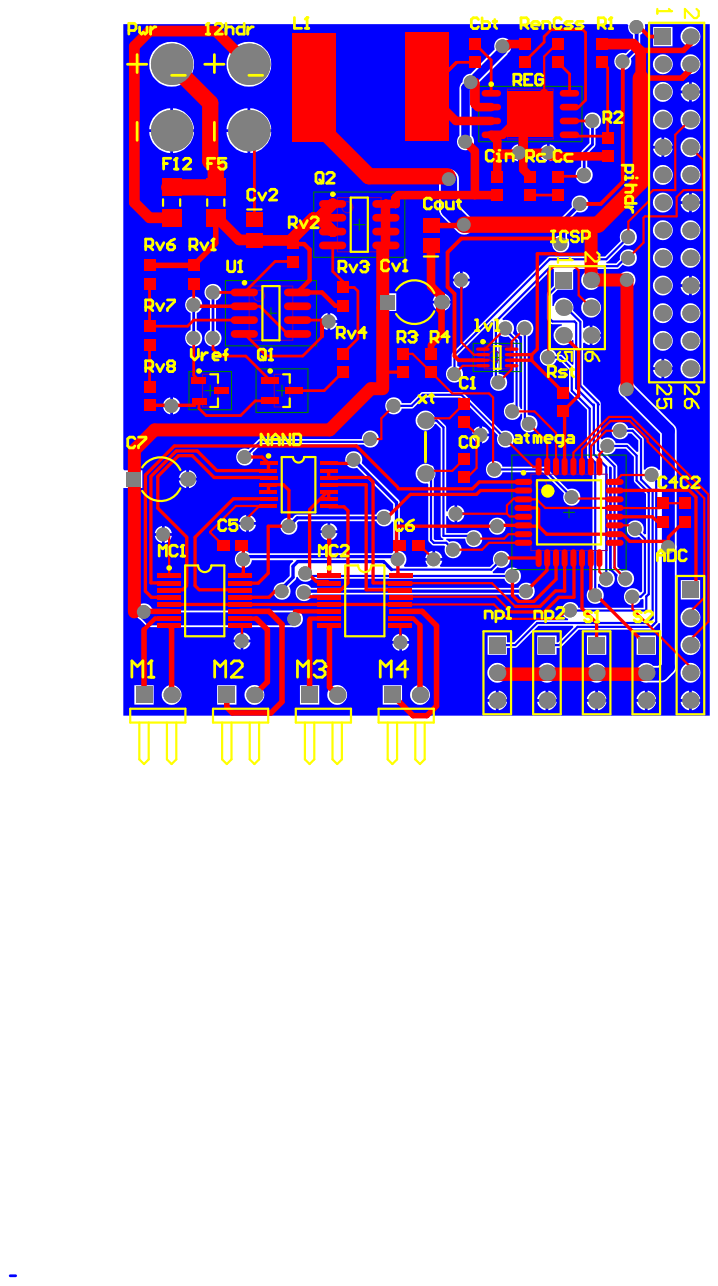
[picture p157: page 1]
