Waterfox/razbot/Documentation/Build a Raspberry Robot/diagram/motorconn.pdf

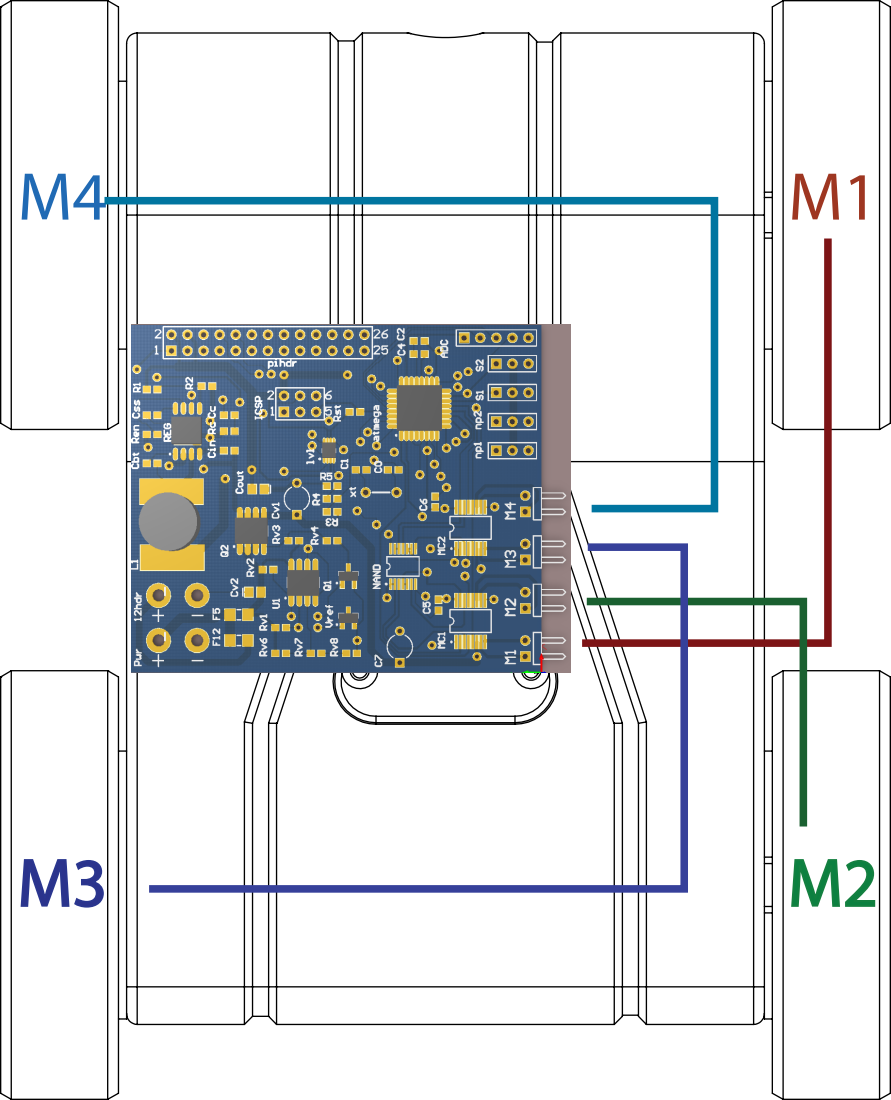
[picture p158: page 1]
