Waterfox/razbot/Documentation/Build a Raspberry Robot/diagram/top_view.PDF

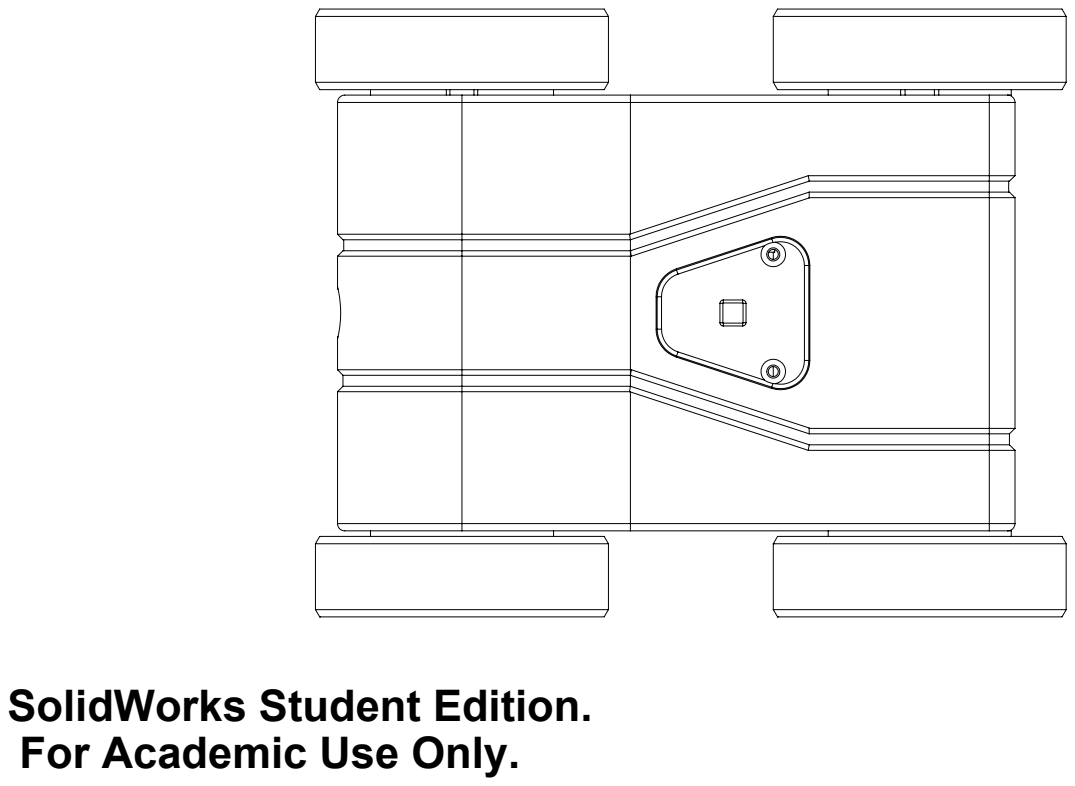
[picture p159: page 1]

SolidWorks Student Edition.
For Academic Use Only.
