Waterfox/razbot/Documentation/Build a Raspberry Robot/assem/step4.PDF

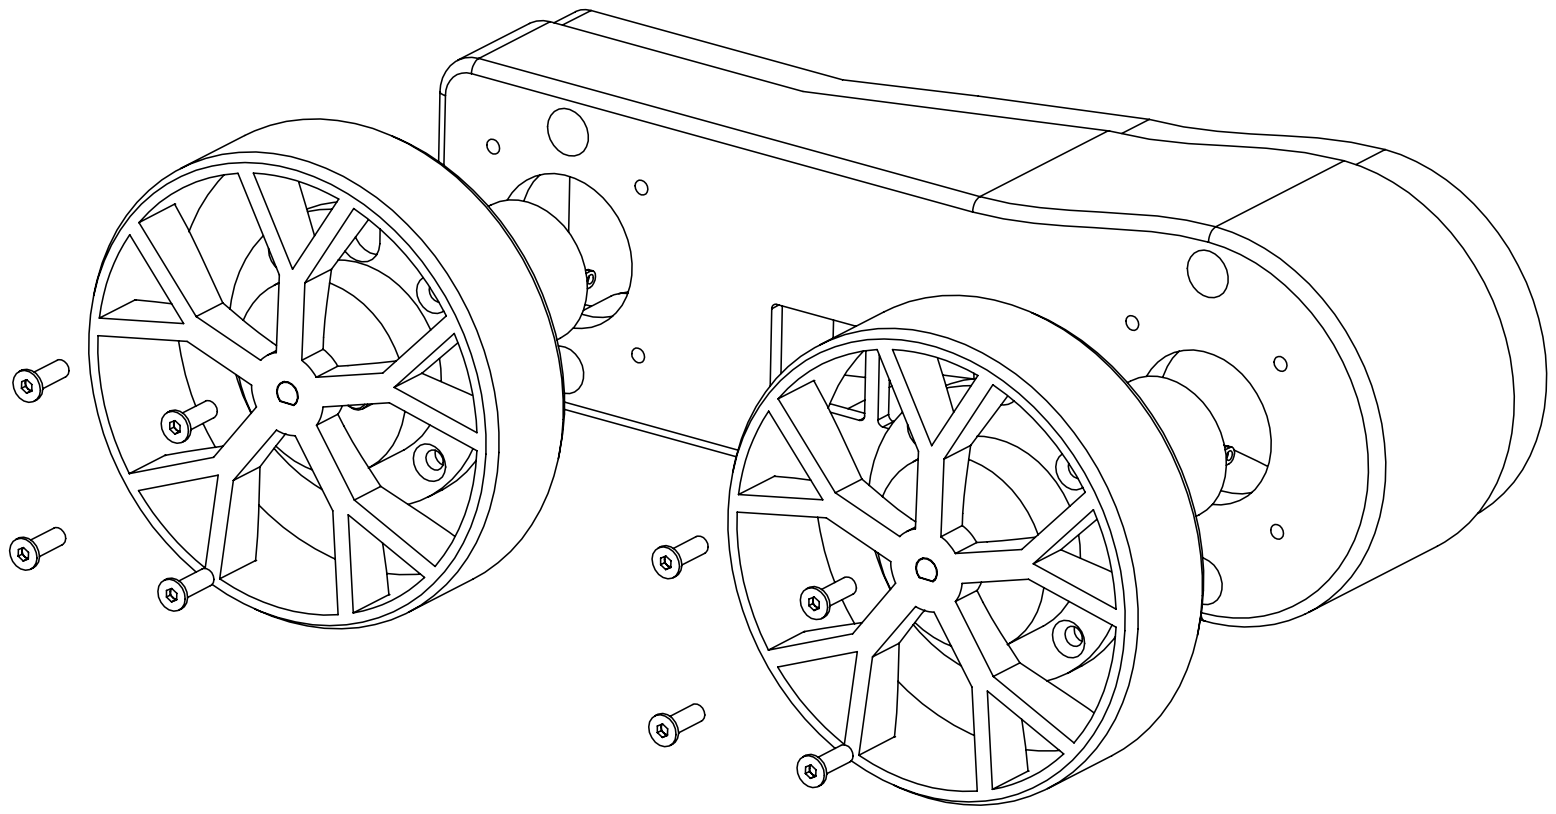
[picture p160: page 1]
