Waterfox/razbot/Documentation/Build a Raspberry Robot/assem/step1.pdf

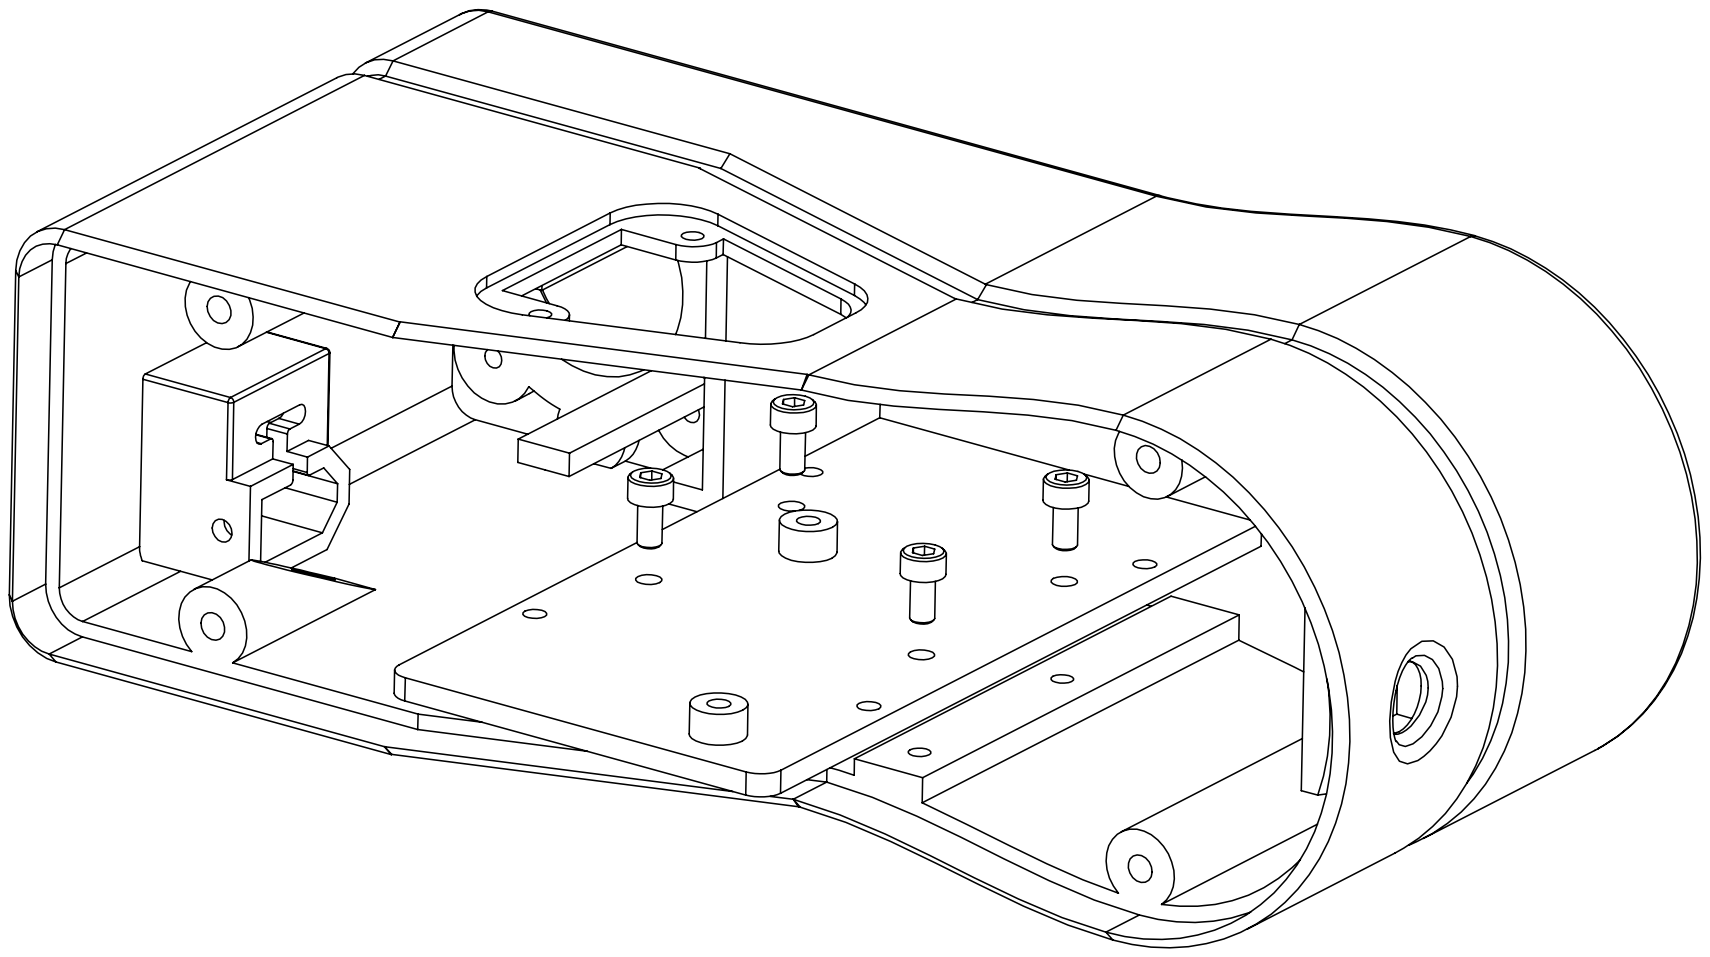
[picture p161: page 1]
