Waterfox/razbot/Documentation/Build a Raspberry Robot/assem/step2.PDF

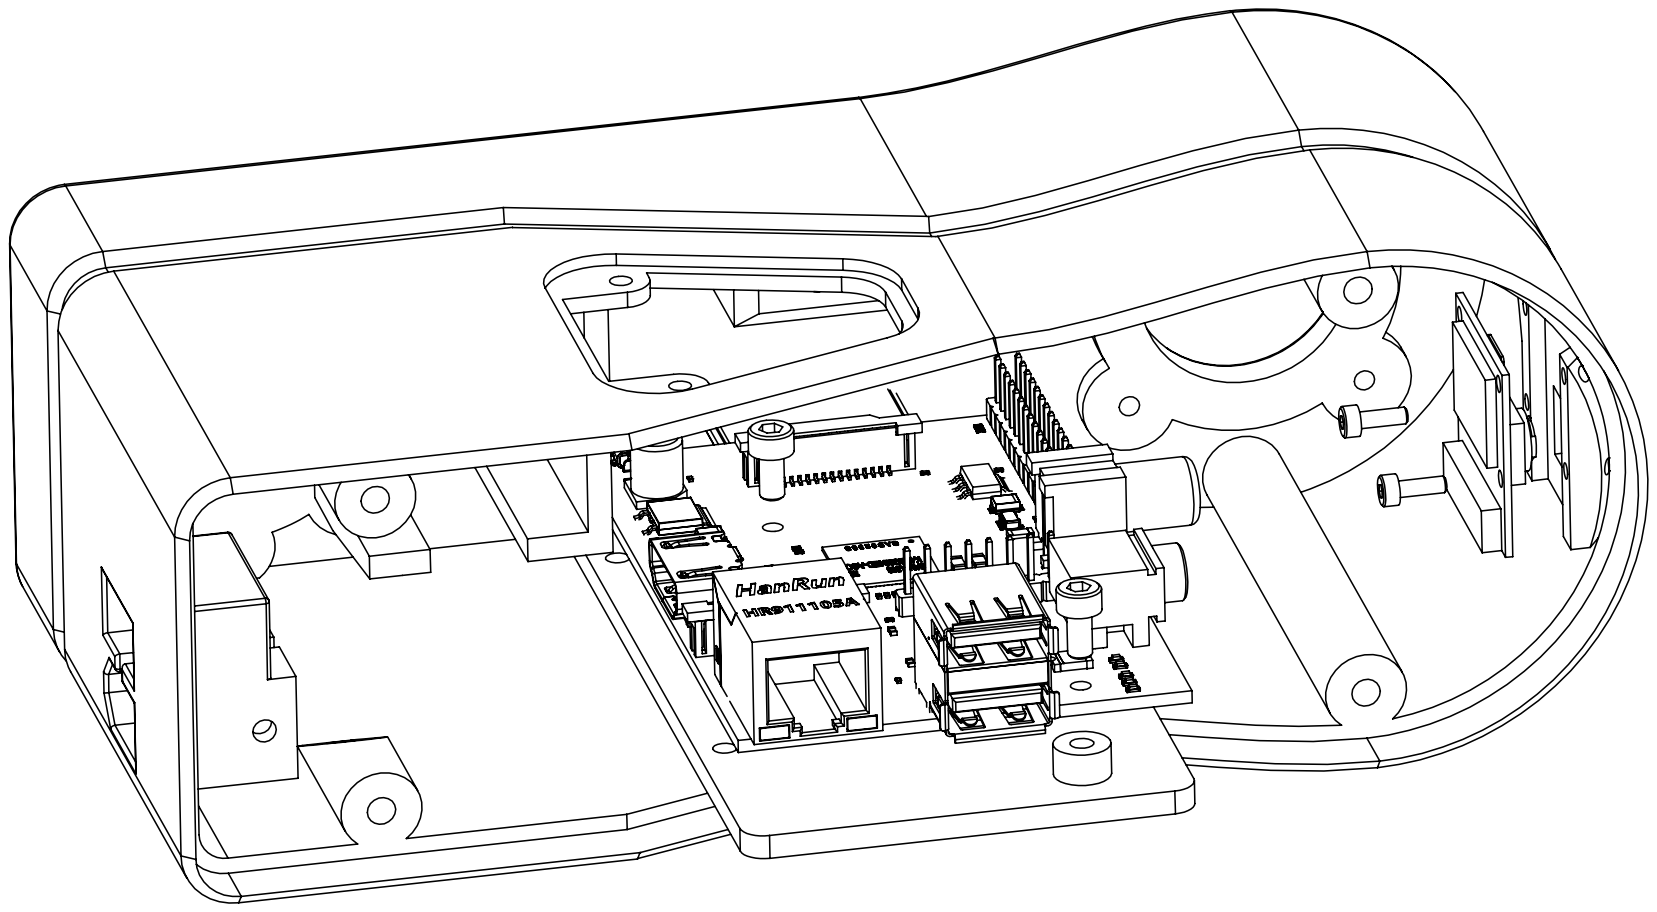
[picture p162: page 1]
