Waterfox/razbot/Documentation/Build a Raspberry Robot/assem/step3.PDF

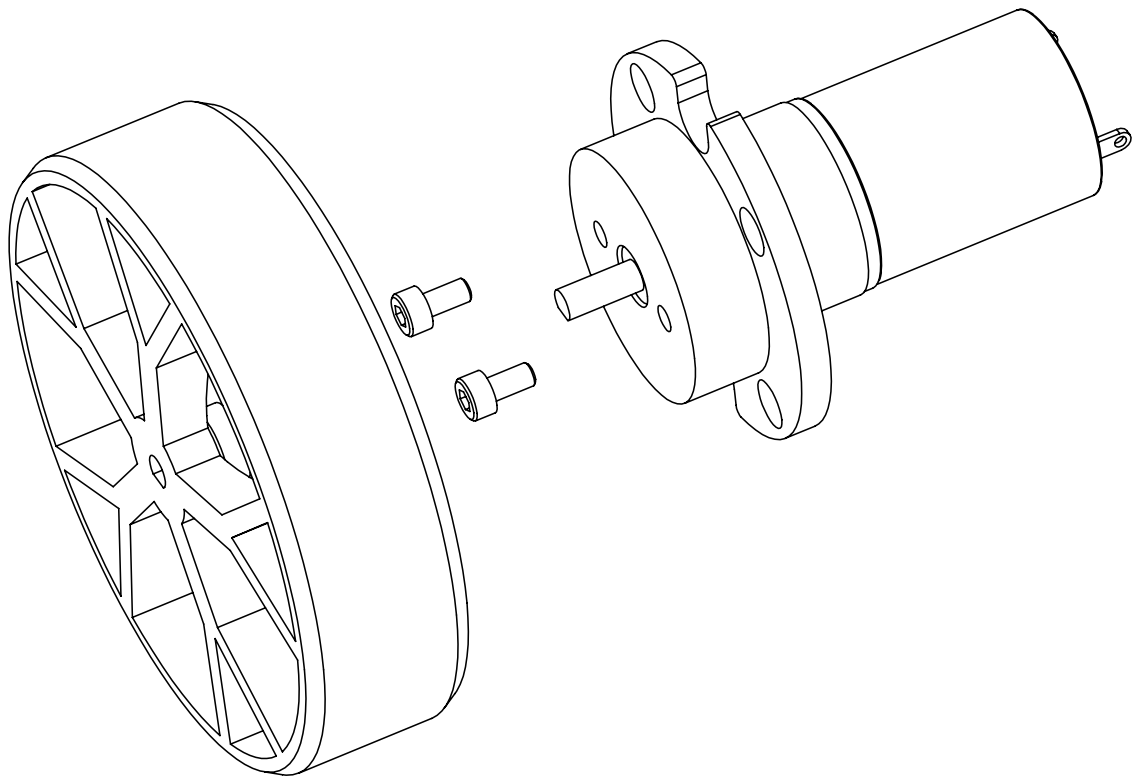
[picture p163: page 1]
