Waterfox/razbot/Documentation/Build a Raspberry Robot/diagram/FR_motor_holder.PDF

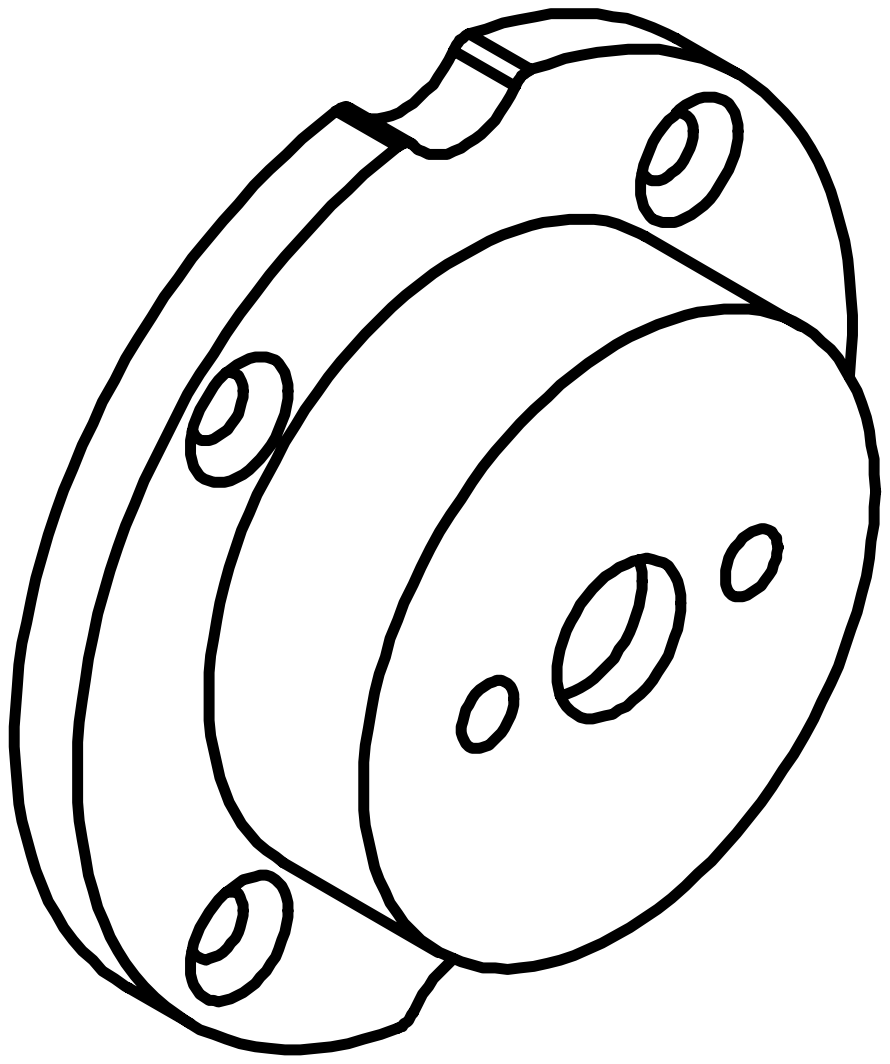
[picture p164: page 1]
