Waterfox/razbot/Documentation/Build a Raspberry Robot/diagram/L_motor_holder.PDF

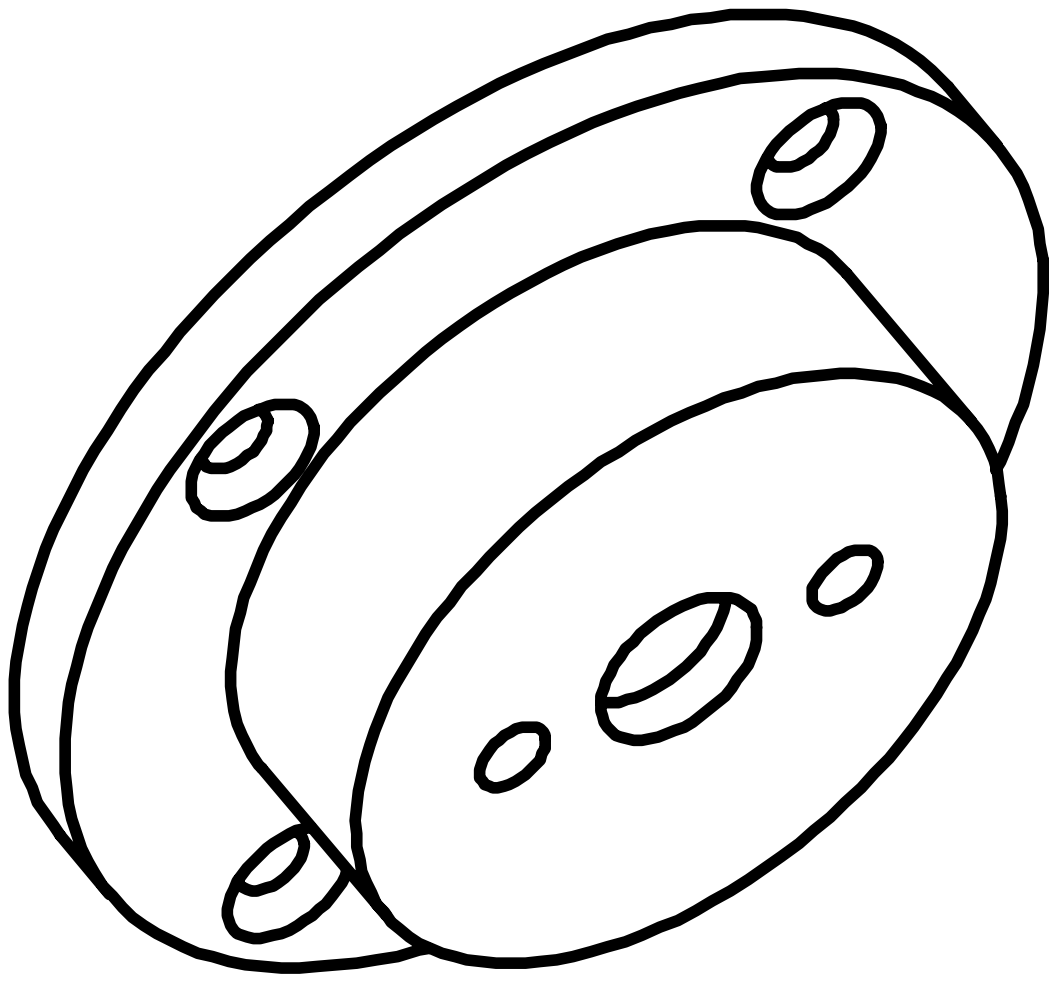
[picture p165: page 1]
