Waterfox/razbot/Documentation/Build a Raspberry Robot/diagram/PiTrayB.PDF

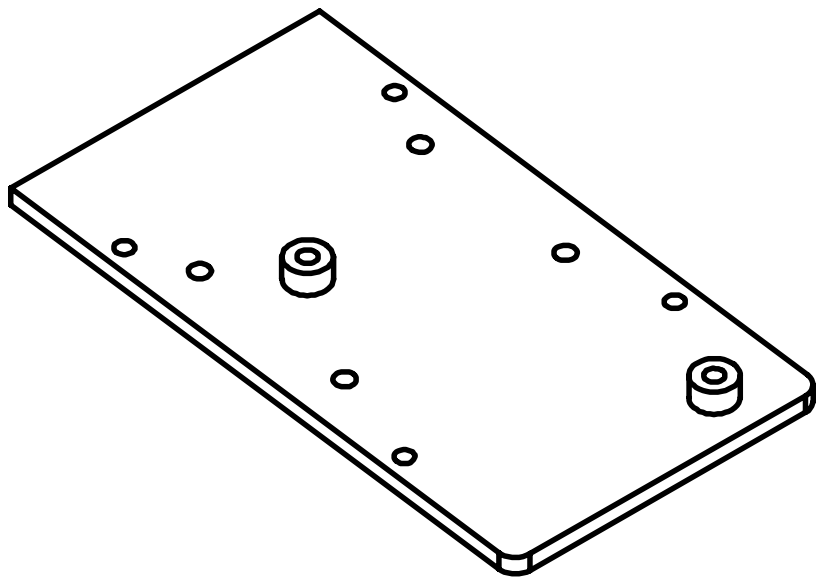
[picture p166: page 1]
