Waterfox/razbot/Documentation/Build a Raspberry Robot/diagram/RR_motor_holder.PDF

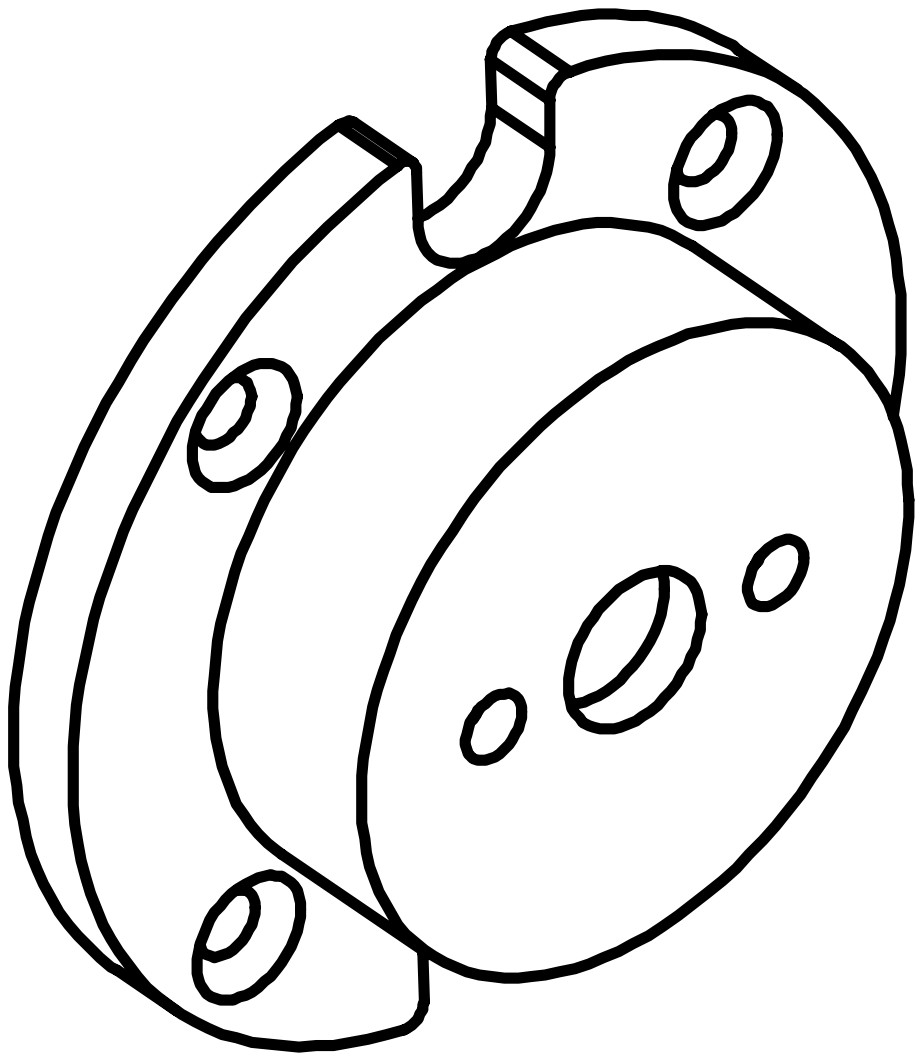
[picture p167: page 1]
