Waterfox/razbot/Documentation/Build a Raspberry Robot/diagram/Side_Left_V01.PDF

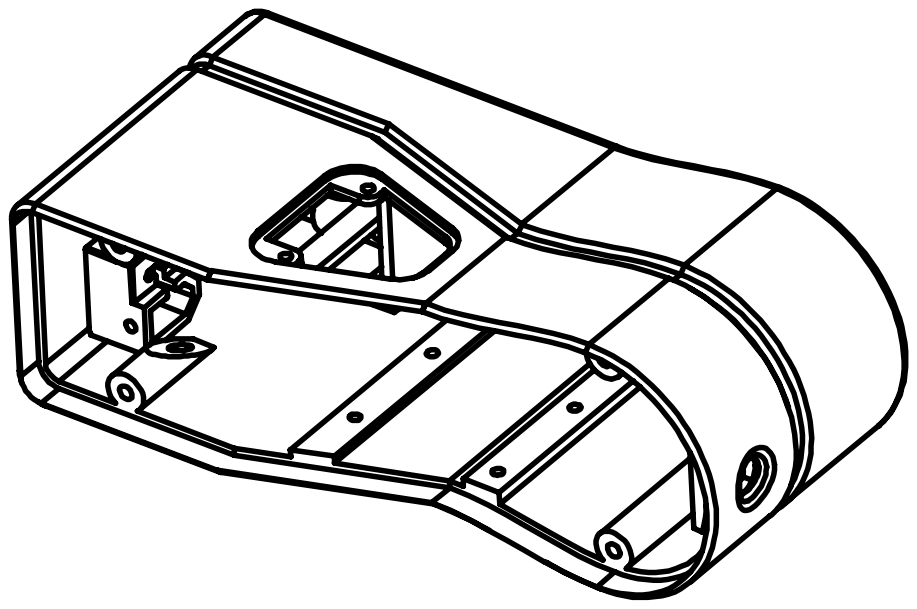
[picture p168: page 1]
