Waterfox/razbot/Documentation/Build a Raspberry Robot/diagram/Side_Right_V01.PDF

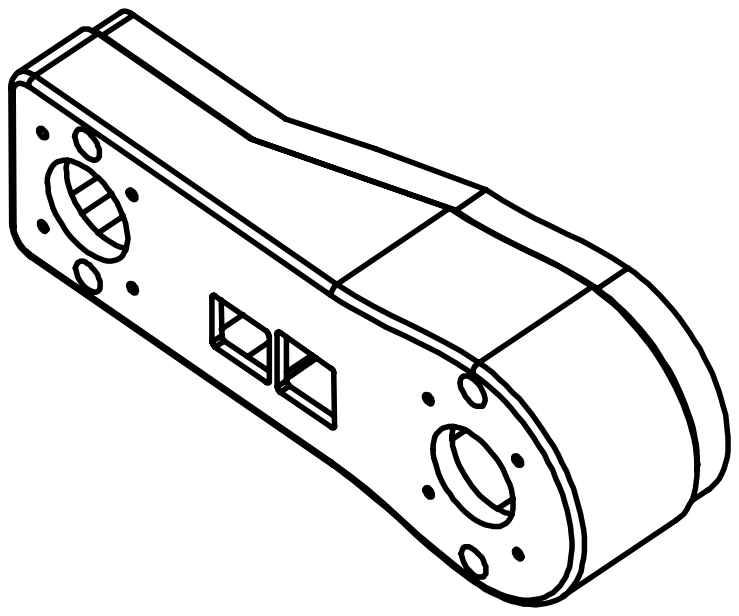
[picture p169: page 1]
