Waterfox/razbot/Documentation/Build a Raspberry Robot/diagram/Top_Plate.PDF

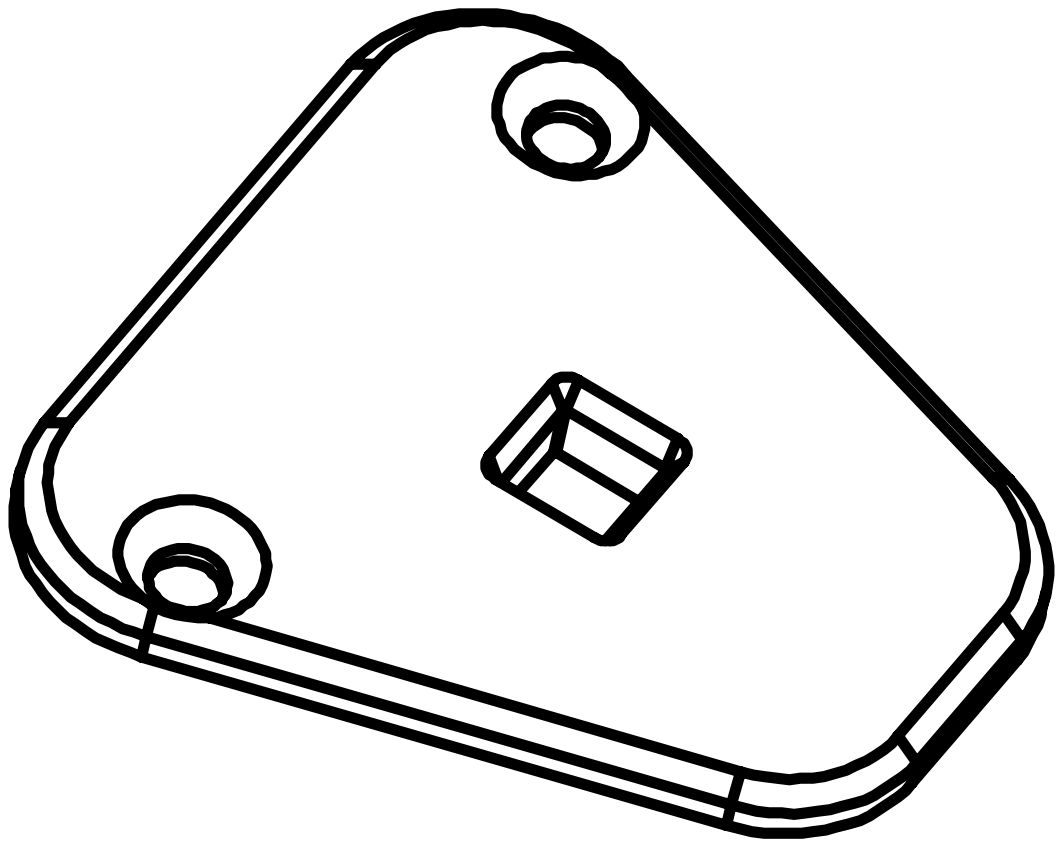
[picture p170: page 1]
