Waterfox/razbot/Documentation/Build a Raspberry Robot/diagram/Wheel.PDF

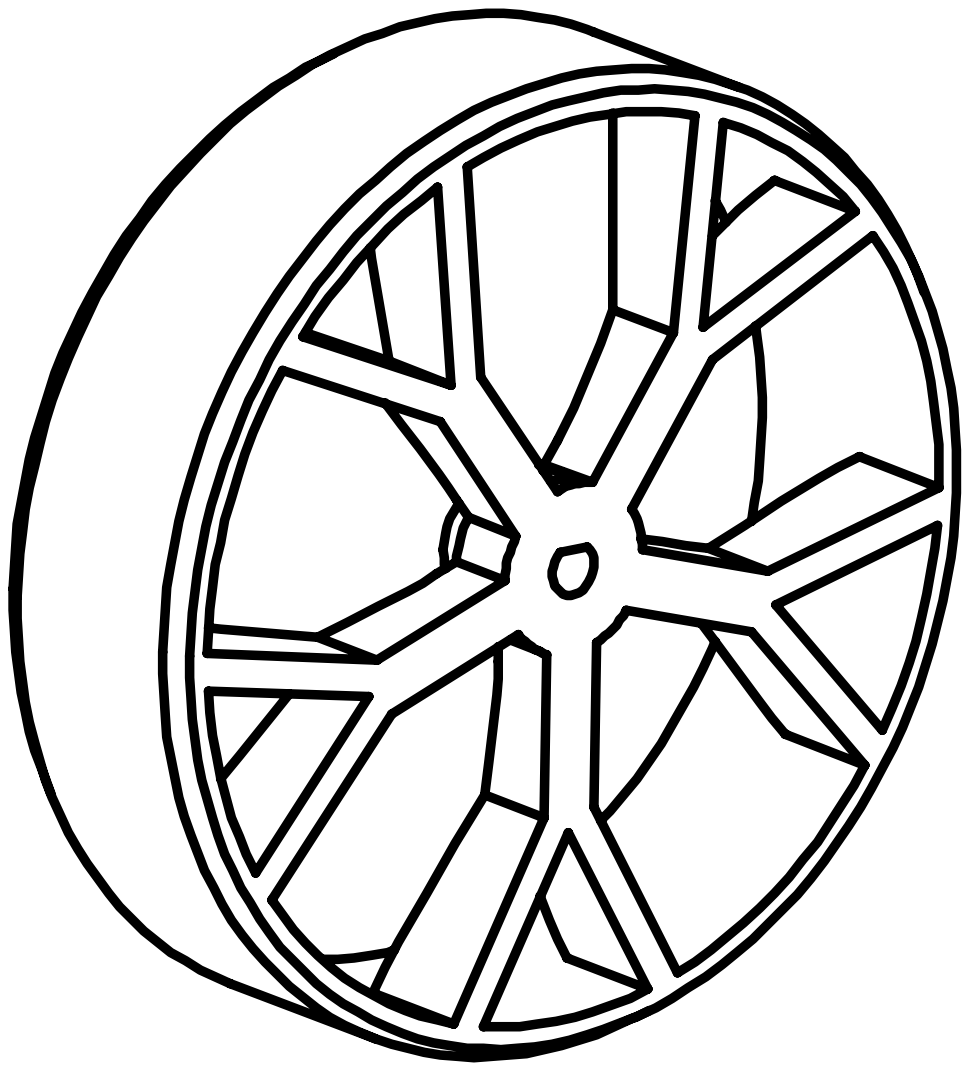
[picture p171: page 1]
