Waterfox/razbot/(list of files, drawings)

Other design files:
razbot_Electronics/_archive/Altium Pibot V01/History/MotorDriverL298.SchDoc
razbot_Electronics/_archive/Altium Pibot V01/History/RpiPaw1_Sch.SchDoc
razbot_Electronics/_archive/Altium Pibot V01/MotorDriverL298 (REs3's conflicted copy 2014-10-09).SchDoc
razbot_Electronics/_archive/Altium Pibot V01/MotorDriverL298.SchDoc
razbot_Electronics/_archive/Altium Pibot V01/MotorDriverToshiba.SchDoc
razbot_Electronics/_archive/Altium Pibot V01/Paw2.PcbDoc
razbot_Electronics/_archive/Altium Pibot V01/Paw3.PcbDoc
razbot_Electronics/_archive/Altium Pibot V01/paw4.PcbDoc
razbot_Electronics/_archive/Altium Pibot V01/paw5.PcbDoc
razbot_Electronics/_archive/Altium Pibot V01/paw6.PcbDoc
razbot_Electronics/_archive/Altium Pibot V01/paw7.PcbDoc
razbot_Electronics/_archive/Altium Pibot V01/paw8.PcbDoc
razbot_Electronics/_archive/Altium Pibot V01/Paw_Back.PcbDoc
razbot_Electronics/_archive/Altium Pibot V01/PawPcbLib1.PcbLib
razbot_Electronics/_archive/Altium Pibot V01/PwrSupply.SchDoc
razbot_Electronics/_archive/Altium Pibot V01/RpiPaw1.PrjPCB
razbot_Electronics/_archive/Altium Pibot V01/RpiPaw1_Sch.SchDoc
razbot_Electronics/_archive/Altium Pibot V01/RpiPaw1_SchLib.SchLib
razbot_Electronics/altium razbot/History/razbot_V02.~(64).PcbDoc
razbot_Electronics/altium razbot/History/razbot_V02.~(65).PcbDoc
razbot_Electronics/altium razbot/razbot.PrjPCB
razbot_Electronics/altium razbot/razbot.SchDoc
razbot_Electronics/altium razbot/razbot_SchLib.SchLib
razbot_Electronics/altium razbot/razbot_V01.PcbDoc
razbot_Electronics/altium razbot/razbot_V02.PcbDoc
razbot_Electronics/altium razbot/razbotLowVoltageProt.SchDoc
razbot_Electronics/altium razbot/razbotMotorDriverToshiba.SchDoc
razbot_Electronics/altium razbot/razbotPcbLib1.PcbLib
razbot_Electronics/altium razbot/razbotPwrSupply.SchDoc
