Waterfox/razbot/razbot_Software_MCU/ros_lib/ros_lib/control_msgs/GripperCommand.h

#ifndef _ROS_control_msgs_GripperCommand_h
#define _ROS_control_msgs_GripperCommand_h

#include <stdint.h>
#include <string.h>
#include <stdlib.h>
#include "ros/msg.h"

namespace control_msgs
{

  class GripperCommand : public ros::Msg
  {
    public:
      float position;
      float max_effort;

    virtual int serialize(unsigned char *outbuffer) const
    {
      int offset = 0;
      offset += serializeAvrFloat64(outbuffer + offset, this->position);
      offset += serializeAvrFloat64(outbuffer + offset, this->max_effort);
      return offset;
    }

    virtual int deserialize(unsigned char *inbuffer)
    {
      int offset = 0;
      offset += deserializeAvrFloat64(inbuffer + offset, &(this->position));
      offset += deserializeAvrFloat64(inbuffer + offset, &(this->max_effort));
     return offset;
    }

    const char * getType(){ return "control_msgs/GripperCommand"; };
    const char * getMD5(){ return "680acaff79486f017132a7f198d40f08"; };

  };

}
#endif
