Waterfox/razbot/razbot_Software_MCU/ros_lib/ros_lib/moveit_msgs/MoveGroupActionFeedback.h

#ifndef _ROS_moveit_msgs_MoveGroupActionFeedback_h
#define _ROS_moveit_msgs_MoveGroupActionFeedback_h

#include <stdint.h>
#include <string.h>
#include <stdlib.h>
#include "ros/msg.h"
#include "std_msgs/Header.h"
#include "actionlib_msgs/GoalStatus.h"
#include "moveit_msgs/MoveGroupFeedback.h"

namespace moveit_msgs
{

  class MoveGroupActionFeedback : public ros::Msg
  {
    public:
      std_msgs::Header header;
      actionlib_msgs::GoalStatus status;
      moveit_msgs::MoveGroupFeedback feedback;

    virtual int serialize(unsigned char *outbuffer) const
    {
      int offset = 0;
      offset += this->header.serialize(outbuffer + offset);
      offset += this->status.serialize(outbuffer + offset);
      offset += this->feedback.serialize(outbuffer + offset);
      return offset;
    }

    virtual int deserialize(unsigned char *inbuffer)
    {
      int offset = 0;
      offset += this->header.deserialize(inbuffer + offset);
      offset += this->status.deserialize(inbuffer + offset);
      offset += this->feedback.deserialize(inbuffer + offset);
     return offset;
    }

    const char * getType(){ return "moveit_msgs/MoveGroupActionFeedback"; };
    const char * getMD5(){ return "12232ef97486c7962f264c105aae2958"; };

  };

}
#endif
