Waterfox/razbot/razbot_Software_MCU/ros_lib/ros_lib/moveit_msgs/MoveGroupActionGoal.h

#ifndef _ROS_moveit_msgs_MoveGroupActionGoal_h
#define _ROS_moveit_msgs_MoveGroupActionGoal_h

#include <stdint.h>
#include <string.h>
#include <stdlib.h>
#include "ros/msg.h"
#include "std_msgs/Header.h"
#include "actionlib_msgs/GoalID.h"
#include "moveit_msgs/MoveGroupGoal.h"

namespace moveit_msgs
{

  class MoveGroupActionGoal : public ros::Msg
  {
    public:
      std_msgs::Header header;
      actionlib_msgs::GoalID goal_id;
      moveit_msgs::MoveGroupGoal goal;

    virtual int serialize(unsigned char *outbuffer) const
    {
      int offset = 0;
      offset += this->header.serialize(outbuffer + offset);
      offset += this->goal_id.serialize(outbuffer + offset);
      offset += this->goal.serialize(outbuffer + offset);
      return offset;
    }

    virtual int deserialize(unsigned char *inbuffer)
    {
      int offset = 0;
      offset += this->header.deserialize(inbuffer + offset);
      offset += this->goal_id.deserialize(inbuffer + offset);
      offset += this->goal.deserialize(inbuffer + offset);
     return offset;
    }

    const char * getType(){ return "moveit_msgs/MoveGroupActionGoal"; };
    const char * getMD5(){ return "5a63f1e432efa5831f25bdbf4067e372"; };

  };

}
#endif
