Waterfox/razbot/razbot_Software_MCU/ros_lib/ros_lib/sensor_msgs/NavSatFix.h

#ifndef _ROS_sensor_msgs_NavSatFix_h
#define _ROS_sensor_msgs_NavSatFix_h

#include <stdint.h>
#include <string.h>
#include <stdlib.h>
#include "ros/msg.h"
#include "std_msgs/Header.h"
#include "sensor_msgs/NavSatStatus.h"

namespace sensor_msgs
{

  class NavSatFix : public ros::Msg
  {
    public:
      std_msgs::Header header;
      sensor_msgs::NavSatStatus status;
      float latitude;
      float longitude;
      float altitude;
      float position_covariance[9];
      uint8_t position_covariance_type;
      enum { COVARIANCE_TYPE_UNKNOWN =  0 };
      enum { COVARIANCE_TYPE_APPROXIMATED =  1 };
      enum { COVARIANCE_TYPE_DIAGONAL_KNOWN =  2 };
      enum { COVARIANCE_TYPE_KNOWN =  3 };

    virtual int serialize(unsigned char *outbuffer) const
    {
      int offset = 0;
      offset += this->header.serialize(outbuffer + offset);
      offset += this->status.serialize(outbuffer + offset);
      offset += serializeAvrFloat64(outbuffer + offset, this->latitude);
      offset += serializeAvrFloat64(outbuffer + offset, this->longitude);
      offset += serializeAvrFloat64(outbuffer + offset, this->altitude);
      for( uint8_t i = 0; i < 9; i++){
      offset += serializeAvrFloat64(outbuffer + offset, this->position_covariance[i]);
      }
      *(outbuffer + offset + 0) = (this->position_covariance_type >> (8 * 0)) & 0xFF;
      offset += sizeof(this->position_covariance_type);
      return offset;
    }

    virtual int deserialize(unsigned char *inbuffer)
    {
      int offset = 0;
      offset += this->header.deserialize(inbuffer + offset);
      offset += this->status.deserialize(inbuffer + offset);
      offset += deserializeAvrFloat64(inbuffer + offset, &(this->latitude));
      offset += deserializeAvrFloat64(inbuffer + offset, &(this->longitude));
      offset += deserializeAvrFloat64(inbuffer + offset, &(this->altitude));
      for( uint8_t i = 0; i < 9; i++){
      offset += deserializeAvrFloat64(inbuffer + offset, &(this->position_covariance[i]));
      }
      this->position_covariance_type =  ((uint8_t) (*(inbuffer + offset)));
      offset += sizeof(this->position_covariance_type);
     return offset;
    }

    const char * getType(){ return "sensor_msgs/NavSatFix"; };
    const char * getMD5(){ return "2d3a8cd499b9b4a0249fb98fd05cfa48"; };

  };

}
#endif
