Waterfox/razbot/(commit log)

2015-03-08 working on routing
    [PiTrayB+.SLDPRT, PiTrayB+.STL, razbot.PrjPCB, razbot.SchDoc, razbot_V02.PcbDoc, razbot_V02_preauto.PcbDoc]
2015-03-11 more BOM, better documentation
    [razbot.PrjPCB, razbotLowVoltageProt.SchDoc, razbot_BOM.xlsx, razbot_V02.PcbDoc, razbot_V02_backup1.PcbDoc]
2015-03-14 updated pcb for pi2
    [razbot.PrjPCB, razbot.SchDoc, razbotLowVoltageProt.SchDoc, razbot_BOM.xlsx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]
2015-03-28 updated documentation
    [razbot.PrjPCB, razbot_BOM.xlsx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]
2015-07-30 updated to SW15
    [3S2200mAhLIPO.SLDPRT, Motor_25x55_gear.SLDPRT, OVA5647.SLDASM, OVA5647.SLDPRT, OVA5647_IR-Glas.SLDPRT, OVA5647_Lens.SLDPRT, PiTrayB.SLDPRT, RasPi_Camera.SLDASM]
